PythonOrC/ISEF/Research Paper/research paper.tex

\documentclass[twoside]{article}
\usepackage{biblatex} %Imports biblatex package
\addbibresource{snake.bib}
\usepackage{blindtext} % Package to generate dummy text throughout this template 
\usepackage{amsmath}
\usepackage[sc]{mathpazo} % Use the Palatino font
\usepackage[T1]{fontenc} % Use 8-bit encoding that has 256 glyphs
\linespread{1.05} % Line spacing - Palatino needs more space between lines
\usepackage{microtype} % Slightly tweak font spacing for aesthetics

\usepackage[english]{babel} % Language hyphenation and typographical rules
\usepackage[hmarginratio=1:1,top=32mm,columnsep=20pt]{geometry} % Document margins
\usepackage[hang, small,labelfont=bf,up,textfont=it,up]{caption} % Custom captions under/above floats in tables or figures
\usepackage{booktabs} % Horizontal rules in tables

\usepackage{lettrine} % The lettrine is the first enlarged letter at the beginning of the text
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

\tikzstyle{startstop} = [rectangle, rounded corners, 
minimum width=3cm, 
minimum height=1cm,
text centered, 
draw=black, 
fill=red!30]

\tikzstyle{coord} = [
coordinate, 
node distance=2cm
]

\tikzstyle{io} = [trapezium, 
trapezium stretches=true, % A later addition
trapezium left angle=70, 
trapezium right angle=110, 
minimum width=3cm, 
minimum height=1cm, text centered, 
text width=3cm,
draw=black, fill=blue!30]

\tikzstyle{process} = [rectangle, 
minimum width=3cm, 
minimum height=1cm, 
text centered, 
text width=3cm,
draw=black, 
fill=orange!30]

\tikzstyle{decision} = [diamond, 
minimum width=4cm, 
minimum height=2cm, 
text centered, 
aspect=2,
draw=black, 
text width=3.5cm,
fill=green!30]

\tikzstyle{arrow} = [thick,->,>=stealth]
\usepackage[colorinlistoftodos]{todonotes}
\usepackage{hyperref} % For hyperlinks in the PDF
\graphicspath{{images/}}
\counterwithin{figure}{section}
\renewcommand{\thefigure}{\arabic{section}.\arabic{figure}}
\usepackage{parskip}
\counterwithin{table}{section}
\renewcommand{\thetable}{\arabic{section}.\arabic{table}}
\usepackage{pgfplots}
\pgfplotsset{compat=1.11}
%----------------------------------------------------------------------------------------
%	TITLE SECTION
%----------------------------------------------------------------------------------------

\setlength{\droptitle}{-4\baselineskip} % Move the title up

\pretitle{\begin{center}\Huge\bfseries} % Article title formatting
\posttitle{\end{center}} % Article title closing formatting
\title{Research on a multi-degree-of-freedom modular soft snake robot} % Article title
\author{%
\textsc{Ethan Hu} \\[1ex] % Your name
\normalsize The Overlake School \\ % Your institution
\normalsize \href{mailto:ethanhu8351@gmail.com}{ethanhu8351@gmail.com} % Your email address
%\and % Uncomment if 2 authors are required, duplicate these 4 lines if more
%\textsc{Jane Smith}\thanks{Corresponding author} \\[1ex] % Second author's name
%\normalsize University of Utah \\ % Second author's institution
%\normalsize \href{mailto:jane@smith.com}{jane@smith.com} % Second author's email address
}
\date{\today} % Leave empty to omit a date
\renewcommand{\maketitlehookd}{%
\begin{abstract}
\noindent 
	Soft-body robots have always received less attention compared to other branches of robotics. However, this does not suggest that they are any less capable than traditional robots due to their extreme flexibility. Soft robots commercially can be used in medical situations and with human interaction. This includes deployment into a human's body. However, the use case also extends into disaster relief situations. The flexibility of soft robots gives them an advantage over rigid robots when they are navigating through narrow spaces. Because of this flexibility, designing an optimized and sturdy system is difficult. In this paper, I proposed a new soft-body snake that is more optimized for real-life situations.
	
	The goal of this study is to create a better version of the soft robotic snakes already developed. This can be divided into two parts: software, and hardware. The software part would include software on the robot, and software on controller. The robot will send a video stream from the camera back to the controller, which will be a phone, as it is both lightweight and accessible. The user can also control the robot via the built-in controls through WiFi.
	
	The goal for the hardware part of the robot is to implement a more efficient flexible structure that better utilizes the air pressure and moves more controllably. The structures previous soft robotic snakes utilize is requires high air pressure and the expansion is rather uncontrolled and unideal. The structure is also very complicated and the connection between the flexible and rigid parts is hard to work with, not to mention the difficulties with preventing leakage of air with those structures.
\end{abstract}
}

%----------------------------------------------------------------------------------------

\begin{document}

% Print the title
\maketitle

%----------------------------------------------------------------------------------------
%	ARTICLE CONTENTS
%----------------------------------------------------------------------------------------

\section{Introduction}
\subsection{Background}
\lettrine[nindent=0em,lines=3]{E} very second counts after a disaster yet rescue teams cannot always get to places needing the most help right away due to obstacles and often dangers. This could include collapsed buildings, flooded tunnels, ablaze rooms, etc. To shorten the time between the disaster providing aid, mere human isn't enough. Specialized robots for different deadly environments are needed to support the rescue effort better. 

Collapsed buildings can be seen anywhere after almost all types of disasters — earthquakes, hurricanes, tsunamis, etc. Clearing a path through tons of debris is both time-consuming and laborious. To explore this environment more efficiently and more easily, a much smaller robot, and much more suited for this situation is needed — a soft robotic snake.

Soft robotic snakes are a type of soft robots that can imitate the capabilities of biological snakes, such as flexibility, adaptability, and locomotion \cite{bsf20}\cite{rt15}. Soft robotic snakes have potential applications in inspection, search-and-rescue, disaster response, and medical fields \cite{lwsstcgyo20}\cite{wsqsglfo}. They are naturally perfect for slithering through tight gaps and small tubes that the rescuers would otherwise be unable to cross. This could drastically speed up the exploration of ruined areas and the time takes to get to the ones needing help. Although this cannot fully replace the purpose of human rescuers and the need to clear up the area to people, this can provide some emergent aid while the main rescue force is on its way. 

\begin{figure}
\centering
\begin{subfigure}[b]{0.45\linewidth}
	\centering
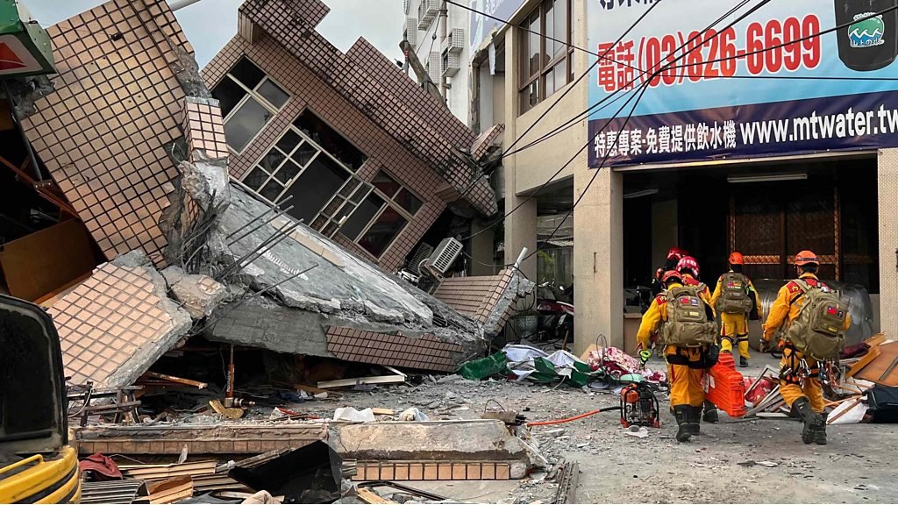
[picture p62: Research Paper/images/ruins.jpg]
	
	\subcaption{Collapsed building after earthquake can be especially dangerous for rescuers}
\end{subfigure}
\begin{subfigure}[b]{0.45\linewidth}
	\centering
	
	\subcaption{Some narrow passages are so small that rescuers cannot fit through}
\end{subfigure}
\caption{Examples of imagined use cases}
\end{figure}

\subsection{Current Studies}
This life-saving robot is of course not a completely new area of study \cite{cycc21}\cite{klt13}\cite{m18}. Many researchers have already attempted to recreate this fascinating animal. However, designing and controlling soft robotic snakes pose significant challenges due to their complex morphology, nonlinear dynamics, and high degrees of freedom \cite{Paap2000ARS}\cite{Matsuno2003ControlOR}\cite{Hirose2004BiologicallyIS}. The design of soft body robotic snakes involves the use of flexible materials, such as silicone, that can bend and twist without damaging the robot \cite{llcl19}. The snakes are controlled using various techniques, including pneumatic, hydraulic, and electrical actuation \cite{llcl19}\cite{lschw21}\cite{Palmre2014NanothornEF}. Unlike pneumatic and hydraulic, which are both powered by fluids, electrical actuation makes use of a flexible, elastic polymer that changes shape when a volage is applied \cite{gbzsp20}\cite{doi:10.2514/6.2001-1492}. Wright and his team developed a simple modular robotic snake design using chained servos \cite{Wright2007DesignOA}. Crespi and his team developed a more complicated robotic snake involving DC motors and detachable wheels to traverse both on the ground and in water \cite{Crespi2006AmphiBotIA}. However, rigid bodies cannot fully mimic the movement of snakes as these robots can only move at the joints. Thus, many turned to softer and more flexible materials to achieve smoother turns\cite{Onal2013AutonomousUS}\cite{Skorina2018ReversePA}. In a report presented at the International Conference of Soft Robotics \cite{qwsslo18}, Qin and his team used silicon tubes to achieve segments with 3 degrees of freedom (DoF). Each tube is responsible for 1 DoF and with three tubes, the soft robotic snake can perform locomotion much closer to that of a real snake than the rigid robotic snake. However, their design is much more complicated than the ones previously mentioned, as flexible material and air pressure are much harder to work with than rigid material and pulse-width modulation (PWM) signals. Apart from the production difficulties this design also lacks a more autonomous control system and a real-time feedback system that is crucial to its real-world applications. 

%------------------------------------------------

\section{Theoretical Design}
\subsection{Design Mentality}
As a soft-body robot, it has both flexible and rigid parts. Therefore, I split the designing task into two parts and approached them independently. I first worked on the flexible structures, which are the moving parts, and then designed the rigid structures holding the flexible structures in place and connecting them together. After finishing the general structure of the robot, I then added the electrical components to it.

\begin{figure}[H]
	
	\centering
	\caption{A complete segment of the snake}
\end{figure}

\subsection{Snake Locomotions}
The locomotion of snake has been categorized into four modes: serpentine (lateral undulation), concertina, sidewinding, and rectilinear. Serpentine locomotion is the mostly commonly seen motion and is usually the movement people associate with snakes. The snake would seem like it is moving is an "S" shape. They move forward by pushing each S-loop against objects on the ground in order to move forward. This is generally the fastest and most efficient mode, but when a snake is in tighter spaces where such movement is not possible, concertina lomotion is a slower alternative method. A snake first anchors its tail and then extends its body forward, and then anchors its head to draw its tail in. The next cycle begin and the snake gradually moves forward. This opening and closing action resembles that of a concertina, hence receiving its name "concertina locomotion". When encountering less friction on the ground or when the ground is hot, sidewinding locomotion is preferred. This is usually observed by snakes living in desert as the sand provides little support and its temperature can be lethal. As the name suggests, the snake moves sideways. Somewhat like lateral undulation, this method also forms loops, but instead of pushing against objects on the ground, the snake pushing against the ground and lifts the loops up and only contacts the ground at a few points at a given moment. The snake then shifts the contact point downwards to the tail while a new loop forms. When the snake is in a extremely narrow terrain where even concertina is not viable, the snake uses rectilinear locomotion. The snake moves in a straight line by alternately lifts its belly and pushing downwards to the back. 

\begin{figure}[H]
\centering

\caption{Visual Representation of the four modes}
\end{figure}

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

\begin{figure}[H] 
	\centering
	
	
	\caption{The shape of the silicon body}
\end{figure}
\begin{figure}[H]
	\centering

	\begin{minipage}[b]{0.3\textwidth}
		\centering
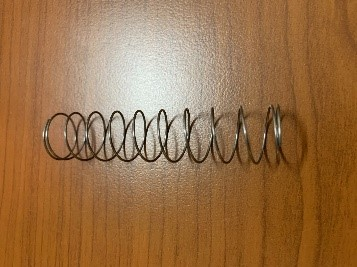
[picture p63: Research Paper/images/spring.jpg]
		
		\caption{spring used in the silicon part}
	\end{minipage}
	\hspace*{2cm}
	\begin{minipage}[b]{0.3\textwidth}
		\centering
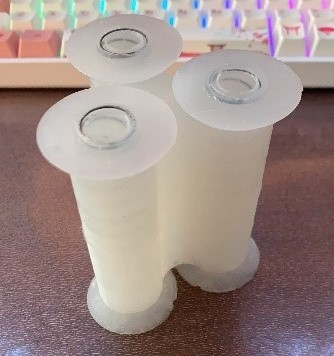
[picture p64: Research Paper/images/silicon_with_spring.jpg]
		
		\caption{the silicon part with embedded spring}
	\end{minipage}

\end{figure}

\subsection{Rigid Structure}
The rigid structures are going to be made of acrylic as it is both a strong material and can be easily processed by my CNC router. There will be two pieces of acrylic on each side of the silicon part to secure it in place, and one end will house the air valve and the electronics. Each silicon part will be independent of the others to ensure modularity.

\begin{figure} [H]
	\centering
	
	\caption{CAD file of the acrylic plates}
\end{figure}

\subsection{Silicon Body Parameters}
Before making any molds and actual parts, I wanted to test different wall thicknesses and inner diameters to find one that is most ideal for my use case. I used Simulia Abaqus to simulate the results to ensure that all variables are controlled, and only the independent variable changes. The First experiment is to determine the best wall thickness. For this, I chose three different thicknesses, 4mm, 5mm, and 6mm with a uniform diameter of 15mm. I predicted that the thinner the wall is, the larger the angle gets, which matched the actual results from the simulation.

\begin{table} [H]
	\centering
	\begin{tabular}{|c|c|c|c|c|}
	\hline
	Wall Thickness (mm) & $T_{1}$ Angle (\degree) & $T_{2}$ Angle (\degree) & $T_{3}$ Angle (\degree) & $T_{4}$ Angle (\degree)\\
	\hline
	4 & 22.5 & 32.07 & 41.36 & 42.7\\
	\hline
	5 & 18.96 & 29.8 & 34.22 & 36.98\\
	\hline
	6 & 4.96& 19.85 & 24.18 & 29.9\\
	\hline
	\end{tabular}
	\caption{The angle of the silicon arts with various wall thicknesses at different times of simulation}
\end{table}

\begin{table} [H]
	\centering
	\begin{tabular}{|c|c|}
	\hline
	Wall Thickness (mm) & largest Angle (\degree)\\\hline
	4 & \\\hline
	5 & \\\hline
	6 & \\\hline
	\end{tabular}
	\caption{The final angle after the silicon is fully inflated}
\end{table}

Then, I tested the effect of inner diameter on the max angle the part can bend. I predicted that the angle is inversely proportional to the diameter as a larger diameter result in a larger surface area, and thus the pressure is more spread out and can deform the silicon less. Turns out the hypothesis was partially correct. While the 14mm starts with smaller angles, it has the largest angle.

\begin{table} [H]
	\centering
	\begin{tabular}{|c|c|c|c|c|}
	\hline
	Chamber Diameter (mm) & $T_{1}$ Angle (\degree) & $T_{2}$ Angle (\degree) & $T_{3}$ Angle (\degree) & $T_{4}$ Angle (\degree)\\
	\hline
	14 & 10.55 & 23.43 & 33.64 & 38.88\\
	\hline
	15 & 	18.96 & 	29.8 & 	34.22	 & 36.98\\
	\hline
	16	 & 21.42	 & 29.31	 & 34.24	 & 34.93\\
	\hline
	\end{tabular}
	\caption{The angle of the silicon parts with various inner diameters at different times of simulation}
\end{table}

\begin{table} [H]
	\centering
	\begin{tabular}{|c|c|}
	\hline
	Wall Thickness (mm) & largest Angle (\degree)\\
	\hline
	4 & \\
	\hline
	5 & \\
	\hline
	6 & \\
	\hline
	\end{tabular}
	\caption{- The maximum angle the silicon parts can reach. 14mm version has the largest angle}
\end{table}

%------------------------------------------------
\section{Construction}

\subsection{Overall Structure}
As mentioned, the structure is designed intentionally to be modular, meaning that the length of the robot can be adjusted depending on the need. This also helps with maintenance as parts can be easily replaced. At the end, the final implemented design is as follows. The front has an OpenMV module attached and then each segment follows is identical. Tubing for air runs along the snake and whether the chamber inflates or not is controlled by air valves placed at the entrance of the chamber. The silicon body is connected using acrylic sheets pushed together. The chambers are placed in a triangular pattern with a hold in the middle for wires and tubing. This shape provides stability and functionality. The top has one chamber to push down the robot for better friction and contact while two chambers on the bottom control turning. The robot is propped on fixed rubber wheels to add friction and reduce wear on the acrylic and silicon parts. 

\begin{figure} [H]
	\centering
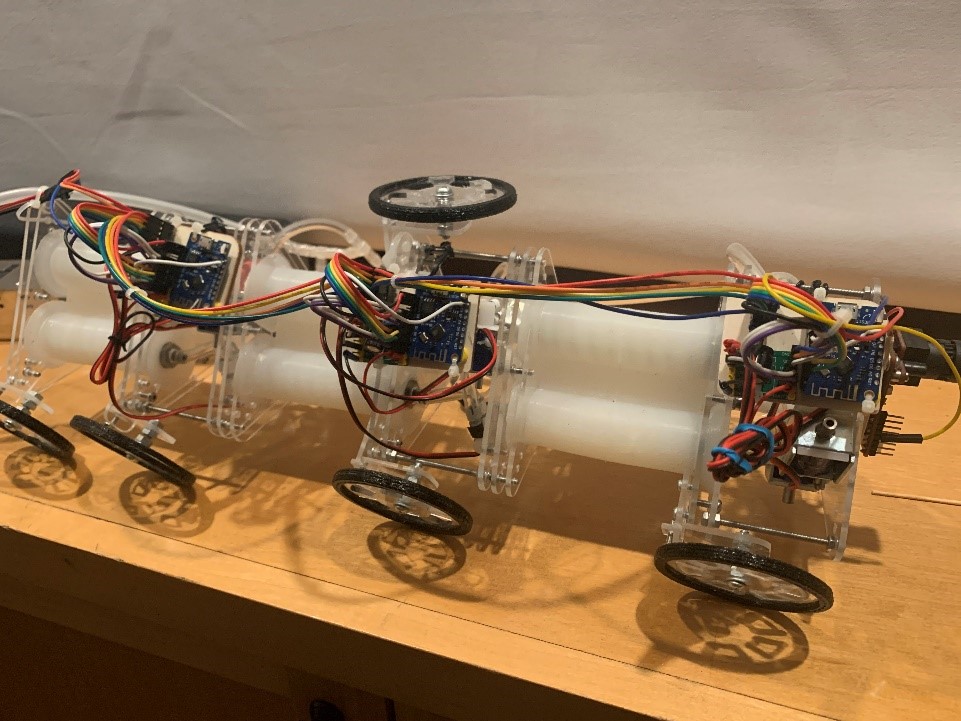
[picture p65: Research Paper/images/completed_snake.jpg]
	
	\caption{Three segments of the robot wired together}
\end{figure}

\subsection{Robotic Snake Locomotion}
For this robotic snake, two locomotion are chosen out of the four, which are serpentine and rectilinear locomotion. Serpentine is chosen because it is ideal in more spacious areas and can be mimicked by the robot. Rectilinear is chosen because it is ideal to be used in more narrow areas with little room to bent. Sidewinding are not implemented because of the difficulty of lifting parts of the robot due to the weight. Concertina is not implemented because the current pneumatic configuration cannot allow a chamber to hold positive pressure without allowing air to escape or enter as the solenoid valve is either connected to the outside or to the air pump which represents deflation and inflation respectively. 

To replicate the serpentine locomotion, each segment of the snake will inflate in the opposite direction of the previous segment. For example, if the first segment has the top and right segment inflated, then the second segment will have the top and the left segment  inflated. This curves the snake into an S-shape just like a real snake. However, instead of pushing against an object on the ground, the snake pushes down on the ground with rubber wheels to add friction and thus pushing the robot forward. 

To replicate the rectilinear locomotion, each segment will inflate all three chambers and then deflate at the same time in order move forward without turning.

\subsection{Tools}
Throughout the design of the structures, I relied heavily on a few tools. First is the designing tools. For CAD, I used a combination of Fusion 360, AutoCAD, and SolidWorks. Fusion 360 is used the most for general designs as its interface is simple and modern. I used AutoCAD to design two-dimensional sketches which are then sent to the CNC router. I used SolidWorks for assembling the different components of the snake together to check for interference and oversights in the designs. 

These designs are then brought to reality with one of the two manufacturing processes. The first being FDM (Fused Deposition Modeling) 3D printing. Most of the 3D printed parts are with the 1.75mm PLA filaments as it is 100\% biodegradable and bio-sourced. It is also easy to print with and nontoxic like ABS, another popular choice of material. The other method is with a CNC router. All acrylic sheets are processed with a single flute flat end mill.

I also used both Fritzing and Altium Designer for presentation of circuit diagrams and SMCDraw for the pneumatic circuit diagram.

\begin{figure}[H]
	\centering
	
	\begin{minipage}[b]{0.4\linewidth}
		\centering
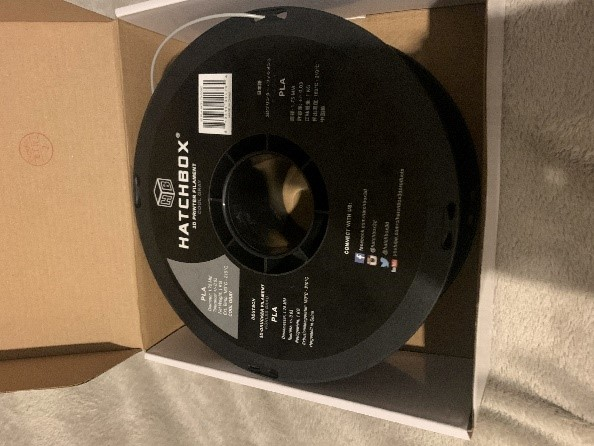
[picture p66: Research Paper/images/pla.jpg]
		
		\caption{HatchBox Gray 1.5mm PLA Filament I used}
	\end{minipage}
	\hfill	
	\begin{minipage}[b]{0.4\linewidth}
		\centering
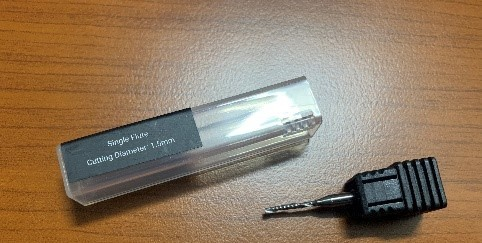
[picture p67: Research Paper/images/mill_bit.jpg]
		
		\caption{Single Flute Flat End Mill with a cutting diameter of 1.5mm}
	\end{minipage}
\end{figure}

\subsection{Silicon Casting}
Below is the procedure of how I cast the silicon parts. Before starting, I first measured the mass of the total silicon I needed, which is about 130g. Since this specific 10A silicon rubber has two parts: A and B with a ratio of 1:1, I prepared 65g of each. 
\begin{figure} [H]
	\setlength\itemsep{-8pt}
	Procedure:
	\begin{enumerate}
 		\item Assembled the mold
 		\item pour 65g of part A into a cup
 		\item add 65g of part B
 		\item stir the mixture clockwise for 3 minutes
 		\item pour the mixture into the mold
 		\item vacuum for 3 minutes to degas the silicon
 		\item break the vacuum and wait for 24 hours to cure
 		\item remove the mold
	\end{enumerate}
\end{figure}
\begin{figure}[H]
	\centering
	\begin{subfigure}[b]{0.33\linewidth}
		\centering
		
		\subcaption{Assemble the mold}
	\end{subfigure}%
	\begin{subfigure}[b]{0.33\linewidth}
		\centering		
		
		\subcaption{weigh part a}
	\end{subfigure}%
	\begin{subfigure}[b]{0.33\linewidth}
		\centering
		
		\subcaption{add part b}
	\end{subfigure}
	
	\begin{subfigure}[b]{0.33\linewidth}
		\centering
		
		\subcaption{pour mixture into mold}
	\end{subfigure}%
	\begin{subfigure}[b]{0.33\linewidth}
		\centering		
		
		\subcaption{vacuum to degas}
	\end{subfigure}%
	\begin{subfigure}[b]{0.33\linewidth}
		\centering
		
		\subcaption{extract the finished silicon part}
	\end{subfigure}%
	\caption{Steps of making silcon parts}
\end{figure}
\subsection{Silicon Mold Revisions}
Each part of the robot has gone through multiple iterations. Especially the components related to the silicon body. 

The first version used wooden sticks which have a diameter of 12mm and springs with a diameter of 14mm. The smaller circle at the bottom is used to secure the wooden stick while the outer ring is used to hold the spring. The cutouts are used to hold the M3 hex nut. There are a total of three cutouts located near the top of the bottom part. Respectively, there are three through holes on each part that matches up. They are the holes for the M3 screws. Screws are used in this mold to apply pressure to the seam to minimize the silicon from leaking. However, this proved to be unnecessary as the fit can be tight enough to contain the silicon when the right amount of tolerance is applied. There is a ring of silicon both on the bottom and the top of the mold. This is to make sure that the acrylic plates can secure the silicon in place without it detaching.

\begin{figure}[H]
	\centering
	\begin{subfigure}[b]{0.33\linewidth}
		\centering
		
		\subcaption{Top CAD with Cross Section}
	\end{subfigure}%
	\begin{subfigure}[b]{0.33\linewidth}
		\centering		
		
		\subcaption{Bottom CAD with Cross Section}
	\end{subfigure}%
	\begin{subfigure}[b]{0.33\linewidth}
		\centering
		
		\subcaption{Plate CAD route}
	\end{subfigure}
	
	\begin{subfigure}[b]{0.33\linewidth}
		\centering
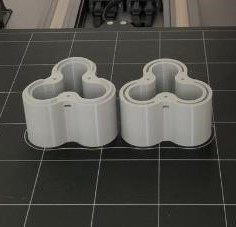
[picture p68: Research Paper/images/top_bottom_printed.jpg]
		
		\subcaption{Top and Bottom Printed}
	\end{subfigure}%
	\begin{subfigure}[b]{0.33\linewidth}
		\centering		
		
		\subcaption{Cover Plate cut with CNC}
	\end{subfigure}%
	\begin{subfigure}[b]{0.33\linewidth}
		\centering
		
		\subcaption{the mold assembled}
	\end{subfigure}%
	\caption{Version 1 of the Mold}
\end{figure}

There are a few issues with this version. First, the use of the wooden stick meant that the size of the inner hole was unchangeable. This is especially problematic for experimenting with different wall thicknesses. Another issue was the sealed top plate. This meant the bubbles from the silicon cannot escape and would be trapped at the top making the surface uneven. The ring of silicon also was proven too small to keep the part in place. Applying a small amount of force will separate the plates and the silicon part. Due to the density of the stick, the inner surfaces of the silicon part were also not aligned properly. 

To test a variety of wall thicknesses, a new bottom with fixed pillars that is 14mm in diameter is designed. The ring was also enlarged to make ensure the part is secured. Since the stick no longer needs to be held in place by the plate and the bottom, The top was also removed to make sure no bubbles are formed. This new version had larger pillars but since it was fixed onto the mold, they had to be destroyed to extract the silicon body. 

\begin{figure} [H]
\centering

\caption{Version 2 of the mold. The stick is attached to the base, which made the removal of the mold from the silicon impossible}
\end{figure}

The third version redesigned the bottom so that the walls and the base detach. This means that the pillars and the base can be pulled out before removing the silicon body. Although the base was still difficult to remove, it can now be used multiple times. During the tests, it was also proven that the seal between the acrylic plates securing the silicon part and the silicon was too weak to withstand high pressures. Therefore, another silicon mold was added to create a thin layer of silicon that will be glued to the end to ensure an air-tight seal. 

\begin{figure} [H]
\centering
\begin{subfigure}[b]{0.5\linewidth}
		\centering
		
		\subcaption{Version 3 of the mold with a new detachable base}
	\end{subfigure}%
	\begin{subfigure}[b]{0.5\linewidth}
		\centering		
		
		\subcaption{Newly added mold for sealing}
	\end{subfigure}
\caption{Version 3 of the mold}
\end{figure}

However, gluing two silicon parts together soon proved weak. It cannot contain the amount of pressure needed to move the snake. Therefore, a new mold is designed. This one allowed the silicon to be molded all at once and it only had one opening which is for the valve and the input for air. It flipped the orientation of the silicon part in the mold upside-down as now the only opening is now facing down. The pillars are now independent from the base and is secured by the hole in the bottom plate. The silicon part will be first removed from the mold with the pillars and then the pillars will be pulled out.

\begin{figure} [H]
\centering
\begin{subfigure}[b]{0.5\linewidth}
		\centering
		
		\subcaption{Version 4 of the mold with detachable pillars}
	\end{subfigure}%
	\begin{subfigure}[b]{0.5\linewidth}
		\centering		
		
		\subcaption{Assembled Mold}
	\end{subfigure}
\caption{Version 4 and the final version of the mold}
\end{figure}

\subsection{Communication Protocol}
Although it was established that the segments are going to be designed with the idea of modularity, the actual approach changed. The first iteration was using ESP8266 as a microcontroller for each segment, and there will be one for each segment. They will be connected using I2C and instructions are going to be sent from the OpenMV module at the front. However, after some research and experiment, it was concluded that although labeled with such a feature, ESP8266 doesn't support receiving I2C. Thus, the protocol was switched to Serial, which provides similar functionality but requires me to program my own communication protocols while I2C has this functionality packaged already.

\subsection{Airway}
There is one overall air pump that sends air through the clear PVC tubing, and this pump is capable of exerting 12kPa. The air from the pump is them separated into tubing for each segment and then each solenoid valve. The valve tubing is then connected to a custom-printed valve core that ensures an air-tight seal between the tubing and the silicon chamber. There are two states of the solenoid valve and when it is powered, the air flows into the silicon chamber, and when the valve is not powered, the air flows out from the chamber. When the top and the left solenoid valve is powered, the air flows into those two chambers and bents this segment towards the right and when the top and the right solenoid valve are powered, the segment bends left. 

\begin{figure}[H]
	\centering
	\begin{subfigure}[b]{0.33\linewidth}
		\centering
		
		\subcaption{Solenoid valve connected to the valve and silicon chamber}
	\end{subfigure}%
	\begin{subfigure}[b]{0.33\linewidth}
		\centering		
		
		\subcaption{Air pump used}
	\end{subfigure}%
	\begin{subfigure}[b]{0.33\linewidth}
		\centering
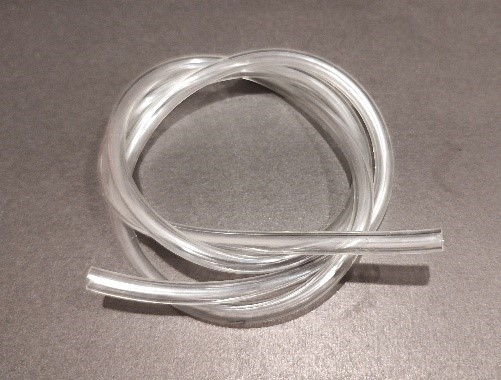
[picture p69: Research Paper/images/pvc_tubing.jpg]
		
		\subcaption{PVC tubing used}
	\end{subfigure}
	
	\begin{subfigure}[b]{0.33\linewidth}
		\centering
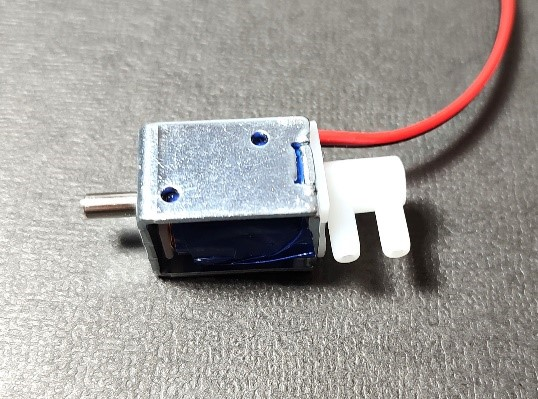
[picture p70: Research Paper/images/solenoid valve.jpg]
		
		\subcaption{solenoid valve used}
	\end{subfigure}%
	\begin{subfigure}[b]{0.33\linewidth}
		\centering		
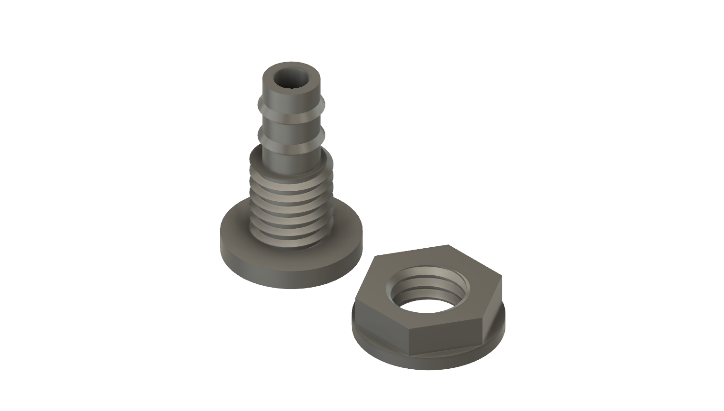
[picture p71: Research Paper/images/valve.png]
		
		\subcaption{CAD of the valve}
	\end{subfigure}%
	\begin{subfigure}[b]{0.33\linewidth}
		\centering
		
		\subcaption{CAD of the valve with cross section}
	\end{subfigure}%
	\caption{Components of the pneumatic system}
\end{figure}

\begin{figure} [H]
	\centering
	
	\caption{Pneumatic Circuit design of four segments of the snake}
\end{figure}

\subsection{Change to Standoffs}
The actual structure differed from the design in the connecting pieces. The original designed used brass standoffs of various lengths while the actual structure made use of long bolts. This is because the longs screw allows for finer adjustments that the brass standoffs cannot provide, and this is especially important during prototyping phase as changes are made frequently. 

\subsection{Wheels}
At firs the wheel is just the acrylic cutout, but the acrylic wheel provided poor friction and was not enough to push the robot forward. Thus, I 3D printed some grooved wheels with a TPU filament. TPU is a soft and flexible material which the most ideal material to be used to 3D print a wheel as it is easier to print compared to other flexible materials while still offer a good coefficient of friction. 

\begin{figure}[H]
	\centering
	\begin{subfigure}[b]{0.5\linewidth}
		\centering
		
		\subcaption{CAD of half of the tire}
	\end{subfigure}%
	\begin{subfigure}[b]{0.5\linewidth}
		\centering		
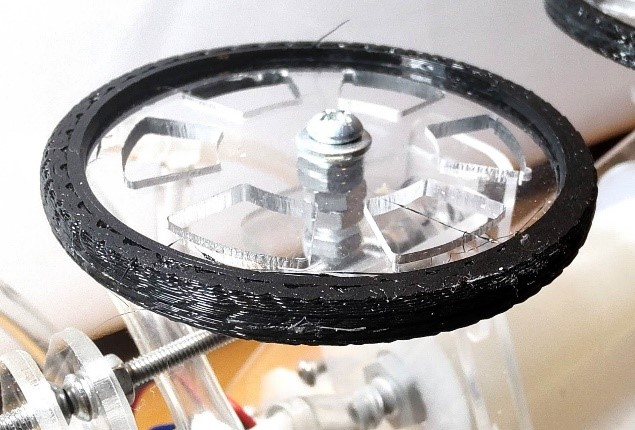
[picture p72: Research Paper/images/full_tire.jpg]
		
		\subcaption{Two halves of the tire glued together to the acrylic rim}
	\end{subfigure}
	\caption{Tires used in the robot}
\end{figure}

%------------------------------------------------

\section{Electrical Design}

Two different boards are used, the ESP32CAM module and the ESP32 module without the camera. The ESP32CAM at the front of the robot is used for sending video stream back to the phone, receiving the controls, as well as for sending signals to each segment and controlling the movement of the robot. It is programmed in arduino. Each subsequent ESP32 is a receiver for the commands and a controller of the three solenoid valves on a segment, which controls whether then controls the flow of the air. ESP32 can be coded in Arduino and is feature packed. Although right now each segment is connected through I2C, the on-board Wi-Fi module allows the possibility to communicate via Wi-Fi with the other modules in the future. The ESP32 is connected to an small relay which is then connected to the solenoid valves. 

\begin{figure}[H]
	\centering
	\begin{subfigure}[b]{0.33\linewidth}
		\centering
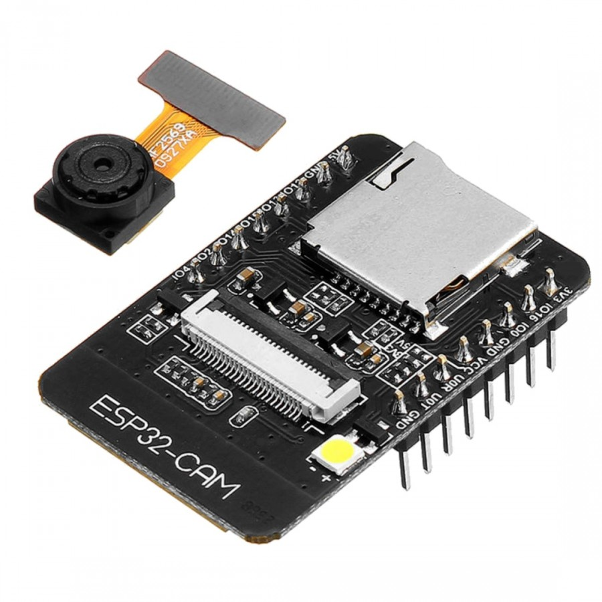
[picture p73: Research Paper/images/esp32cam.jpg]
		
		\subcaption{ESP32CAM Module}
	\end{subfigure}%
	\begin{subfigure}[b]{0.33\linewidth}
		\centering		
		
		\subcaption{ESP32 Module}
	\end{subfigure}%
	\begin{subfigure}[b]{0.33\linewidth}
		\centering
		
		\subcaption{Relay}
	\end{subfigure}
	\caption{Components of the electric system}
\end{figure}

\begin{figure} [H]
	\centering
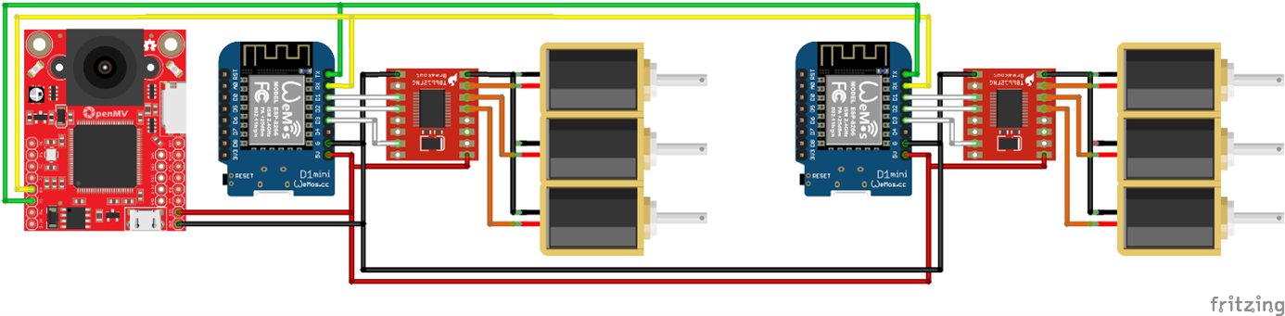
[picture p74: Research Paper/images/wiring_diagram.png]
	
	\caption{Wiring Diagram of the first segment and the second segment}
\end{figure}

\begin{figure} [H]
\centering
	
	\caption{Schematic of the snake segment}
\end{figure}

\subsection{Driver}

Originally, I used the motor driver A4950, chosen for its small size. However, during testing, I found that I cannot power both left and right at the same time. Upon further examination, I narrowed the issue to the driver. Researching the driver revealed that for each set of pins (Ain1, Ain2, Aout1, and Aout2 is a set and Bin1, Bin2, Bout1, and Bout2 is another set), only one pair of input/output can be set to high at any given instance. For example, when Ain1 is set to high, Ain2 cannot be set to high, or else the logic of the circuit breaks and neither would be powered. This is because there is only one driver circuit for each set.

Based on this I came up with a few solutions. One way is to rewire it so that left and right solenoid valves are wired to the same set with the top wired to the other set. Because left and right won't be powered at the same time, the issue of sharing a circuit does not affect the performance. This does come at the cost of not being able to power all of them at the same time, which would be necessary for the rectilinear locomotion to work, which requires the inflation of all three chambers at the same time.

Or, I can just use two drivers for each segment so that each solenoid valve has its own driver circuit. Although this does add extra weight and size, it allows each solenoid valve to be controlled independently, which is necessary in the design. 

However, if I want the snake to work with any side up, none of the previous two solutions would work. Therefore, I decided to replace the drivers entirely and instead chose three small relays to drive the solenoids.

\section{Software Design}
%There are two movement types that the robot can perform depending on the environment and they all drew inspiration from the movements of a real snake. 
The serpentine locomotion is best for general purposes when there is a lot of open space. It is the S-shape movement people normally associate with snakes. 
%The other type is concertina locomotion. This is best suited for tighter spaces where the snake cannot perform serpentine locomotion. It curls its tail while keeping the front stationery, and then keeps its tail stationary and extends its front. This repetition of curling and extending allows the snake to travel at narrow pathways. Each of these is achieved by predefined controls in the front OpenMV. 
This motion is controlled by the front ESP32CAM module, which recieves signal from the phone via Wi-Fi and a MQTT server and HTTP protocol. The front main module separates the expected wave function into a series of movements and sends it to the specified receiving modules. Each module has a dedicated id that is unique to the segment so the main module can control the segments individually. 

The snake follows the graph of a \(y=\sin(x)\) function.
\begin{figure} [H]
	\centering
	\begin{tikzpicture}
		\begin{axis}
		\addplot[color=red]{sin(deg(x))};
		\end{axis}
	\end{tikzpicture}
	\caption{A Standard \(y=\sin(x)\) graph.}
\end{figure}

The main module determines which direction to curve each segment (or leave in neutral state) with the function \(y=A\sin(B\times x - C) + D\). \(A\) is the amplitude of the function, in this case, it is proportional to how wave the snake curves. \(B\) is the frequency of the function, that is, how horizontally compressed the function is, a larger \(B\) value means more curves in the same length of the robot. \(D\) is neglected in this function because it does affect the direction of travel. \(C\) is the horizontal shift of the function. In the case of the robot, this value is unique to each segment in order for the snake to move like a sine function. Each segment is slight offset to the right of the previous segment, which means that the segment will follow the motion of the previous. Thus, when all segments are combined, the snake forms a moving sine function. Because \(y=\sin(x)\) is a periodic function with a period of 2\(\pi\)/\(Speed\), the value of \(rads\) cycles through 0\degree to 360\degree . In the context of this code, the sine function is as follows. 

\centerline{\(k = \sin(Speed \times rads + id \times shift)\)}

%There are two controls currently. The first is manual, where the user can directly control the movement of the snake. The second is automatic, where the snake will use its front-facing camera to follow a certain object. Regardless of which method, the OpenMV module converts the desired locomotion into a series of movements each segment performs and is distributed to each ESP8266. Since they relate to the same Serial port, a package header with an address that is unique to each segment is attached to the beginning of the command to assign this instruction to a specific segment. Although the size of the package could be further decreased by using a nibble to represent each component (15 different addresses can be represented by a nibble not counting 0000, and technically only 2 bits are needed to represent the command), resulting in a much smaller package, it is hardly necessary because the speed to UART3 is fast enough and the number of packages are few enough that a 2-byte-sized package will not hinder the performance. 
%The OpenMV first initializes the UART and the state of each segment to 0, which represents a neutral, straight segment, except for the first segment, which is set to -1, which represents a segment curved to the right. Similarly, the number 1 represents a segment curved to the right. Then, the program checks for the locomotion. If the mode is serpentine, the the program updates the state of each segment to that of the segment in front of. After updating all segments including the first segment which is updated separately as there is no segments in front, the new state is then converted into a char that represents the command after which will result in the desired state. The OpenMV first sends the address of the segment that should receive this instruction and then follows it by the actual instruction. It does so for every segment, and then waits for the predefined amount of time, which is how long it takes to fully inflate the silicon chambers. After inflation, the state of the segment is updated again.
\begin{figure} [H]
	\centering
	\hspace*{3cm}%
	\begin{tikzpicture}[node distance=2cm, auto]
		\node (start) [startstop] {Start};
		\node (pro1) [process, below of=start] {Initialize state of each segment};
		\node (dec1) [decision, below of=pro1, yshift=-0.5cm] {Locomotion};
		\node (dec2b) [decision, below of=dec1, yshift=-1cm] {Direction};
		\node (dec2bb) [process, right of=dec2b, node distance=4cm, yshift=-1cm]{Reverse\\ segment\_addr list};
		\node (pro2ba) [io, below of=dec2b, yshift = -0.5cm]{send new angle value to segments};
		\node (pro3ba) [process, below of=pro2ba]{change inflation state of own segment};
		\node (pro4ba) [process, below of=pro3ba]{wait for chambers to inflate};
	
		\draw [arrow] (start) -- (pro1);
		\draw [arrow] (pro1) -- (dec1);
		\draw [arrow] (dec1) -- node[anchor=west] {Serpentine} (dec2b);
		\draw [arrow] (dec2b) -- node[anchor=west] {Forward} (pro2ba);
		\draw [arrow] (dec2b) -| node[anchor=south, xshift=-1cm] {Backward} (dec2bb);
		\draw [arrow] (dec2bb) |- (pro2ba);
		\draw [arrow] (pro2ba) -- (pro3ba);
		\draw [arrow] (pro3ba) -- (pro4ba);
	
		\node (c1) [coord, on grid, left of=pro4ba, node distance=1.5cm, xshift=-1cm] {};
		\draw [arrow] (pro4ba) -- (c1) |- (pro2ba);
	\end{tikzpicture}
	\caption{Flow chart how the front ESP32CAM commands each segment}
\end{figure}

Upon receiving a new \(rads\) value from the main module, each segment will calculate its own \(k\) value and perform the corresponding action depending on the value. I evenly divided the function into three parts; if \(k\) is within 1/6 and 1/2, the segment turns left; if it is within -1/6 and -1/2, the segment turns right; otherwise it stays neutral. When staying neutral, the segment will unpower all solenoid valves to release all chambers and have the silicon part return to neutral position. If the segment is turing left, the top and right solenoid valve will close and those two chambers will inflate, making the segment curve to the left. Similarly, if the segment is turning right, the top and left solenoid valve will close so the segment curves to the right. 

\begin{figure}[H]
	\centering
	\hspace*{-1cm}%
	\begin{tikzpicture} [node distance=2cm, auto]
		\node (start) [startstop, xshift=8cm] {Start};
		\node (dec1) [process, below of=start] {wait for packages};
		\node (dec2) [io, below of=dec1] {read new \(rads\) value};
		\node (dec3) [decision, below of=dec2, yshift=-0.5cm] {calculate \(k\) value};
		\node (pro4a) [process, below of=dec3, node distance=2.25cm] {stop powering all solenoids};
		\node (pro4b) [process, left of=pro4a, node distance=4cm] {power top + right solenoid};
		\node (pro4c) [process, right of=pro4a, node distance=4cm] {power top + left solenoid};
		\draw [arrow] (start) -- (dec1);
		\draw [arrow] (dec1) -- node {new pacakge} (dec2);
		\draw [arrow] (dec2) -- node {for this segment} (dec3);
		\draw [arrow] (dec3) -- node {\(-0.16 \le k \le -0.16\)} (pro4a);
		\draw [arrow] (dec3) -| node[anchor=south, xshift=1cm] {\(0.16 \le k\)} (pro4b);
		\draw [arrow] (dec3) -| node[anchor=south, xshift=-1cm] {\(k \le -0.16\)} (pro4c);
		\node (c1) [coord, on grid, right of=dec1, xshift=1cm] {};
		\node (c2) [coord, on grid, below of=pro4b, xshift=-2.5cm, yshift=1cm] {};
		\node (c3) [coord, on grid, above of=dec1, yshift=-1cm] {};
		\draw (pro4b) |- (c2) |- (c3);
		\draw (pro4a) |- (c2) |- (c3);
		\draw (pro4c) |- (c2) |- (c3);
	\end{tikzpicture}
	\caption{Flow chart of how each segment functions}
\end{figure}

\section{Tests}
Although simulations are a good way to observe the ideal behavior, it cannot replace the actual experiments. There are overall two types of tests I performed. The first is single segment tests where I took one segment out of the snake and took measurements of the performance indicated by the time to inflate, max angle, etc. Then, I tested the performance of the entire snake including travel speed and the control alogrithm.

\subsection{Single Segment Test}
I first tested the performance of a single segment in real life. The first test was unsuccessful as even the solenoid valves didn't open when powered. Normally, the solenoid valve would have a "click" sound when it is powered and unpowered. I also checked the power source, which outputs 12V and I've stepped it down to little more than 6V.

After check the voltage at different points, I concluded that when the current passed through the A4950 driver, a 5V current is outputted rather than the 6V input. It seems like the voltage would drop significantly after passing through A4950 until the input is around 8V, which is when the voltage drop stops and outputs the same voltage as input. After dialing the power input to 8V, the solenoid valves now work.

\begin{figure} [H]
\centering

\caption{Output with ~8V connected to an oscilloscope. Each grid is 1V.}
\end{figure} 

I filmed an top-down video of the first segment of the snake inflating and then imported into the software called Tracker from physlets.org to collect the data from the video. I first imported the video into the software. Then, I added a coordinate axis and aligned the y-axis along the snake. Measuring that the distance between the wheels of different segments to be 0.116 meters, I added a calibration stick to set the reference. Then I added a point mass tracking point and ran the autotracker. 

\begin{table} [H]
	\centering
	\begin{tabular}{|c|c|c|c|}
	\hline
	Time (s) & 1 & 2 & 3\\
	\hline
	$\Delta$x (cm) & 1.57 & 2.67 & 3.52\\
	\hline
	Image &  &  & \\
	\hline
	\end{tabular}
	\caption{- Screenshots of the segment inflating}
\end{table}

After testing, I plotted the x position relative to the time and the trend seems to be logarithmic. The maximum distance is 3.62cm at t=3.44s.
\begin{figure} [H]
\centering

\caption{x position of the point relative to time}
\end{figure}

\subsection{Two Segment Test}
Similar to the single segment test, I filmed an top-down video of the first segment of the snake inflating and then followed the same steps as I've previously done.

\begin{table} [H]
	\centering
	\begin{tabular}{|c|c|c|c|}
	\hline
	Time (s) & 1 & 2 & 3\\
	\hline
	$\Delta$x (cm) & 3.66 & 8.39 & 10.33\\
	\hline
	Image &  &  & \\
	\hline
	\end{tabular}
	\caption{- Screenshots of the segment inflating}
\end{table}

After testing, I plotted the x position relative to the time and the trend seems to be logarithmic. The maximum distance is 11.25cm at t=3.60s.
\begin{figure} [H]
\centering

\caption{x position of the point relative to time}
\end{figure}

\subsection{Entire Snake Test}
For this test, I followed similar procedures as the previous tests. The snake traveled 10.05cm in 14.74s with a speed of 0.68cm/s. The most likely cause of the decrease in rate after t=20s is due to the distortion of the video as it is now filming the snake at an angle. 

\begin{table} [H]
	\centering
	\begin{tabular}{|c|c|c|c|c|}
	\hline
	Time (s) & 5 & 10 & 15 & 20\\
	\hline
	$\Delta$x (cm) & 4.39 & 7.51 & 10.57 & 13.43\\
	\hline
	Image &  &  &  & \\
	\hline
	\end{tabular}
	\caption{- Screenshots of the segment in motion}
\end{table}

\begin{figure} [H]
\centering

\caption{Distance traveled by the snake over time}
\end{figure}

\section{Conclusion}
This project did not achieve everything planned at the beginning. It only achieved the basic function of the robot, yet it is lacking a lot of software to support it. The implementation of an AI image recognition system is crucial as well as a purely image-based mapping system is also yet to be done. A coordinate system is also necessary to know the actual location of the snake. Without these, the robot cannot achieve its full potential as a life-saving device. Apart from the software, the silicon body design will also need to be improved as the current design does not make use of the pull potential of the air pressure. The movement algorithm can also be improved as right now the robot moves rather slowly. 

%----------------------------------------------------------------------------------------
%	REFERENCE LIST
%----------------------------------------------------------------------------------------

\printbibliography

%----------------------------------------------------------------------------------------

\end{document}
