PythonOrC/ISEF/GO Paper/images/A4950.jpeg

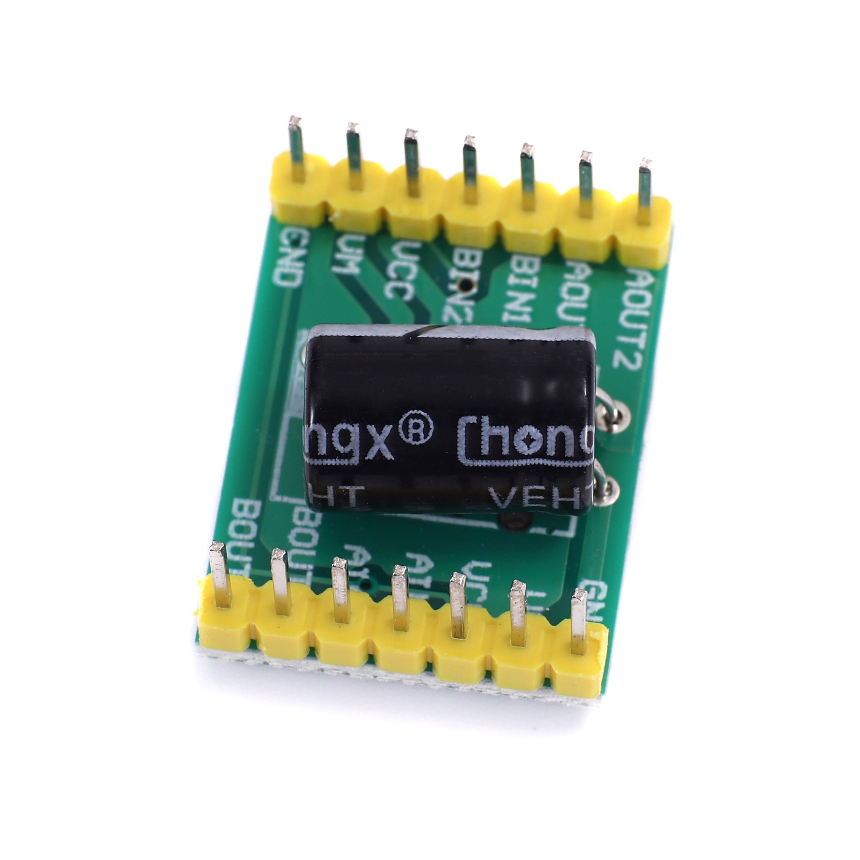
GO Paper/images/A4950.jpeg
