PythonOrC/ISEF/GO Paper/images/air pump.jpeg

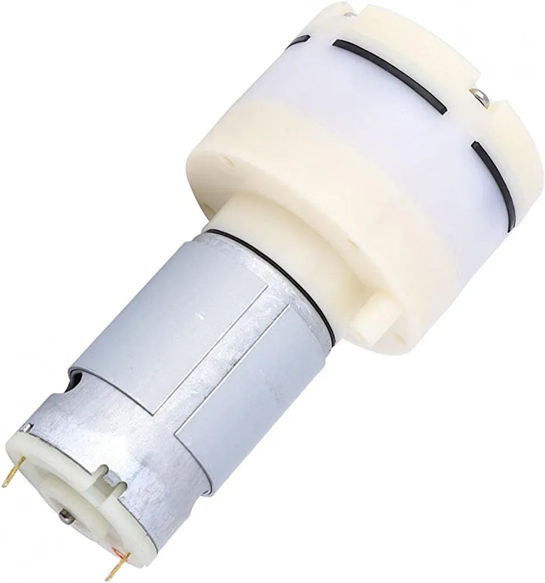
GO Paper/images/air pump.jpeg
