PythonOrC/ISEF/GO Paper/images/Drawing1.jpg

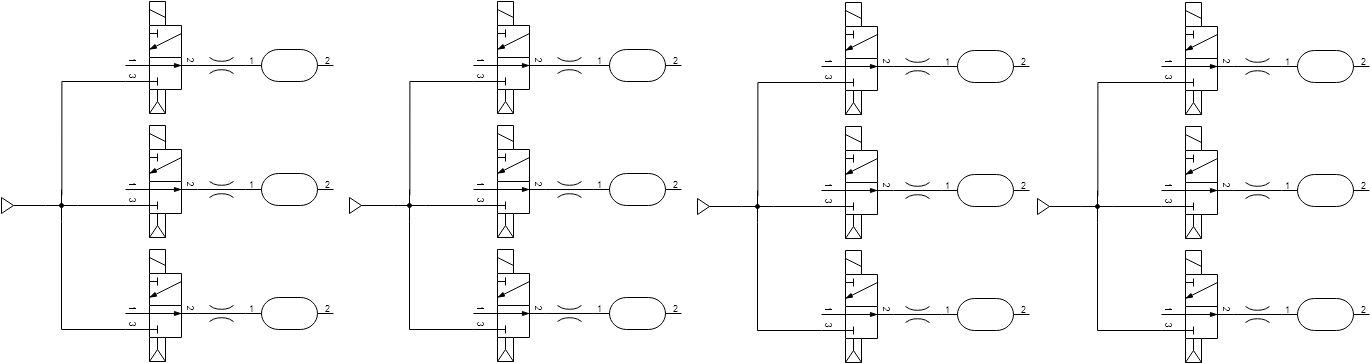
GO Paper/images/Drawing1.jpg
