PythonOrC/ISEF/GO Paper/images/esp32.jpeg

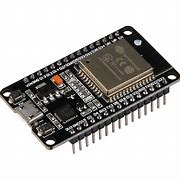
GO Paper/images/esp32.jpeg
