PythonOrC/ISEF/GO Paper/images/ESP8266.jpeg

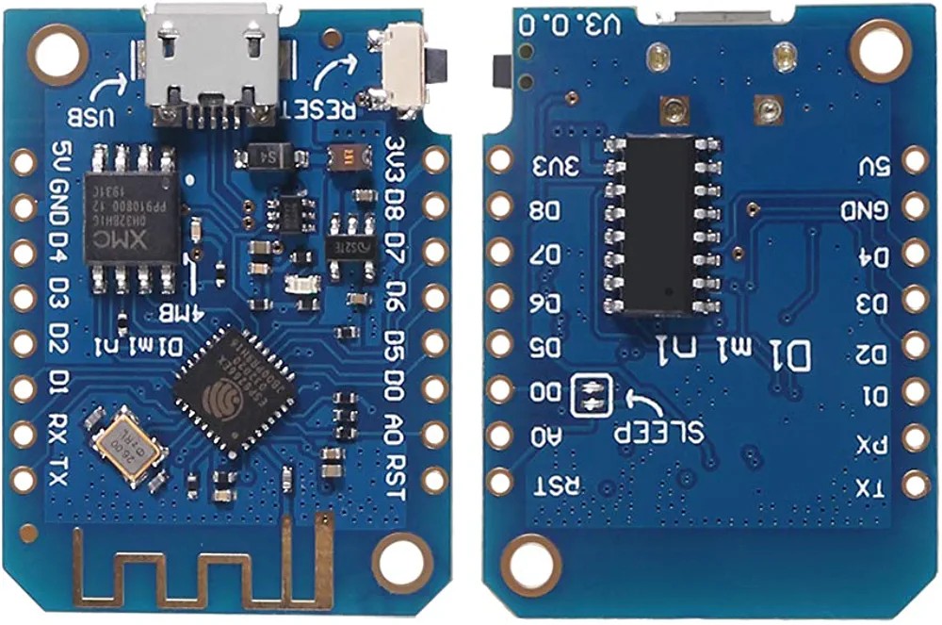
GO Paper/images/ESP8266.jpeg
