PythonOrC/ISEF/GO Paper/images/extract.jpeg

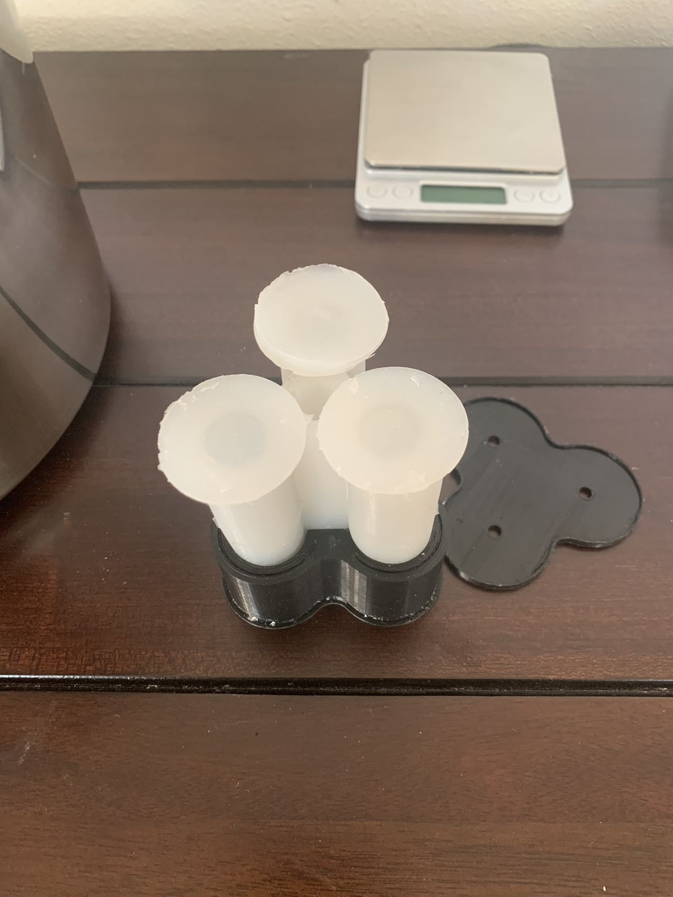
GO Paper/images/extract.jpeg
