PythonOrC/ISEF/GO Paper/images/mill_bit.jpeg

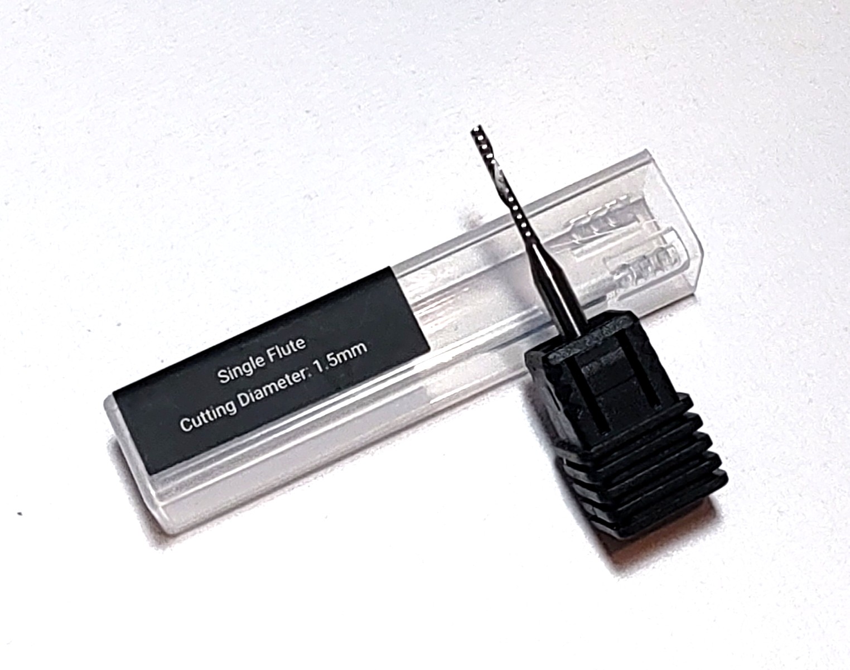
GO Paper/images/mill_bit.jpeg
