PythonOrC/ISEF/GO Paper/images/OpenMV.jpeg

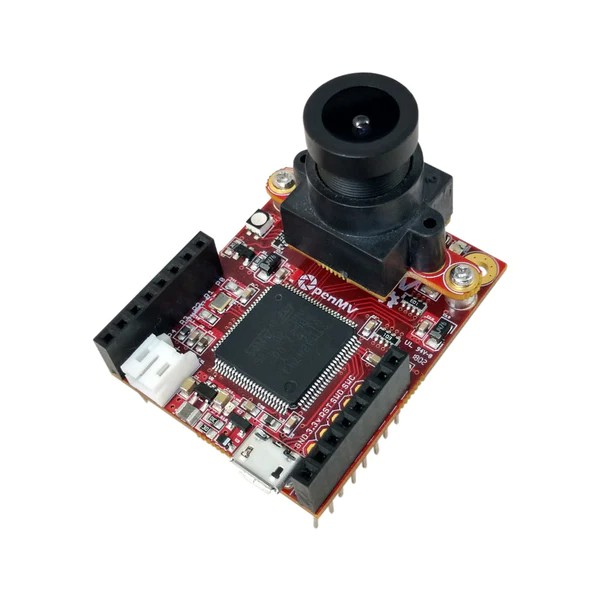
GO Paper/images/OpenMV.jpeg
