PythonOrC/ISEF/GO Paper/images/Oscilloscope.jpeg

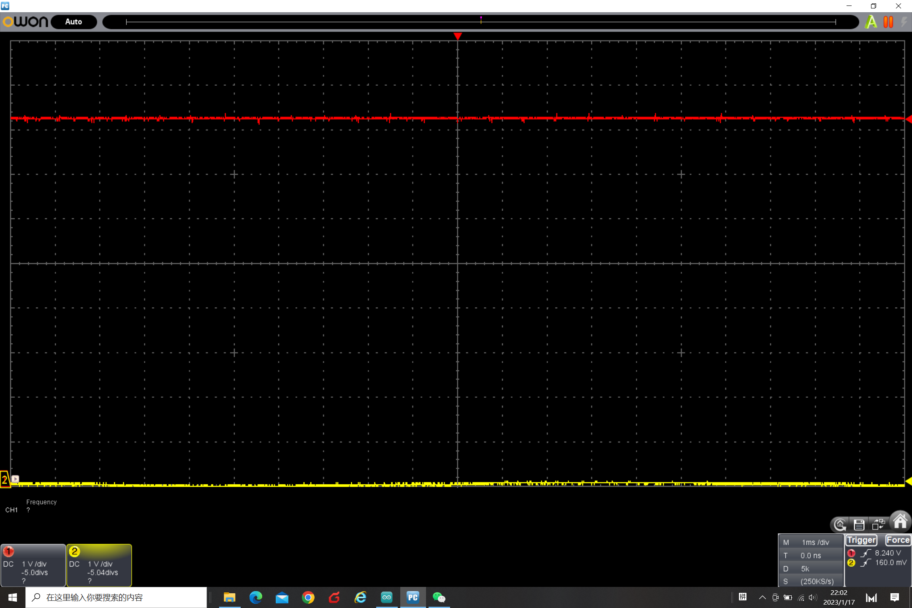
GO Paper/images/Oscilloscope.jpeg
