PythonOrC/ISEF/GO Paper/images/part a.jpeg

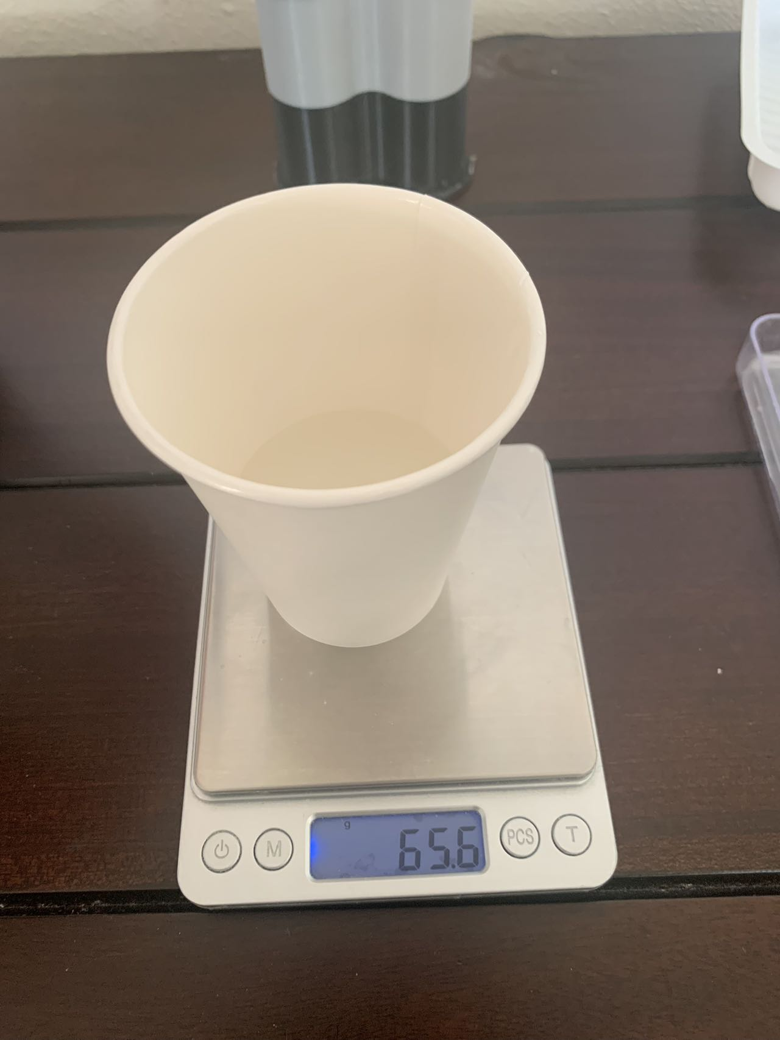
GO Paper/images/part a.jpeg
