PythonOrC/ISEF/GO Paper/images/part b.jpeg

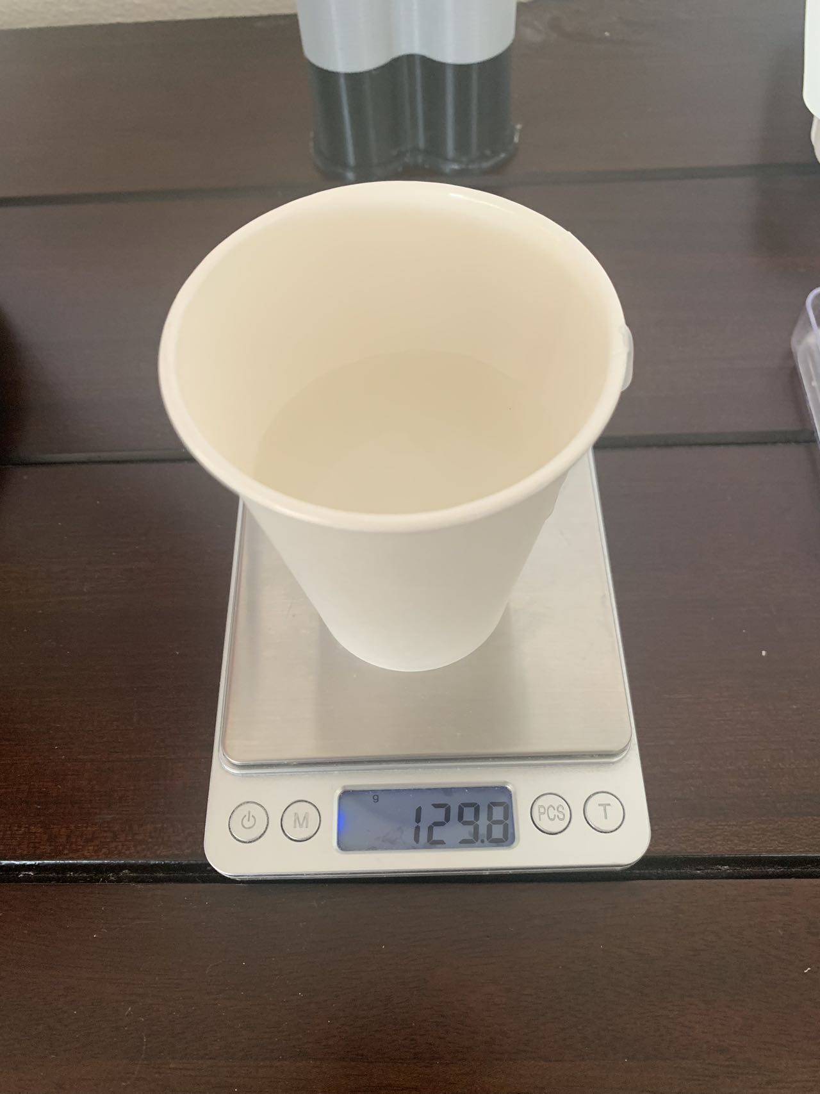
GO Paper/images/part b.jpeg
