PythonOrC/ISEF/GO Paper/images/pla.jpeg

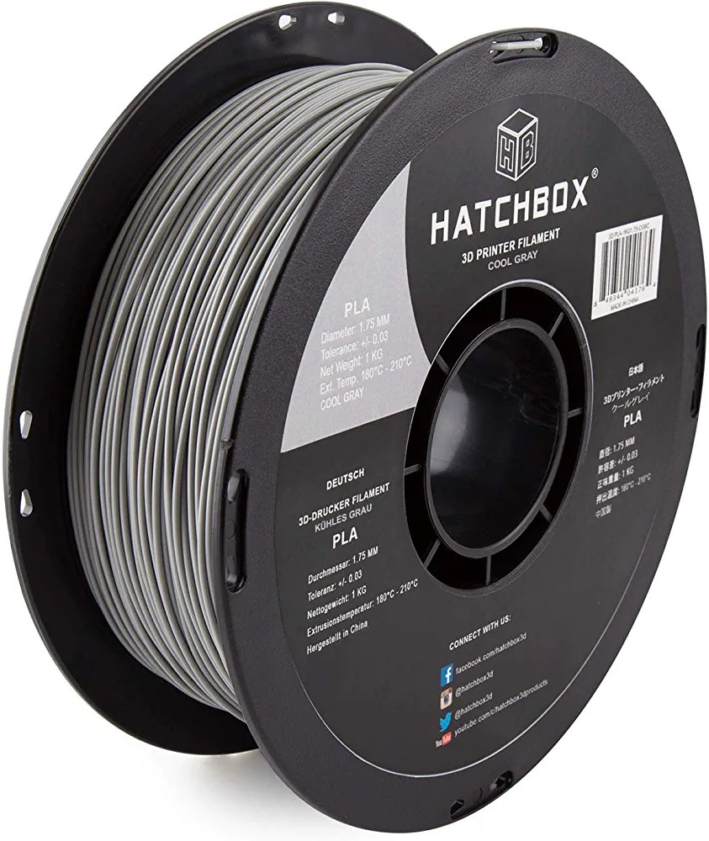
GO Paper/images/pla.jpeg
