PythonOrC/ISEF/GO Paper/images/pour.jpeg

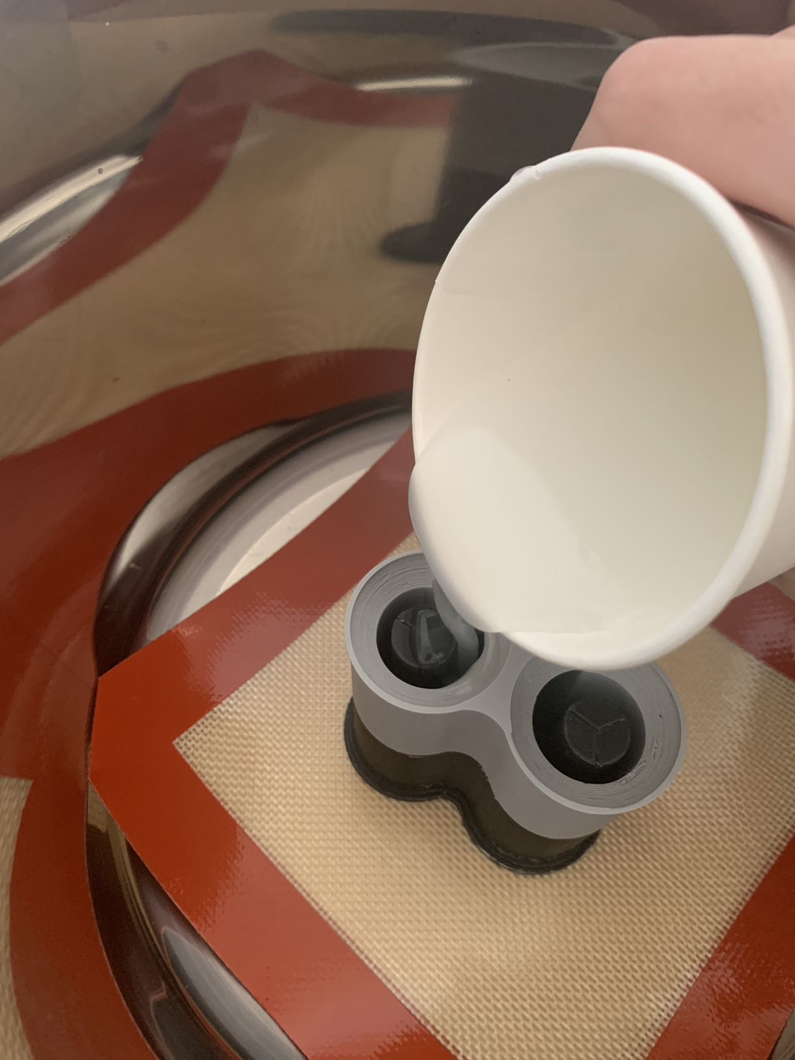
GO Paper/images/pour.jpeg
