PythonOrC/ISEF/GO Paper/images/prep mold.jpeg

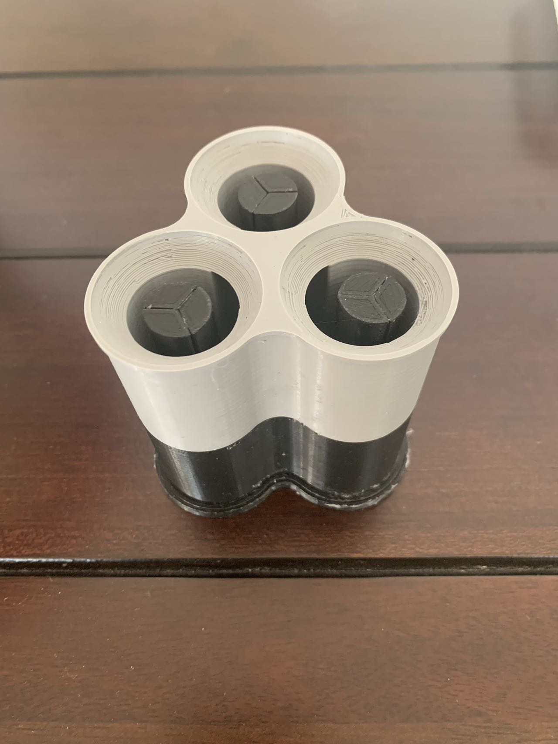
GO Paper/images/prep mold.jpeg
