PythonOrC/ISEF/GO Paper/images/pvc_tubing.jpeg

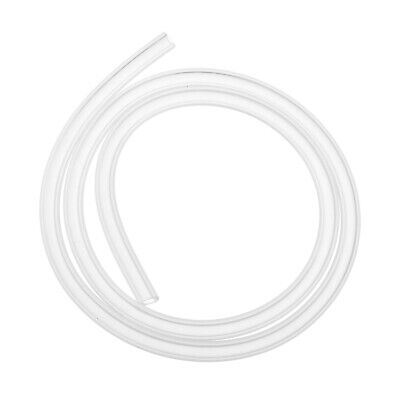
GO Paper/images/pvc_tubing.jpeg
