PythonOrC/ISEF/GO Paper/images/relay.jpeg

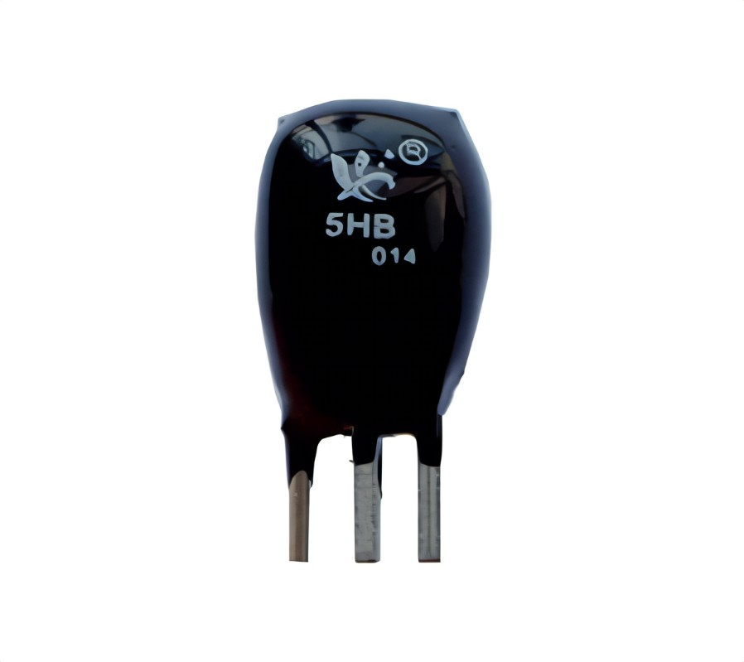
GO Paper/images/relay.jpeg
