PythonOrC/ISEF/GO Paper/images/solenoid valve.jpeg

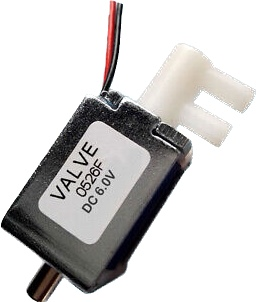
GO Paper/images/solenoid valve.jpeg
