PythonOrC/ISEF/GO Paper/images/spring.jpeg

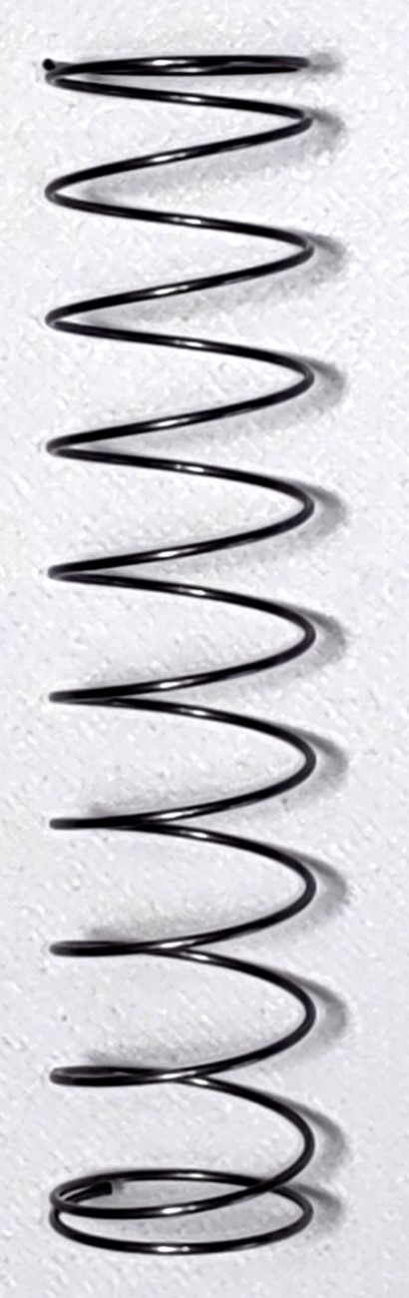
GO Paper/images/spring.jpeg
