PythonOrC/ISEF/GO Paper/images/vacume.jpeg

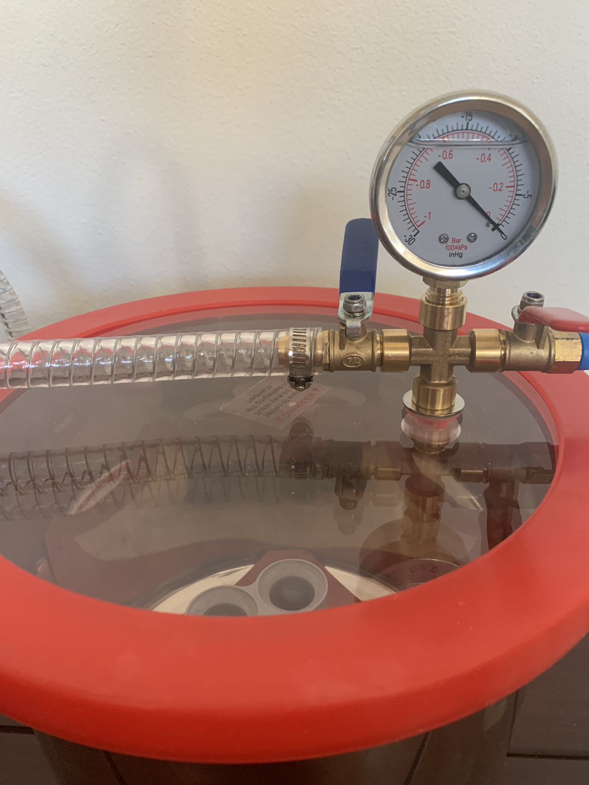
GO Paper/images/vacume.jpeg
