PythonOrC/ISEF/Mechanical/footage/PTZ.jpg

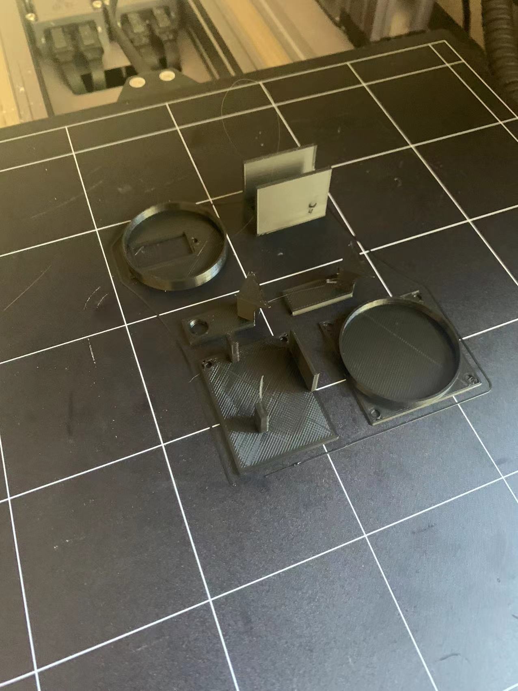
Mechanical/footage/PTZ.jpg
