PythonOrC/ISEF/Mechanical/footage/改良模具v1.jpg

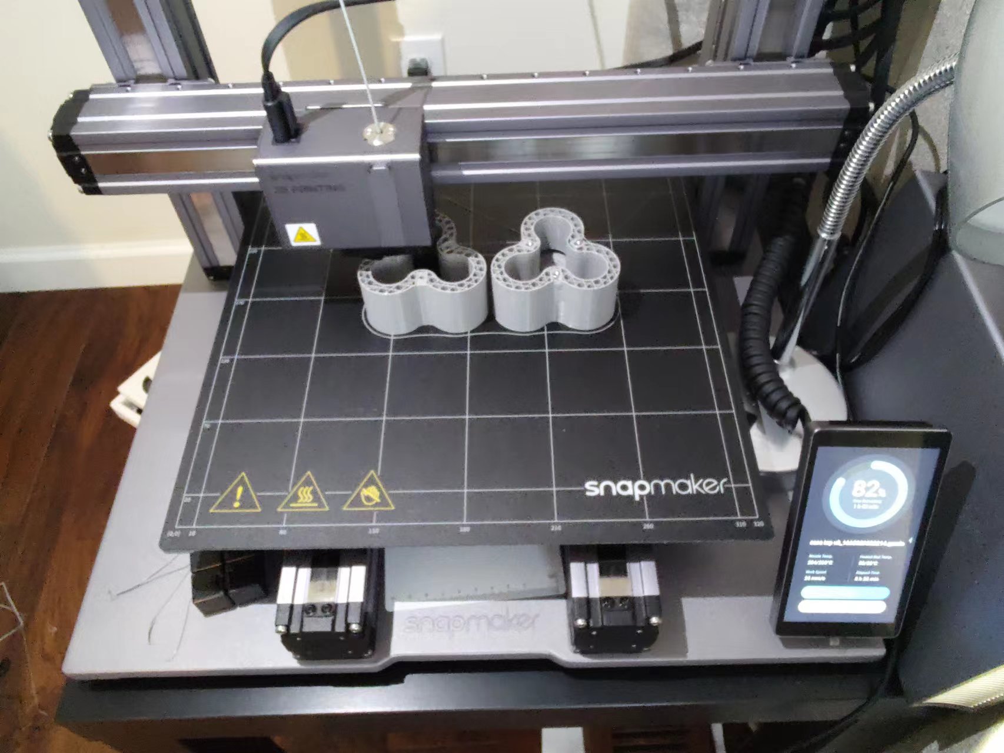
Mechanical/footage/改良模具v1.jpg
