PythonOrC/ISEF/Mechanical/footage/改良模具v2.jpg

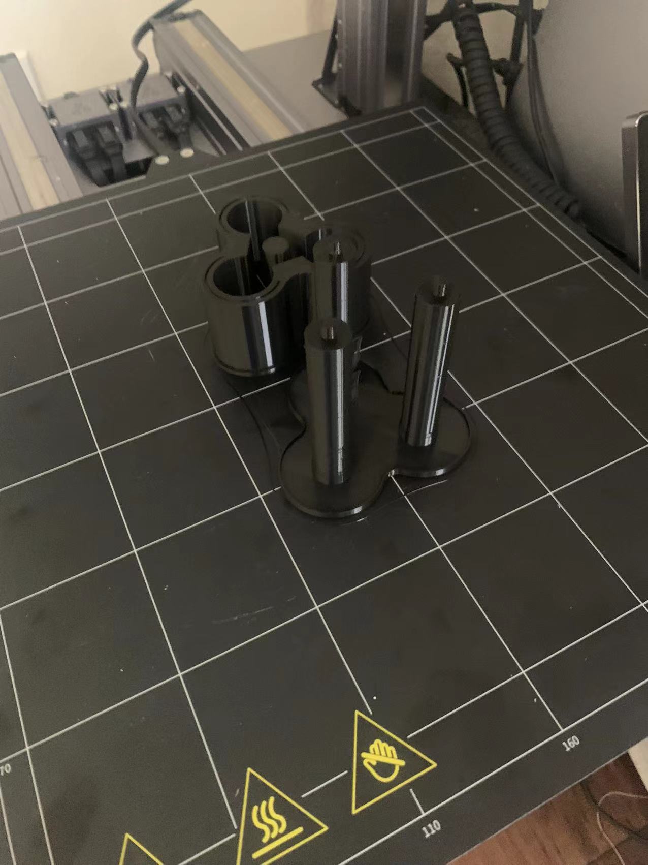
Mechanical/footage/改良模具v2.jpg
