PythonOrC/ISEF/Mechanical/micro-servo-9g-drawing-dimensions.png

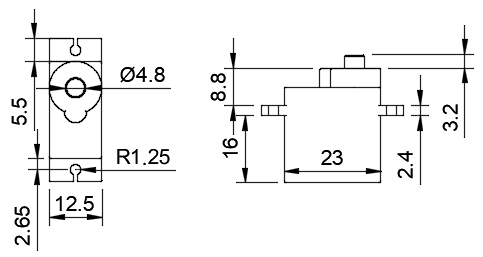
Mechanical/micro-servo-9g-drawing-dimensions.png
