PythonOrC/ISEF/Mechanical/openmv dimension.png

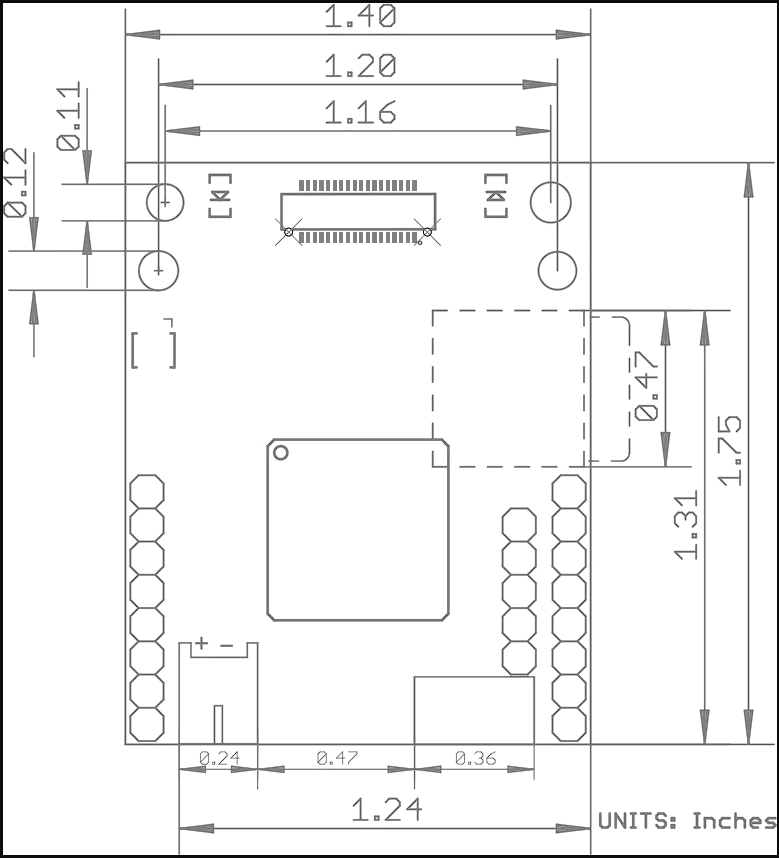
Mechanical/openmv dimension.png
