PythonOrC/ISEF/Mechanical/ruthenium-PhotoEnhancerAI.png

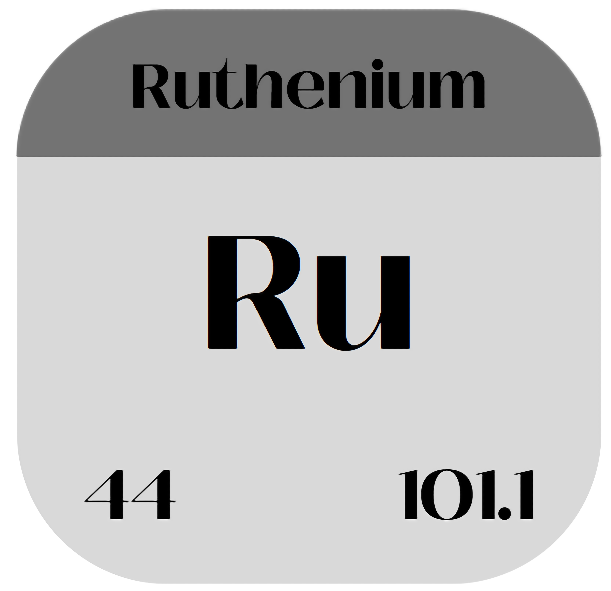
Mechanical/ruthenium-PhotoEnhancerAI.png
