PythonOrC/ISEF/Mechanical/servo 9g.jpg

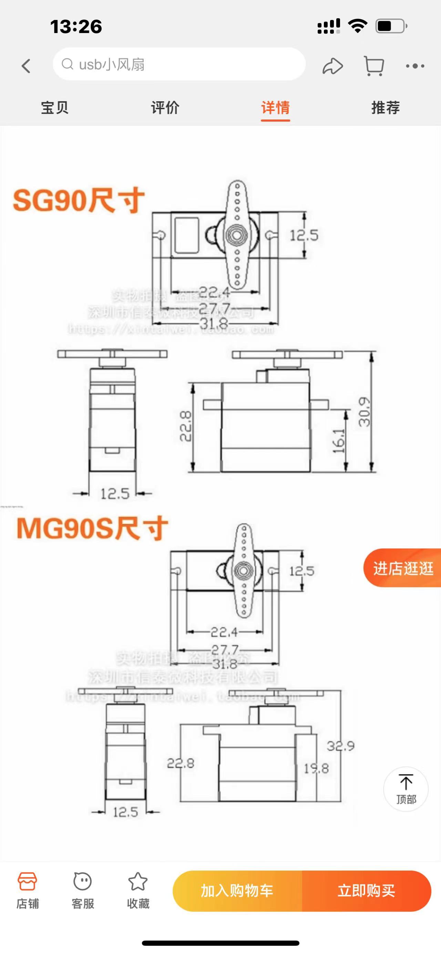
Mechanical/servo 9g.jpg
