PythonOrC/ISEF/Mechanical/simulation/d14w5/images/d14w5 t3.png

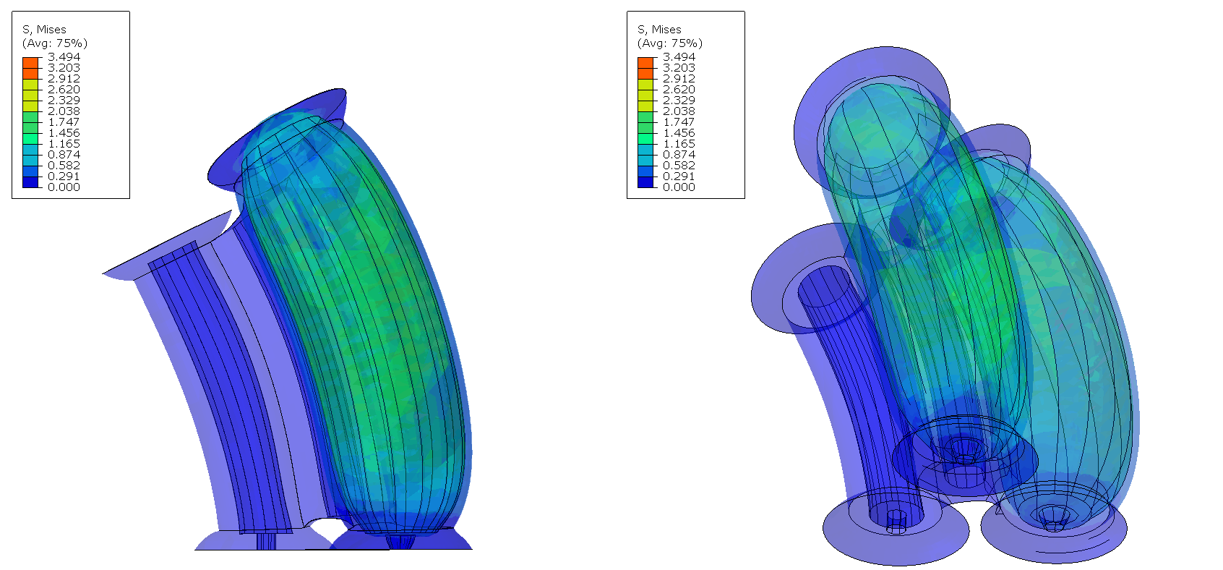
Mechanical/simulation/d14w5/images/d14w5 t3.png
