PythonOrC/ISEF/Mechanical/simulation/d15w4/images/d15w4 t1.png

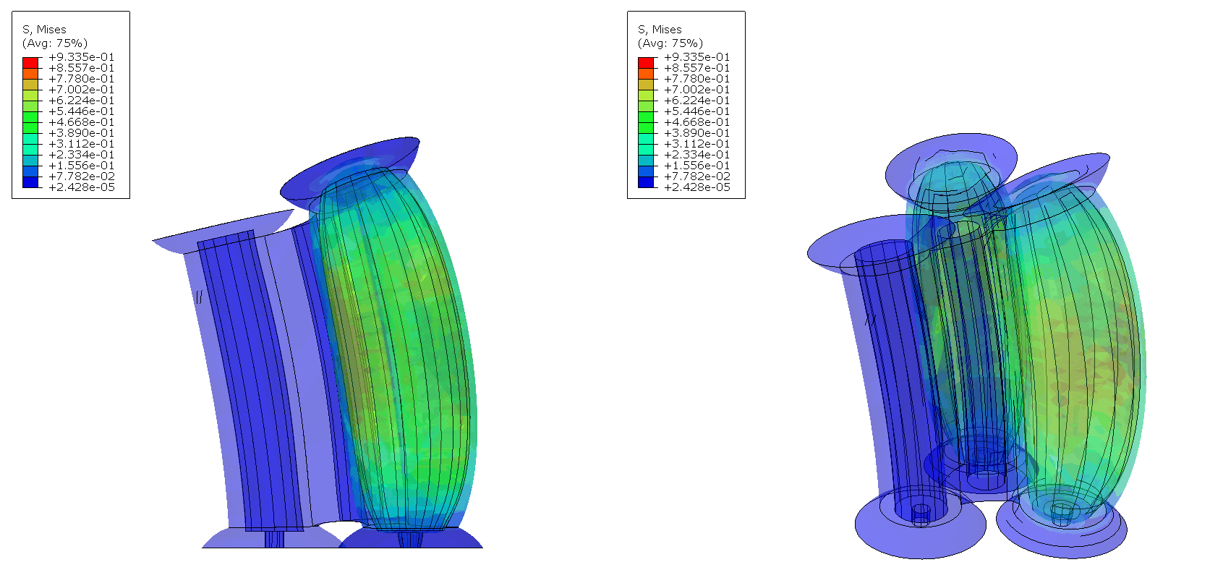
Mechanical/simulation/d15w4/images/d15w4 t1.png
