PythonOrC/ISEF/Mechanical/simulation/d15w5/images/two chamber t2.png

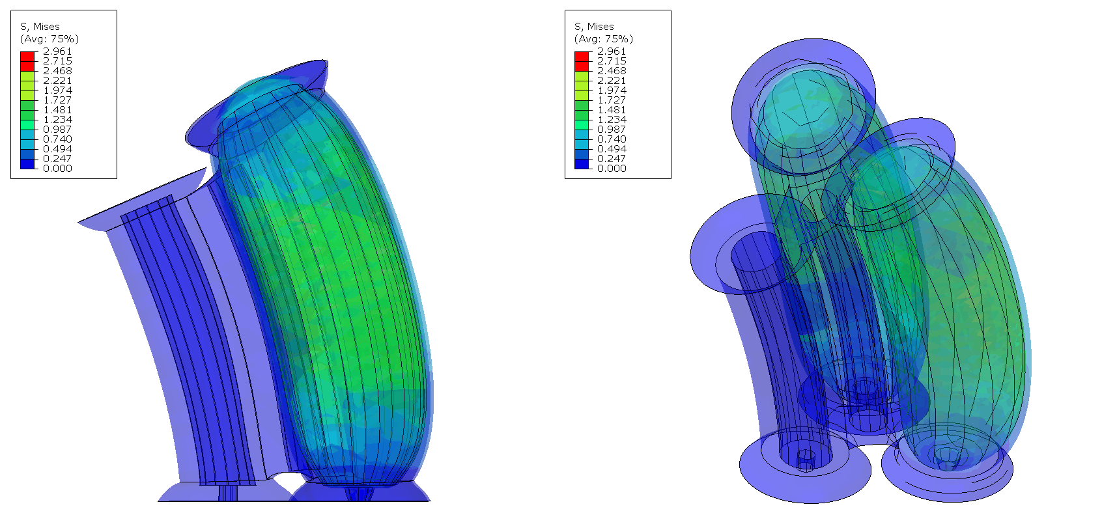
Mechanical/simulation/d15w5/images/two chamber t2.png
