PythonOrC/ISEF/Mechanical/simulation/d15w5/one chamber t1.png

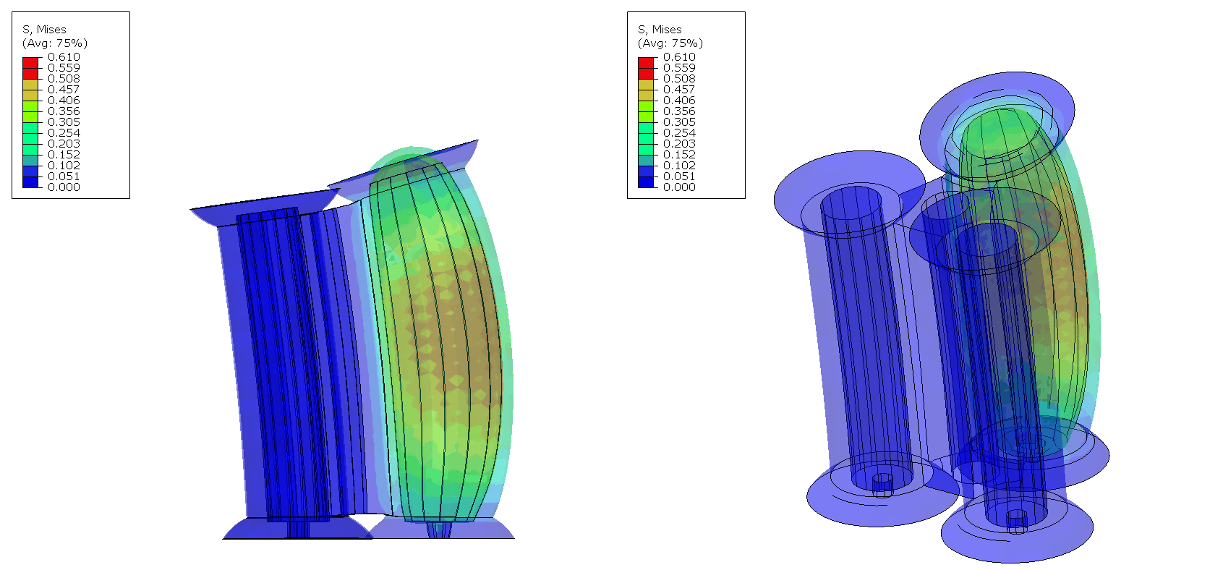
Mechanical/simulation/d15w5/one chamber t1.png
