PythonOrC/ISEF/Mechanical/simulation/d15w5/one chamber t3.png

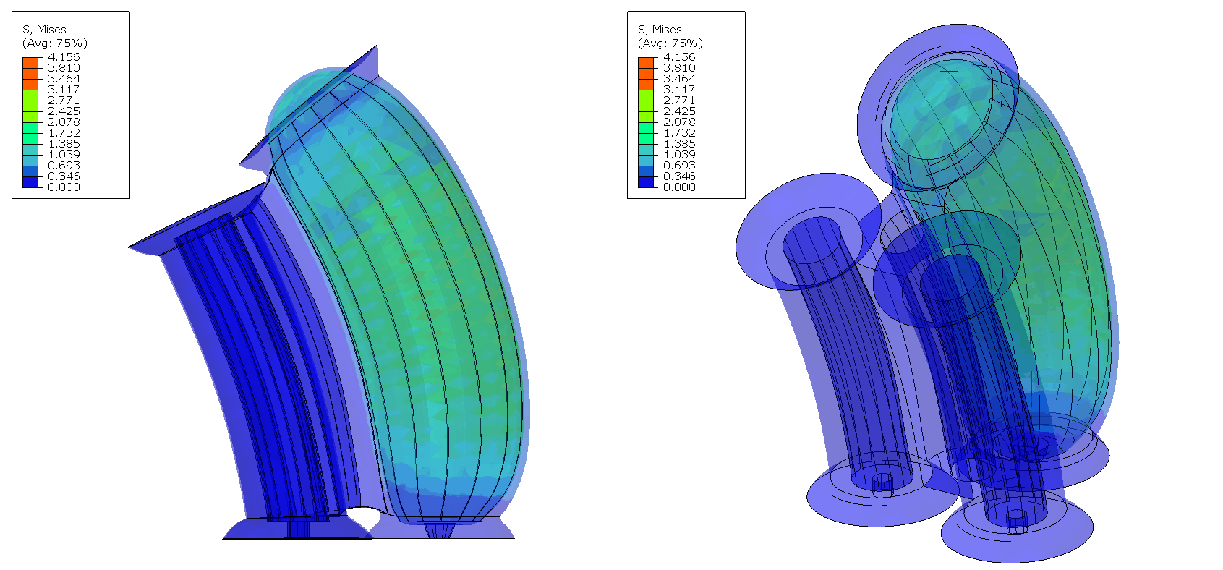
Mechanical/simulation/d15w5/one chamber t3.png
