PythonOrC/ISEF/Mechanical/simulation/d15w5/one chamber t4.png

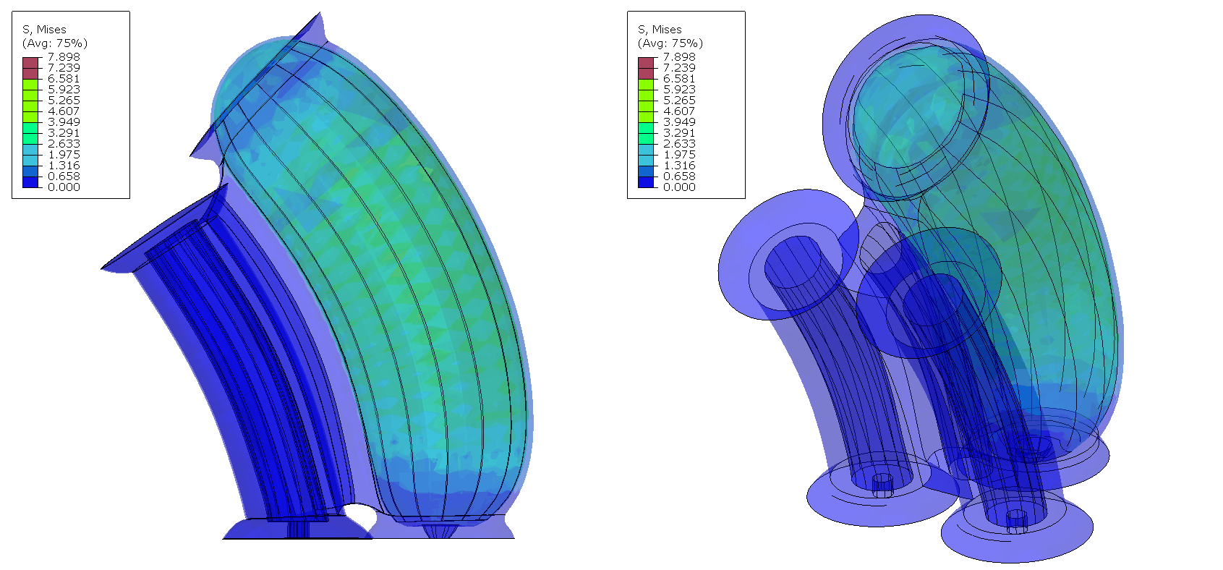
Mechanical/simulation/d15w5/one chamber t4.png
