PythonOrC/ISEF/Mechanical/simulation/d15w6/images/d15w6 t2.png

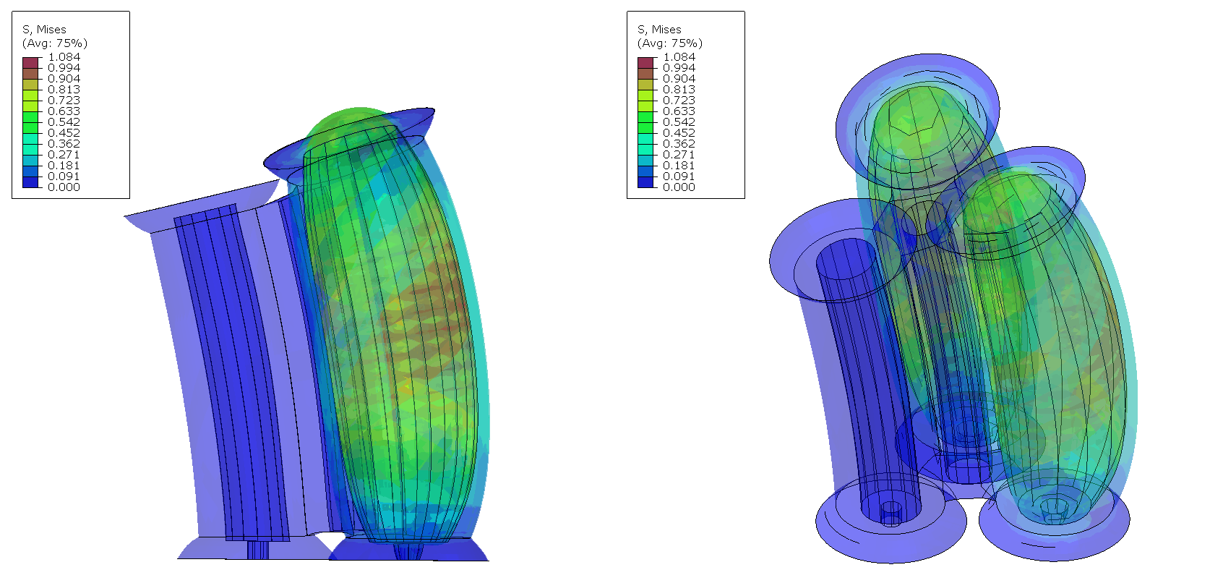
Mechanical/simulation/d15w6/images/d15w6 t2.png
