PythonOrC/ISEF/Mechanical/simulation/d16w5/images/d16w5 t1.png

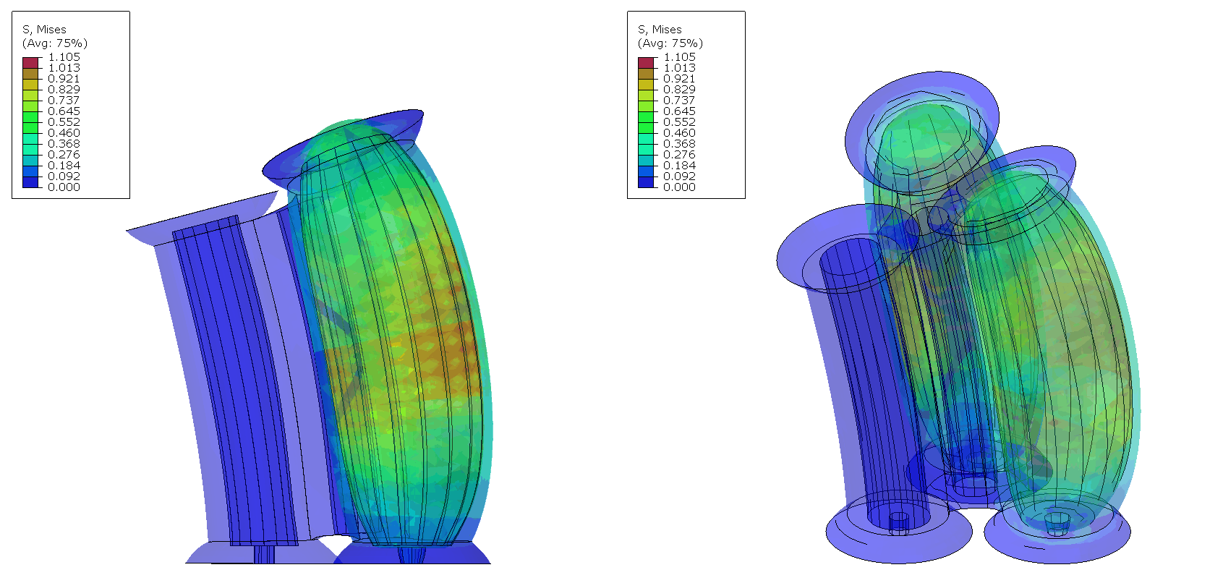
Mechanical/simulation/d16w5/images/d16w5 t1.png
