PythonOrC/ISEF/Mechanical/tube bent desmos.png

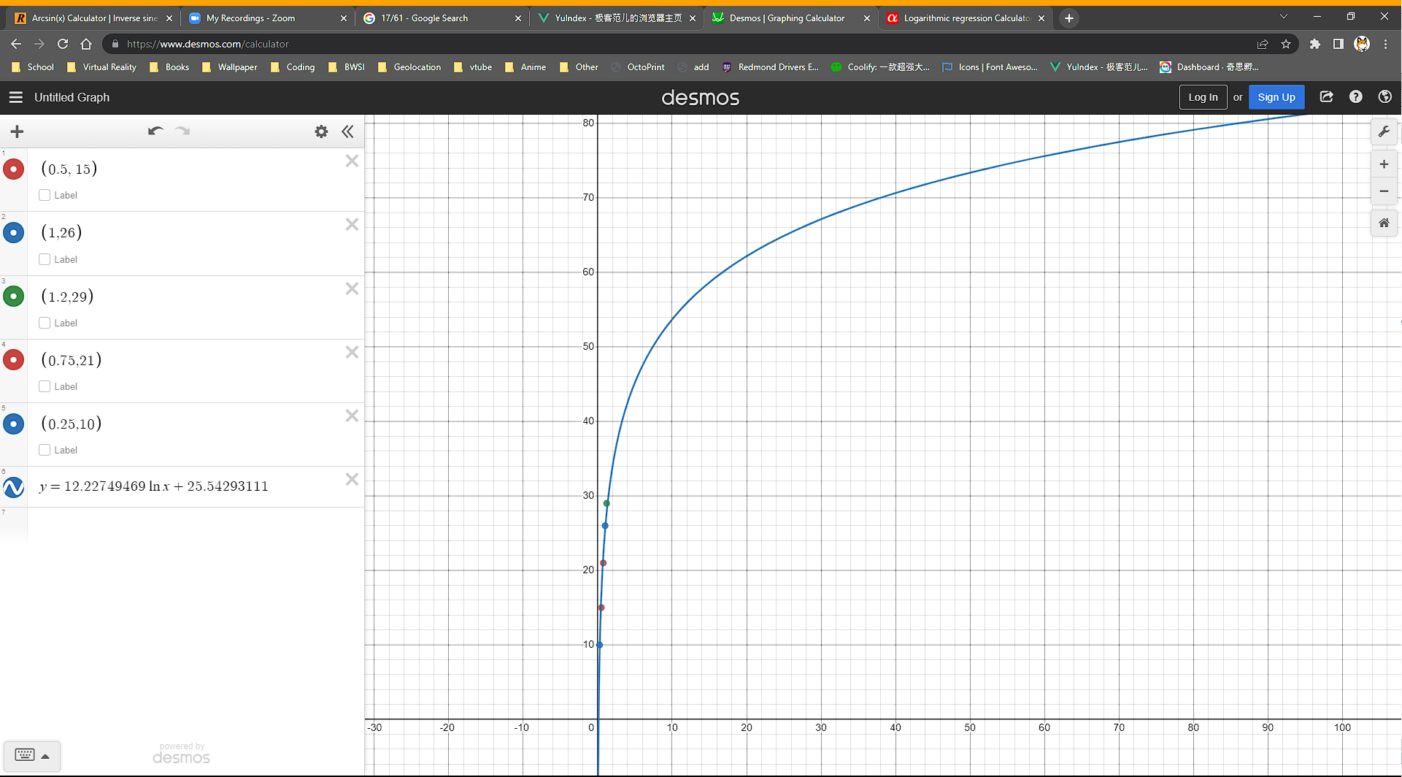
Mechanical/tube bent desmos.png
