PythonOrC/ISEF/Research Paper/images/air_pump.jpg

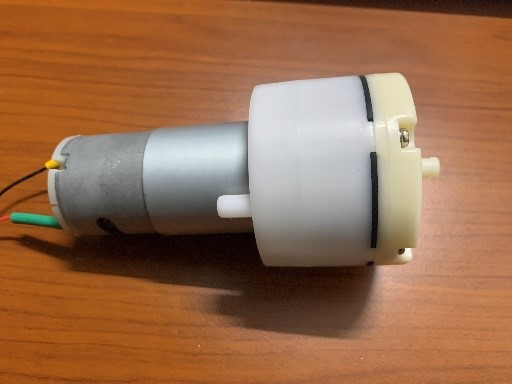
Research Paper/images/air_pump.jpg
