PythonOrC/ISEF/Research Paper/images/mill_bit_closed.jpg

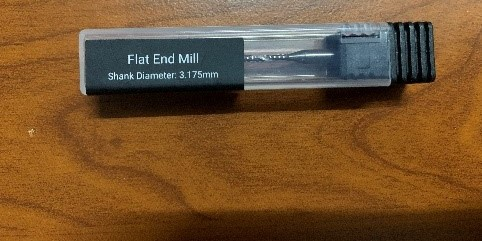
Research Paper/images/mill_bit_closed.jpg
