PythonOrC/ISEF/snake analysis.png

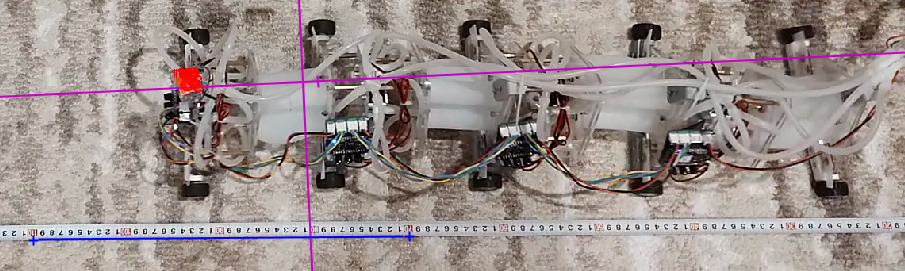
snake analysis.png
