PythonOrC/ISEF/Mechanical/snake parts/inner d15 v18 cut.png

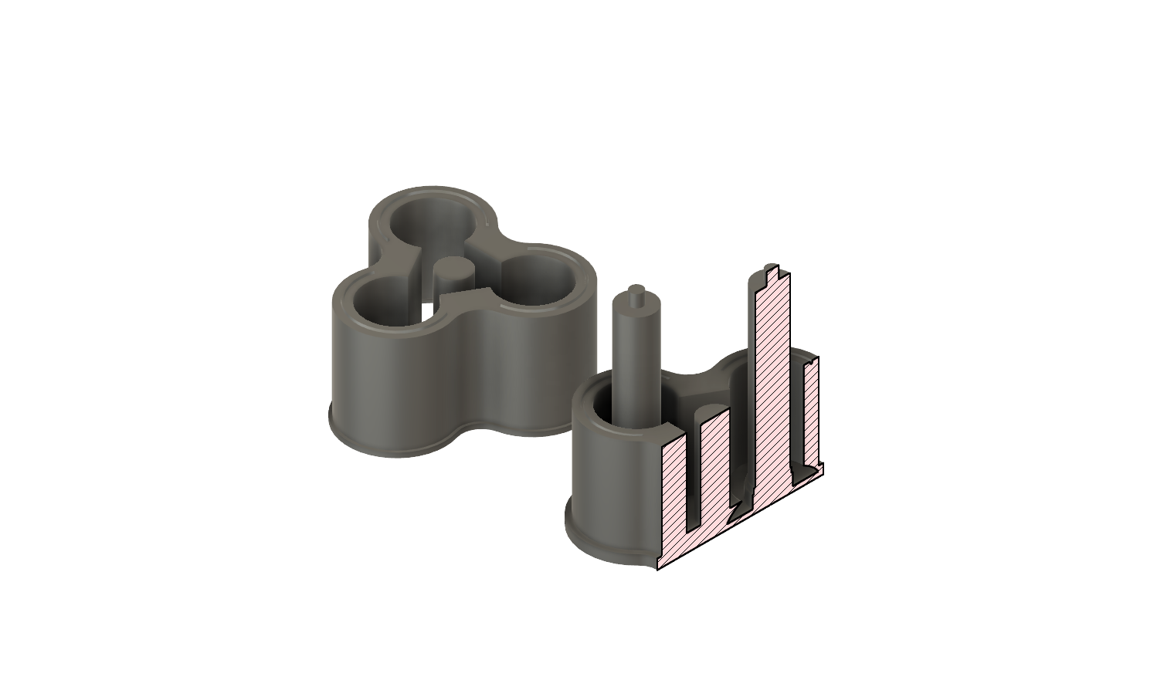
Mechanical/snake parts/inner d15 v18 cut.png
