PythonOrC/ISEF/Mechanical/snake parts/inner d15 v18.png

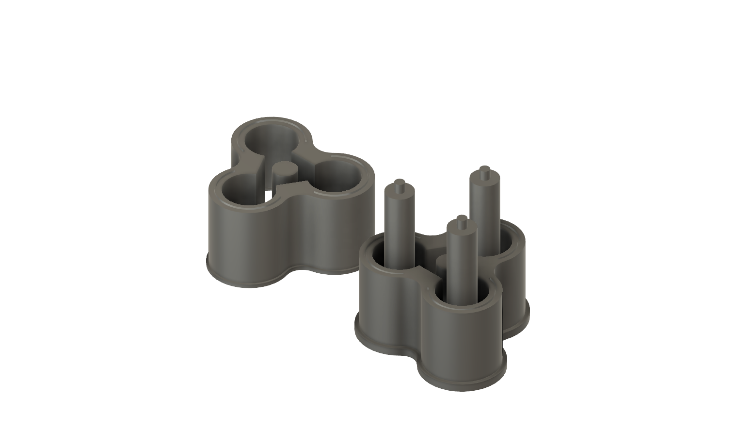
Mechanical/snake parts/inner d15 v18.png
