PythonOrC/ISEF/Mechanical/snake parts/二代气囊/Picture1.jpg

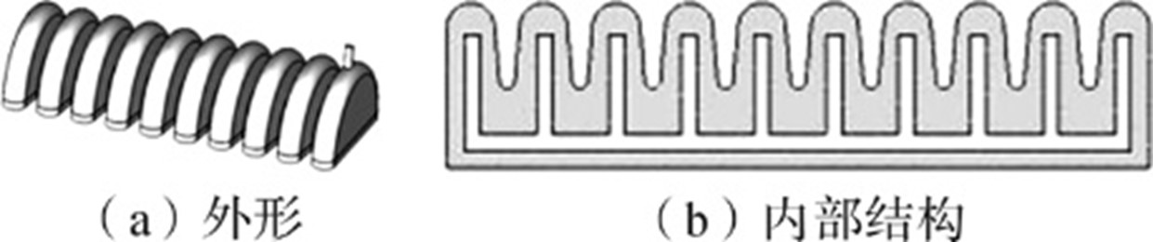
Mechanical/snake parts/二代气囊/Picture1.jpg
