PythonOrC/ISEF/Mechanical/snake parts/二代气囊/Picture2.jpg

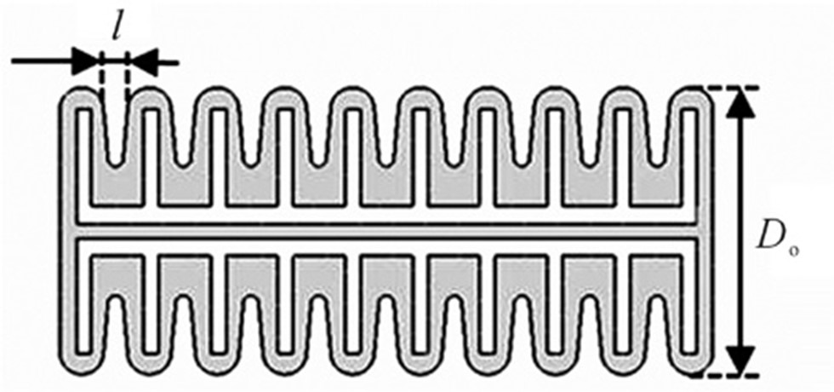
Mechanical/snake parts/二代气囊/Picture2.jpg
