PythonOrC/ISEF/Mechanical/snake parts/二代气囊/Picture3.jpg

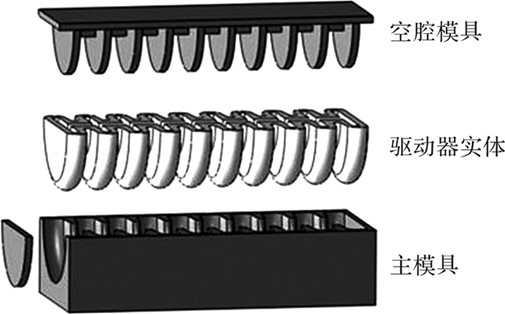
Mechanical/snake parts/二代气囊/Picture3.jpg
