PythonOrC/ISEF/Mechanical/snake parts/二代气囊/Picture4.jpg

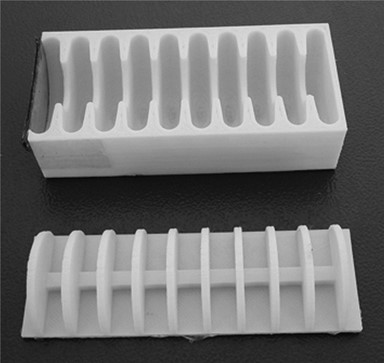
Mechanical/snake parts/二代气囊/Picture4.jpg
