PythonOrC/ISEF/Mechanical/snake parts/二代气囊/Picture5.jpg

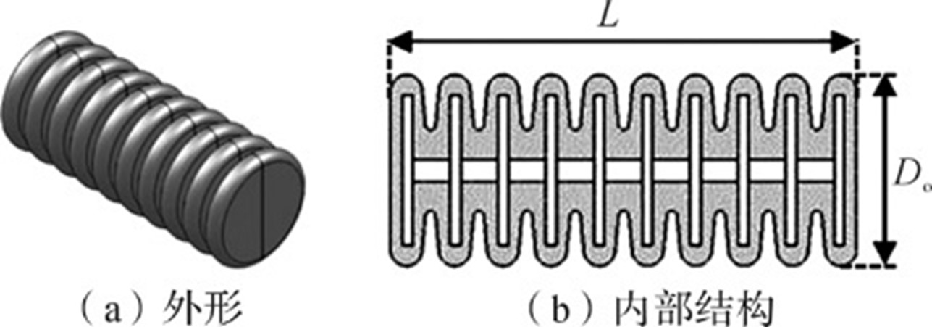
Mechanical/snake parts/二代气囊/Picture5.jpg
