PythonOrC/ISEF/Mechanical/snake parts/entire snake.SLDASM

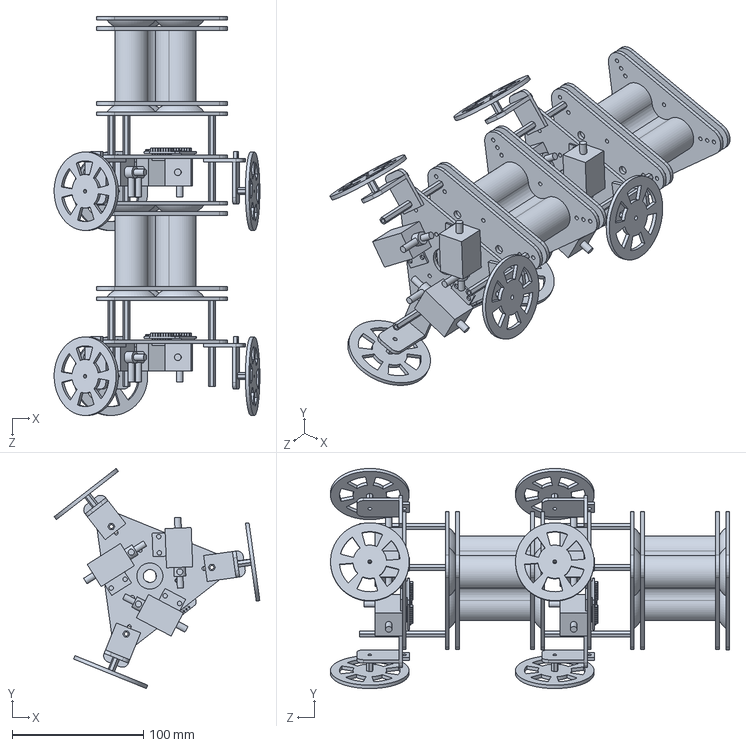
[picture p168: CAD file, 2022-12-01]
Mechanical/snake parts/entire snake.SLDASM
157.0 x 168.0 x 304.6 mm
snake segment x 2
