PythonOrC/ISEF/Mechanical/snake parts/Assem.SLDASM

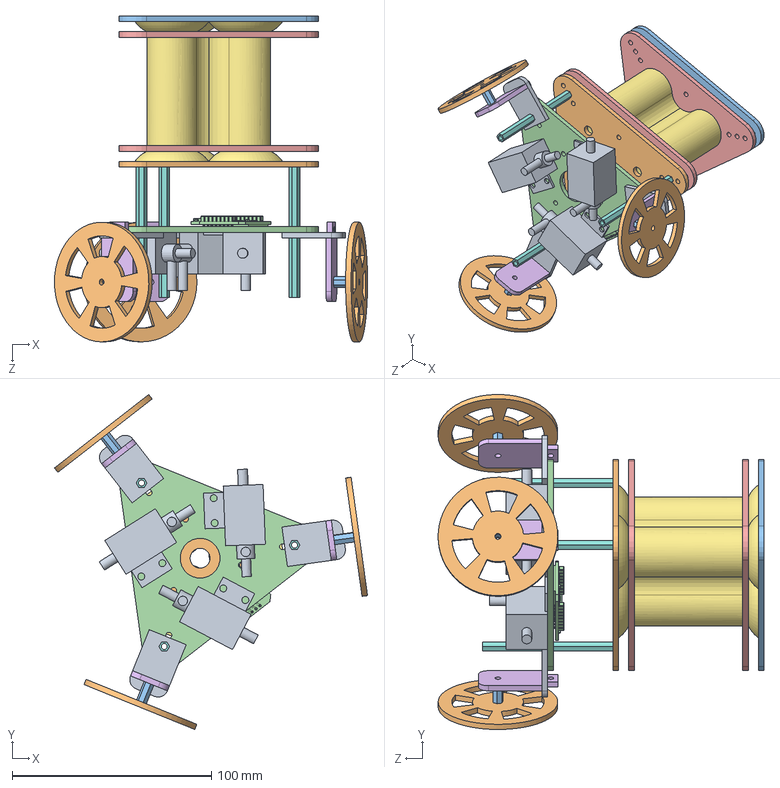
[picture p169: CAD file, 2022-12-01]
Mechanical/snake parts/Assem.SLDASM
157.0 x 168.0 x 163.4 mm
air x 3
plate 1
plate 2
plate 3
plate 4 x 2
wheel part 1 x 3
Part1 v1.step
standoff x 6
wheel part v2 x 3
wheel_v2 x 3
1cm standoff x 3
d1mini_edited
