PythonOrC/ISEF/Mechanical/snake parts/Assem1.SLDASM

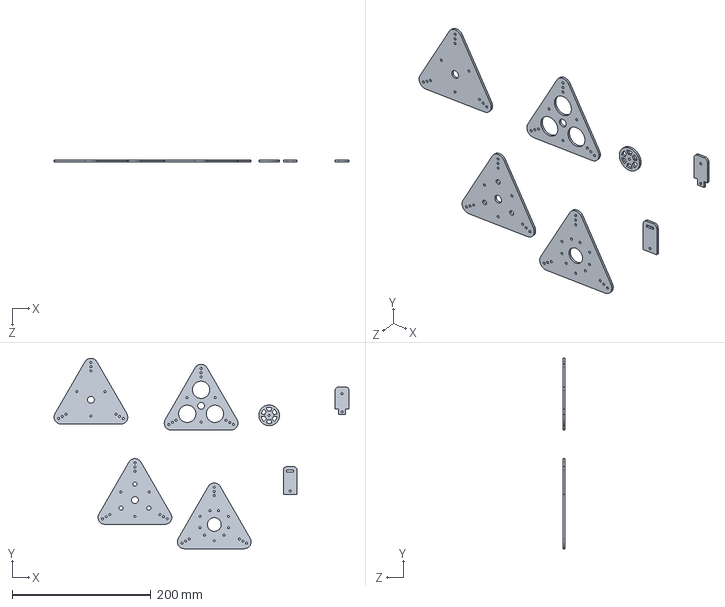
[picture p170: CAD file, 2022-12-01]
Mechanical/snake parts/Assem1.SLDASM
425.9 x 275.0 x 2.80 mm
