PythonOrC/ISEF/Mechanical/inner d17 v9.stl

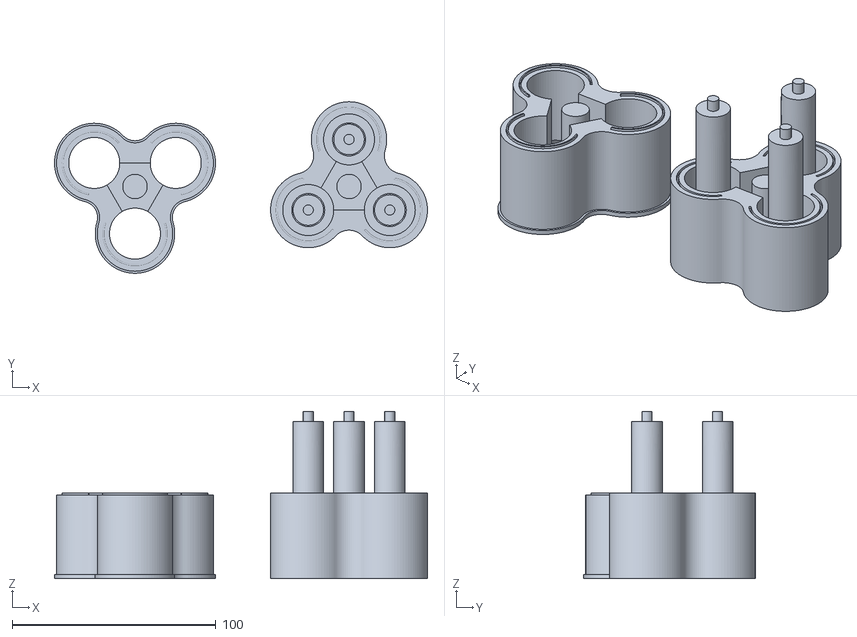
[picture p171: CAD file, 2022-12-01]
Mechanical/inner d17 v9.stl
183.0 x 84.2 x 82.0
