PythonOrC/ISEF/Mechanical/snake parts/inner d15 v28.stl

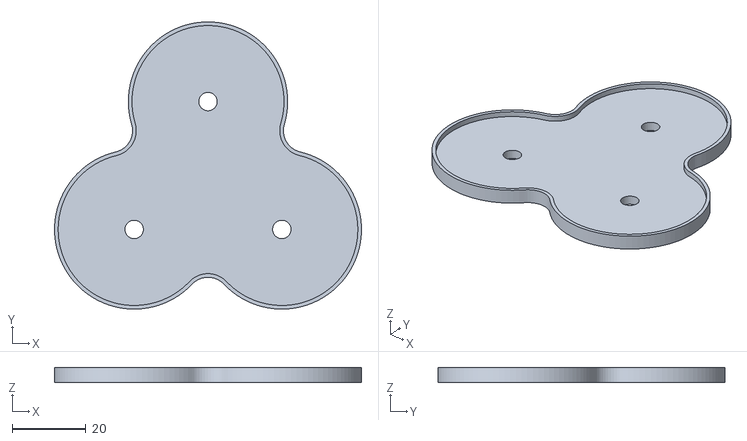
[picture p172: CAD file, 2023-06-27]
Mechanical/snake parts/inner d15 v28.stl
83.1 x 77.8 x 4.00
