PythonOrC/ISEF/Mechanical/snake parts/wemos-d1-mini-with-pin-header-1.snapshot.1/d1mini_edited.SLDPRT

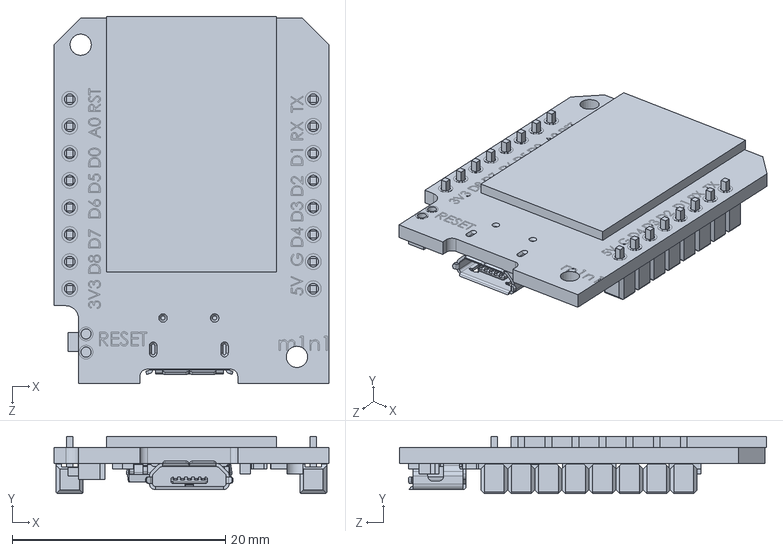
[picture p173: CAD file, 2022-12-01]
Mechanical/snake parts/wemos-d1-mini-with-pin-header-1.snapshot.1/d1mini_edited.SLDPRT
25.8 x 5.37 x 34.4 mm
