PythonOrC/ISEF/Mechanical/snake parts/二代气囊/二代模具 v2.step

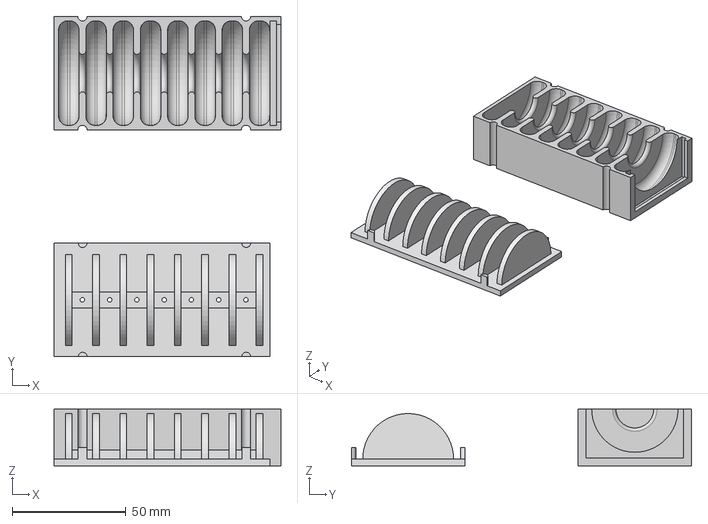
[picture p174: CAD file, 2022-12-01]
Mechanical/snake parts/二代气囊/二代模具 v2.step
99.9 x 149.8 x 25.0 mm
mold box
lid
