PythonOrC/ISEF/Mechanical/d14 bottom.stl

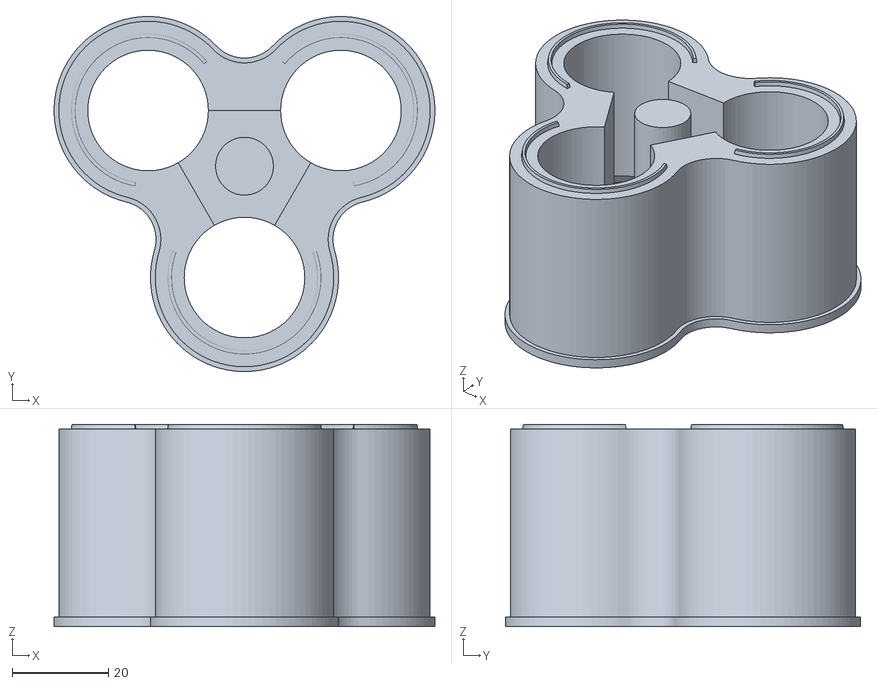
[picture p175: CAD file, 2022-12-01]
Mechanical/d14 bottom.stl
79.0 x 73.6 x 41.9
