PythonOrC/ISEF/Mechanical/snake parts/二代气囊/二代模具 v4.stl

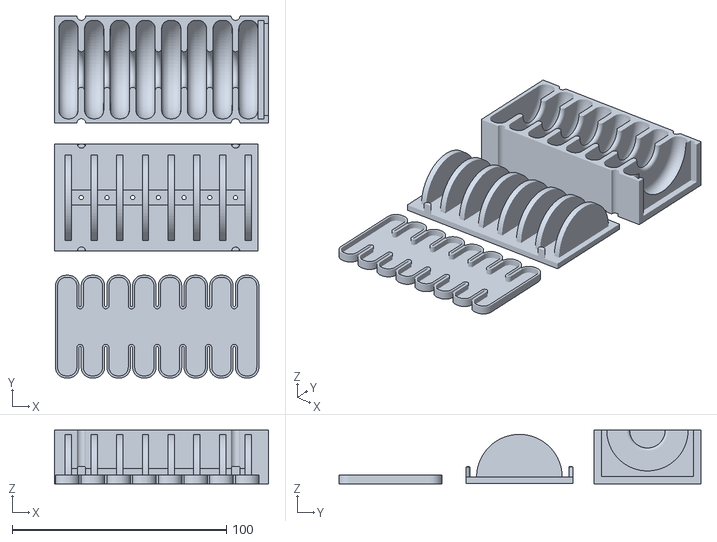
[picture p176: CAD file, 2022-12-01]
Mechanical/snake parts/二代气囊/二代模具 v4.stl
99.9 x 169.0 x 25.0
