PythonOrC/ISEF/Mechanical/pan servo v5.stl

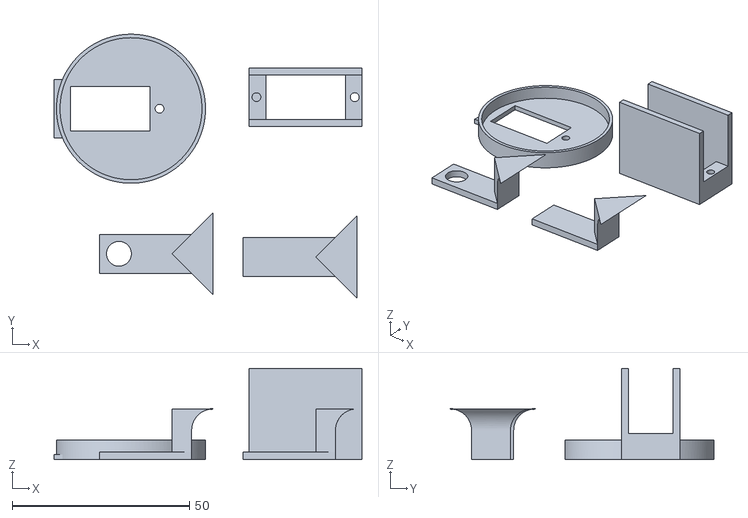
[picture p177: CAD file, 2022-12-01]
Mechanical/pan servo v5.stl
86.8 x 74.3 x 25.7
