PythonOrC/ISEF/Mechanical/改进蛇骨第二层4.0(1).SLDPRT

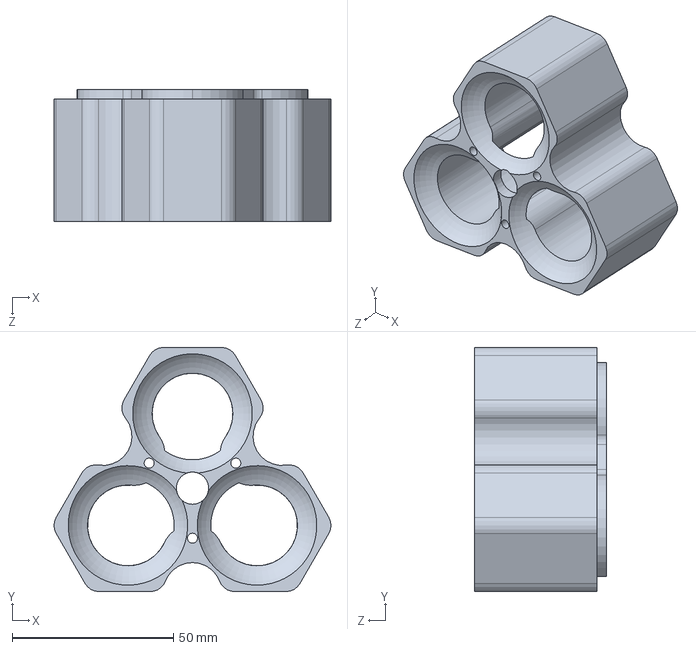
[picture p178: CAD file, 2022-12-01]
Mechanical/改进蛇骨第二层4.0(1).SLDPRT
85.8 x 75.6 x 41.0 mm
