PythonOrC/ISEF/Mechanical/snake parts/d1mini.SLDPRT

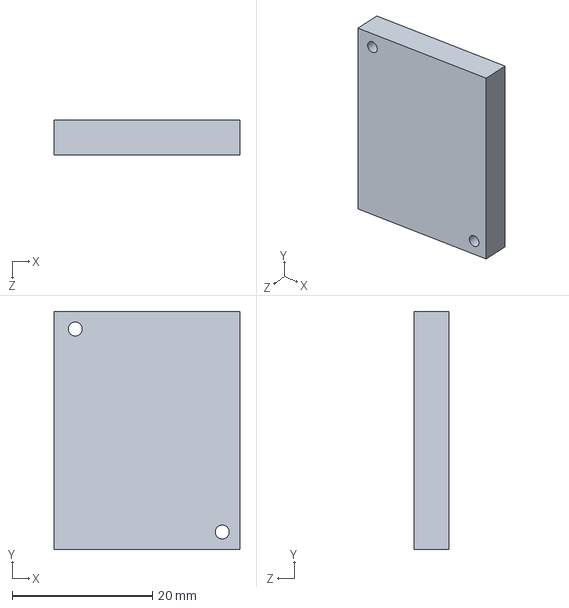
[picture p179: CAD file, 2022-12-01]
Mechanical/snake parts/d1mini.SLDPRT
26.5 x 34.0 x 5.00 mm
