PythonOrC/ISEF/Mechanical/tilt v3.stl

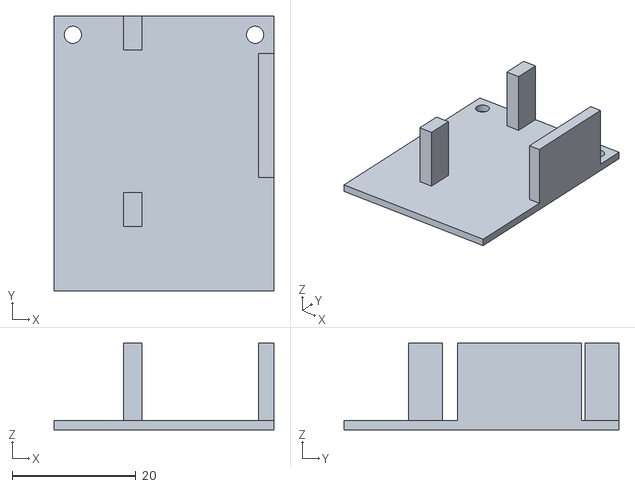
[picture p180: CAD file, 2022-12-01]
Mechanical/tilt v3.stl
35.6 x 44.5 x 14.0
