PythonOrC/ISEF/Mechanical/snake parts/stick v2.stl

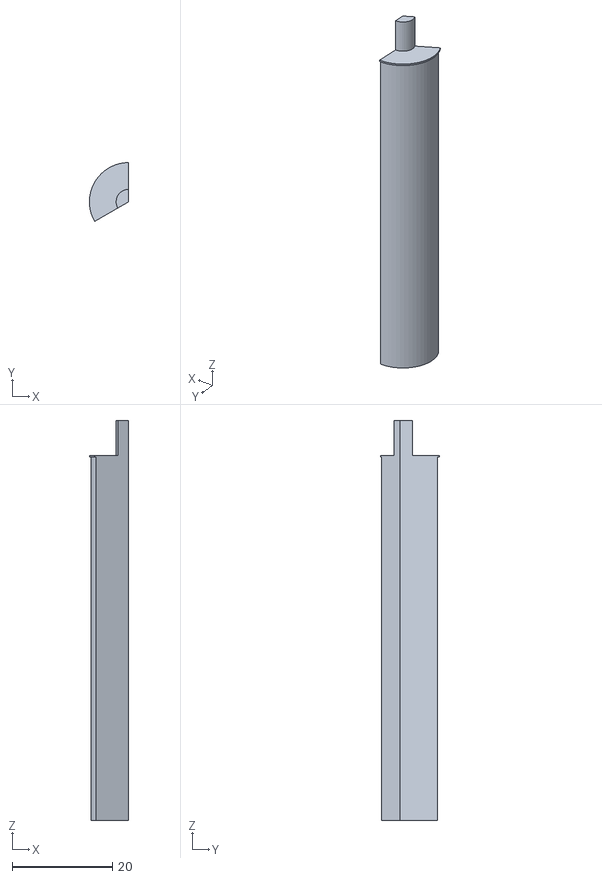
[picture p181: CAD file, 2022-12-01]
Mechanical/snake parts/stick v2.stl
7.85 x 11.8 x 80.0
