PythonOrC/ISEF/Mechanical/snake parts/wheel part 2.SLDPRT

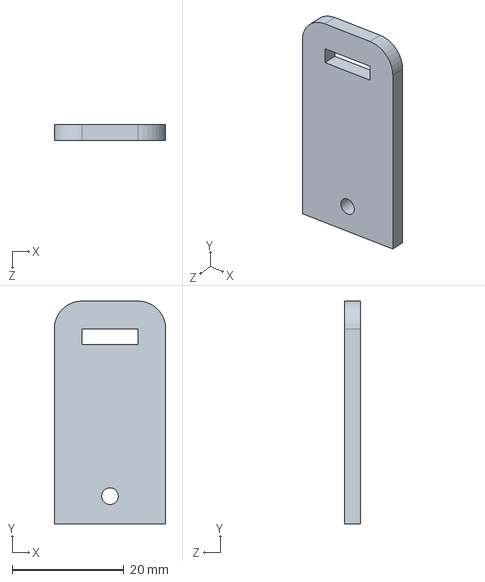
[picture p182: CAD file, 2022-12-01]
Mechanical/snake parts/wheel part 2.SLDPRT
20.0 x 40.0 x 2.80 mm
