PythonOrC/ISEF/Mechanical/case bottom v7.stl

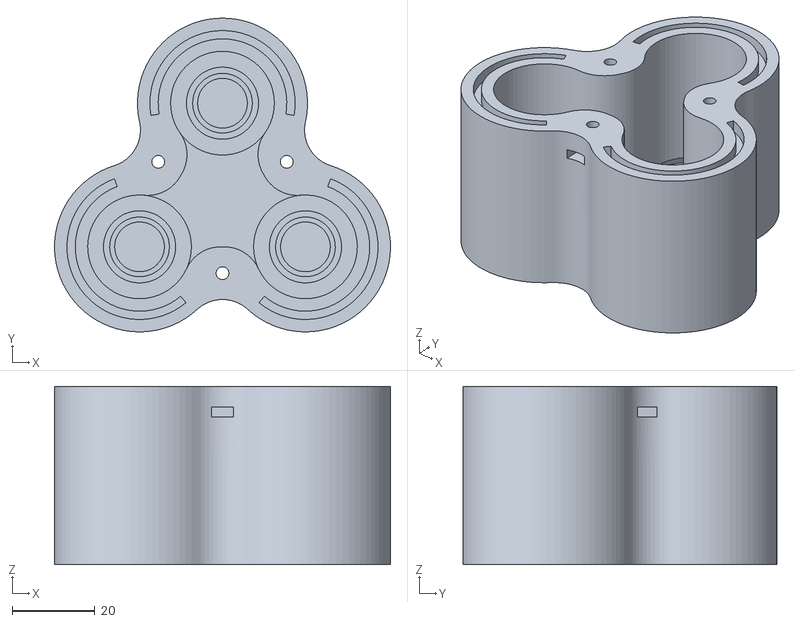
[picture p183: CAD file, 2022-12-01]
Mechanical/case bottom v7.stl
81.0 x 75.6 x 43.0
