PythonOrC/ISEF/Mechanical/snake parts/tire half v3.stl

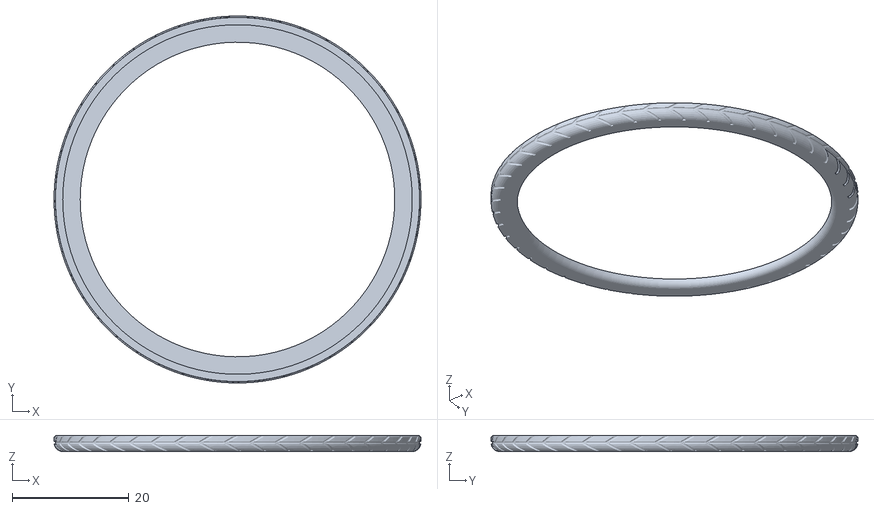
[picture p184: CAD file, 2022-12-01]
Mechanical/snake parts/tire half v3.stl
63.0 x 63.0 x 2.75
