PythonOrC/ISEF/Mechanical/bottom slice v2.stl

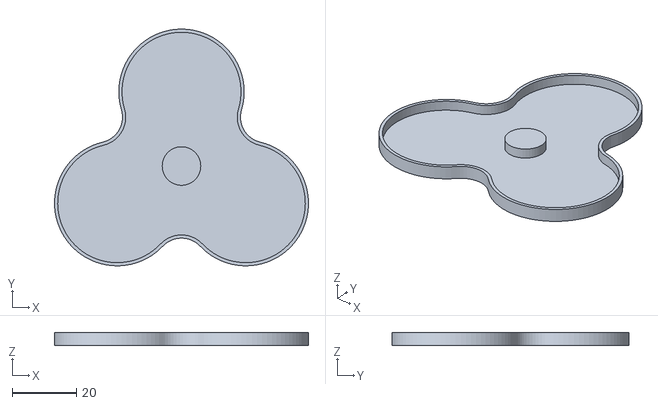
[picture p185: CAD file, 2022-12-01]
Mechanical/bottom slice v2.stl
79.0 x 73.6 x 4.00
