PythonOrC/ISEF/Mechanical/snake parts/wheel_v2.SLDPRT

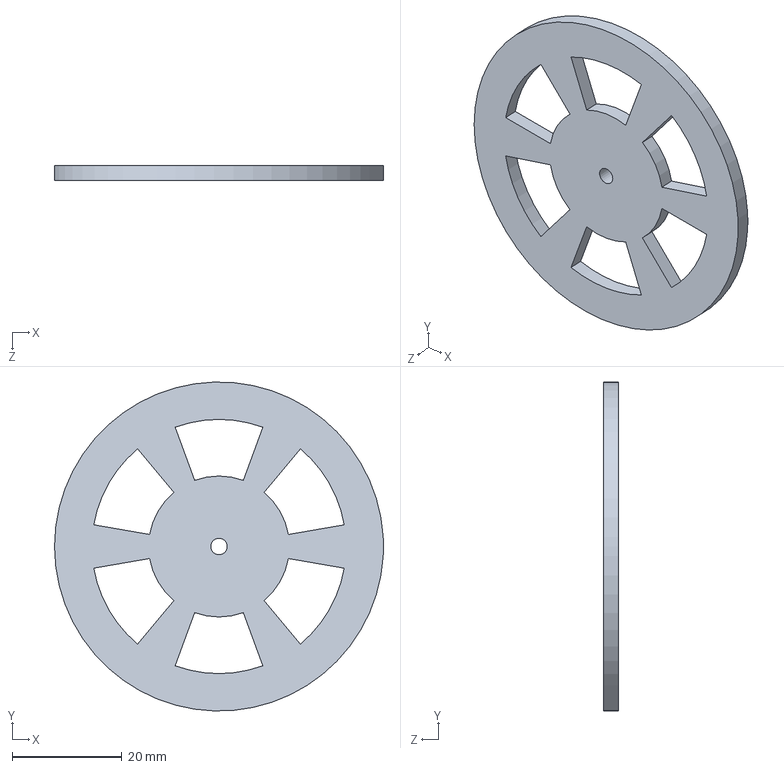
[picture p186: CAD file, 2022-12-01]
Mechanical/snake parts/wheel_v2.SLDPRT
60.0 x 60.0 x 2.80 mm
