PythonOrC/ISEF/Mechanical/snake parts/1cm standoff.SLDPRT

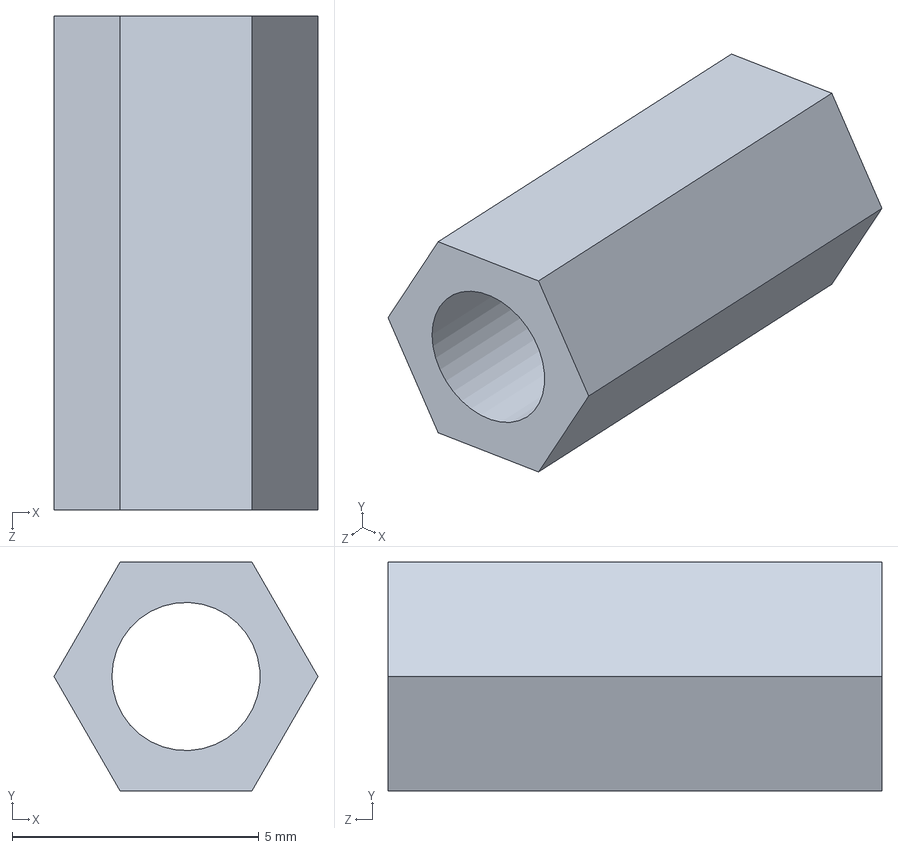
[picture p187: CAD file, 2022-12-01]
Mechanical/snake parts/1cm standoff.SLDPRT
5.35 x 4.63 x 10.0 mm
