PythonOrC/ISEF/Mechanical/case top v3.stl

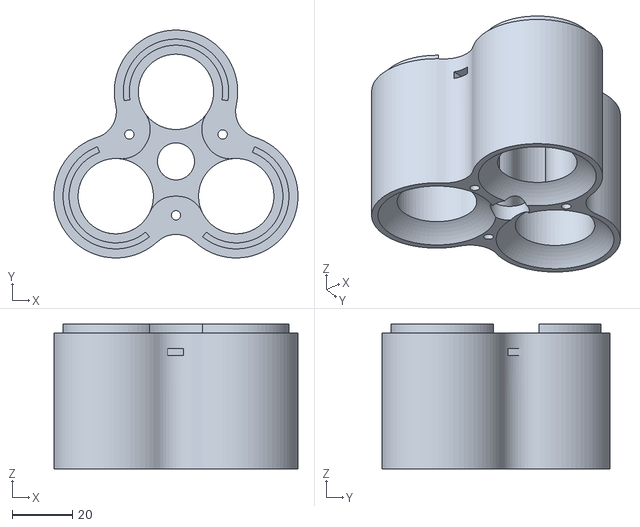
[picture p188: CAD file, 2022-12-01]
Mechanical/case top v3.stl
81.0 x 75.6 x 48.0
