PythonOrC/ISEF/Mechanical/base v2.stl

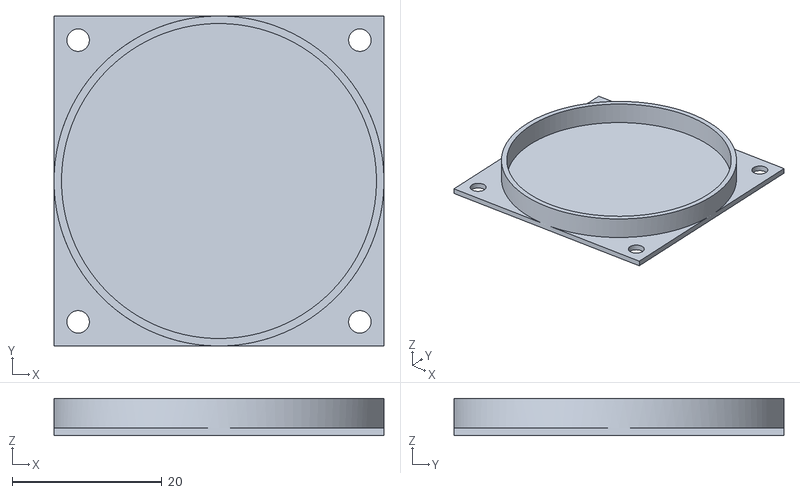
[picture p190: CAD file, 2022-12-01]
Mechanical/base v2.stl
44.0 x 44.0 x 5.00
