PythonOrC/ISEF/Mechanical/snake parts/standoff v2.stl

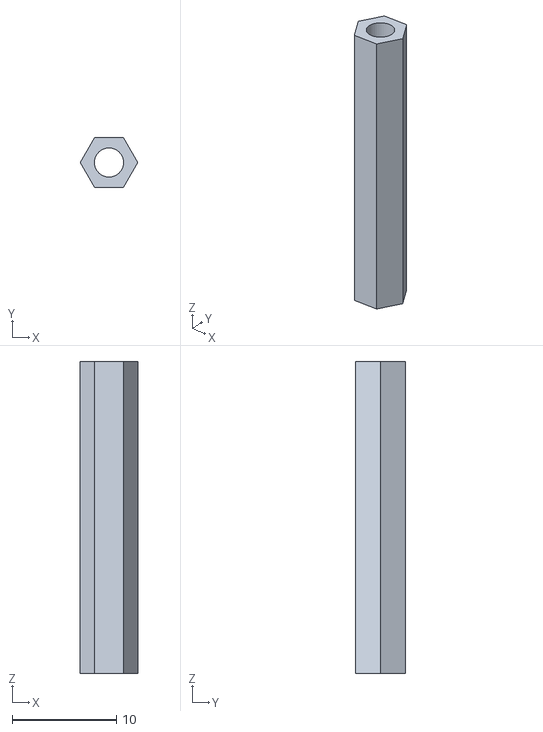
[picture p191: CAD file, 2022-12-01]
Mechanical/snake parts/standoff v2.stl
5.54 x 4.80 x 30.0
