PythonOrC/ISEF/Mechanical/snake parts/Part1.SLDPRT

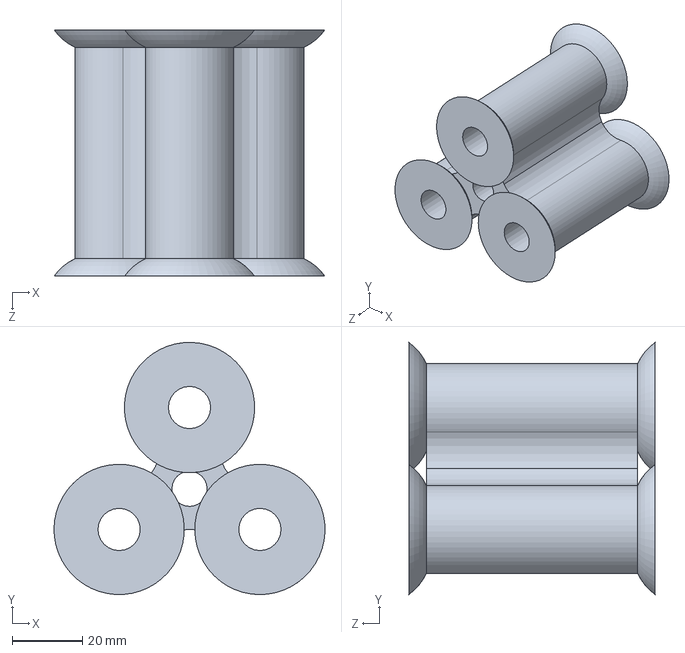
[picture p192: CAD file, 2022-12-01]
Mechanical/snake parts/Part1.SLDPRT
77.0 x 71.6 x 70.0 mm
