PythonOrC/ISEF/Mechanical/snake parts/plates_hole.dxf

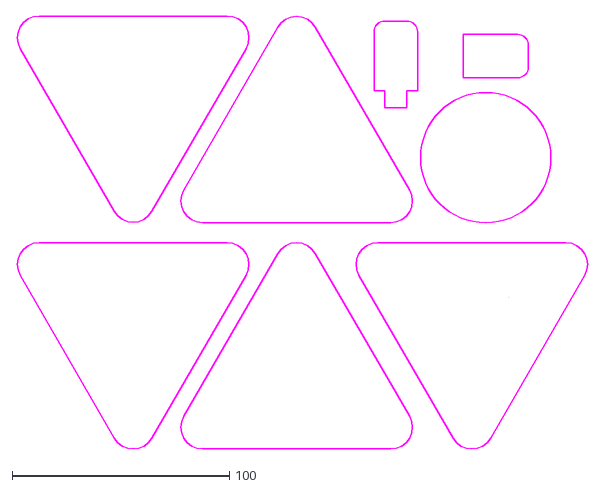
[picture p194: CAD file, 2022-12-01]
Mechanical/snake parts/plates_hole.dxf
263.4 x 199.4
