PythonOrC/ISEF/Mechanical/pan servo circle partv6.stl

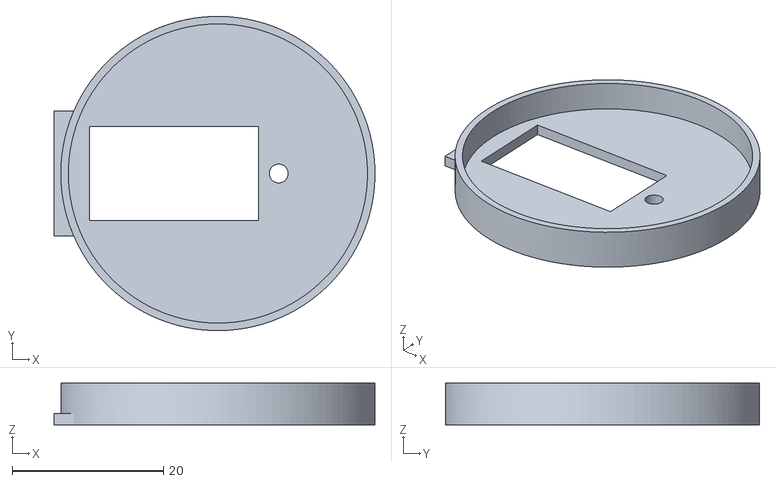
[picture p195: CAD file, 2022-12-01]
Mechanical/pan servo circle partv6.stl
42.5 x 41.6 x 5.50
