PythonOrC/ISEF/Mechanical/inner d14 v12.stl

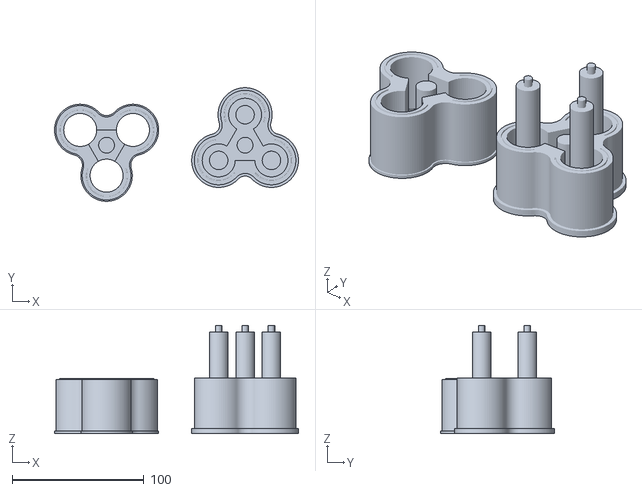
[picture p196: CAD file, 2022-12-01]
Mechanical/inner d14 v12.stl
185.0 x 86.2 x 82.0
