PythonOrC/ISEF/Mechanical/snake parts/air.SLDPRT

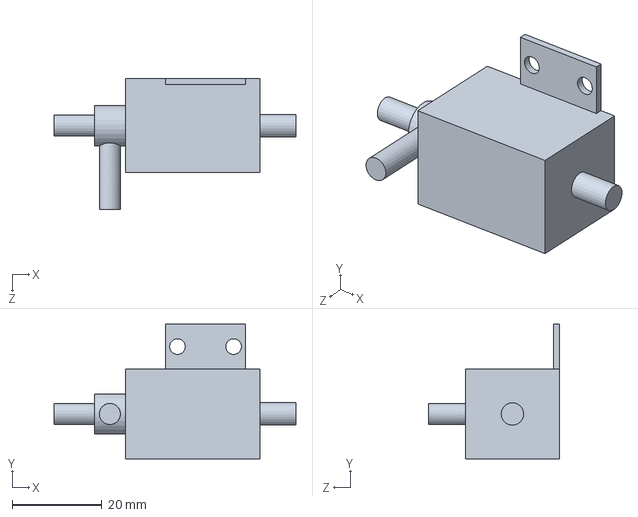
[picture p197: CAD file, 2022-12-01]
Mechanical/snake parts/air.SLDPRT
53.9 x 30.0 x 29.2 mm
