PythonOrC/ISEF/Mechanical/snake parts/wheel part v2.SLDPRT

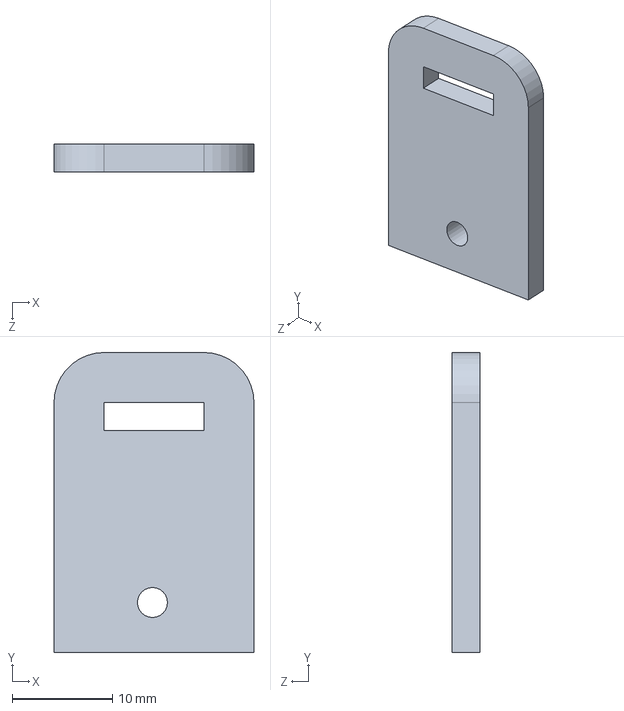
[picture p198: CAD file, 2022-12-01]
Mechanical/snake parts/wheel part v2.SLDPRT
20.0 x 30.0 x 2.80 mm
