PythonOrC/ISEF/Mechanical/snake parts/d1miniv3.SLDPRT

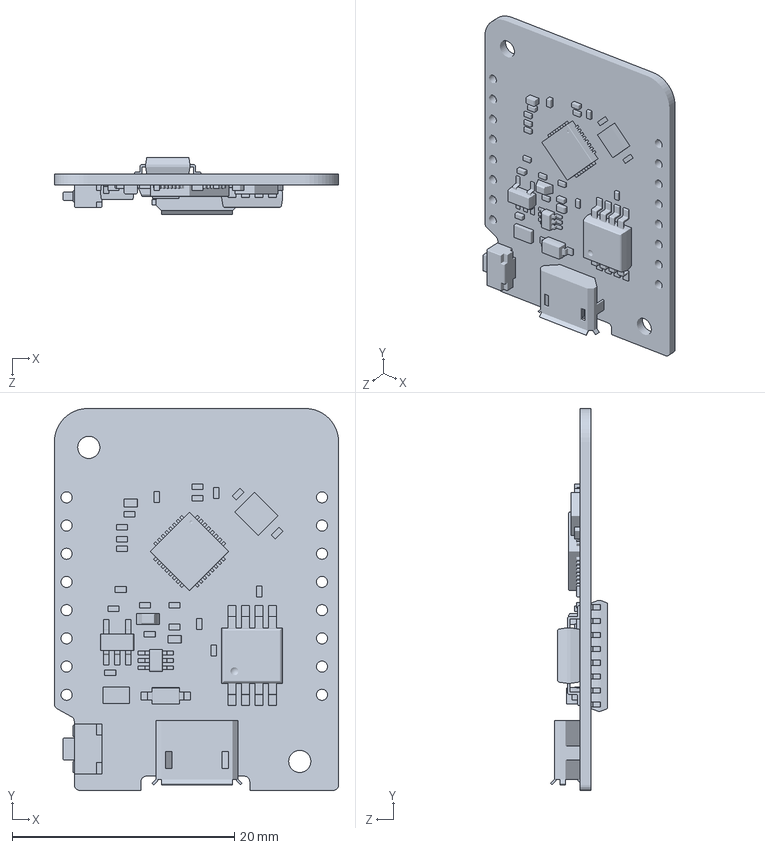
[picture p199: CAD file, 2022-12-01]
Mechanical/snake parts/d1miniv3.SLDPRT
25.6 x 34.4 x 5.15 mm
