PythonOrC/ISEF/Mechanical/snake parts/二代模具 v7.stl

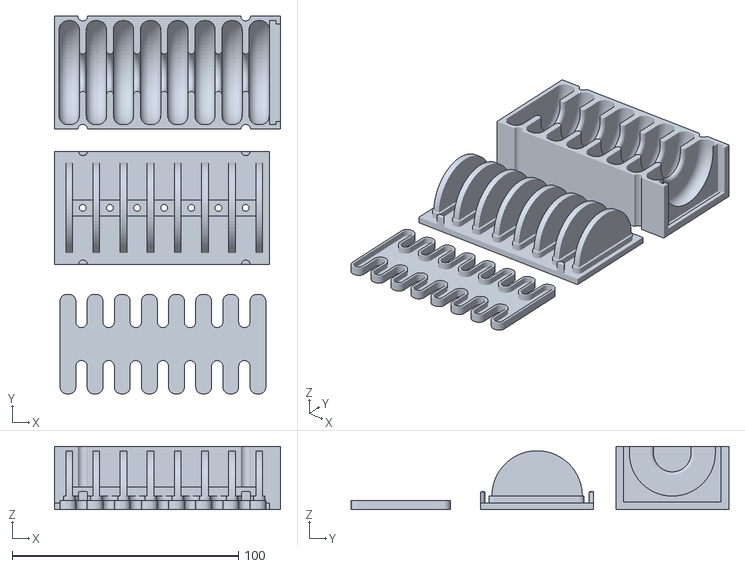
[picture p200: CAD file, 2022-12-01]
Mechanical/snake parts/二代模具 v7.stl
99.9 x 167.0 x 28.0
