PythonOrC/ISEF/Mechanical/snake parts/standoff.SLDPRT

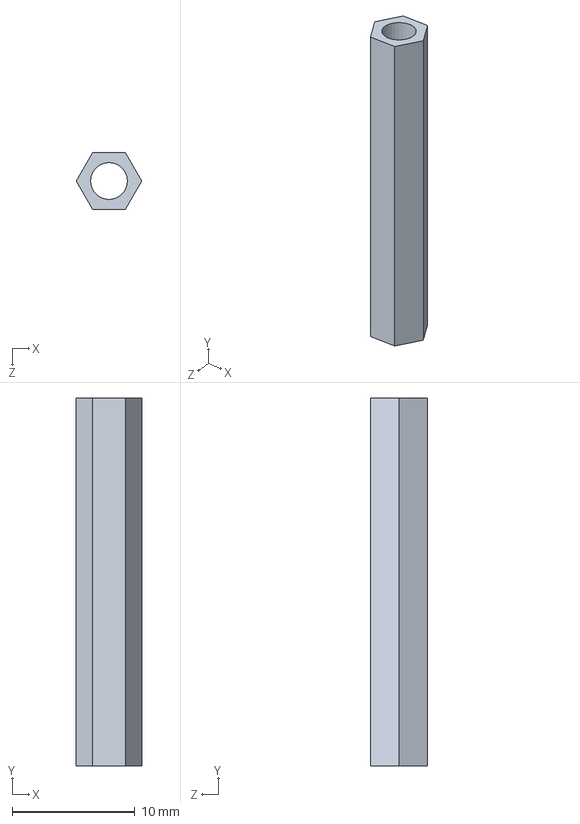
[picture p201: CAD file, 2022-12-01]
Mechanical/snake parts/standoff.SLDPRT
5.35 x 30.0 x 4.63 mm
