PythonOrC/ISEF/Mechanical/snake parts/plates_contour.dxf

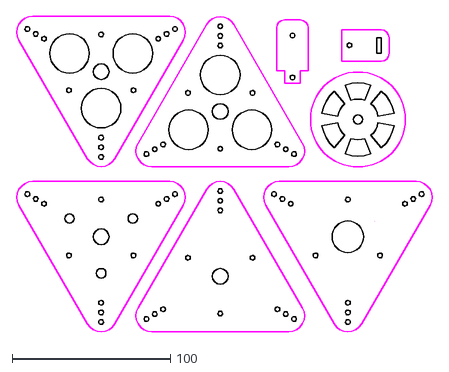
[picture p202: CAD file, 2022-12-01]
Mechanical/snake parts/plates_contour.dxf
263.4 x 199.4
