PythonOrC/ISEF/Mechanical/snake parts/wheel.SLDPRT

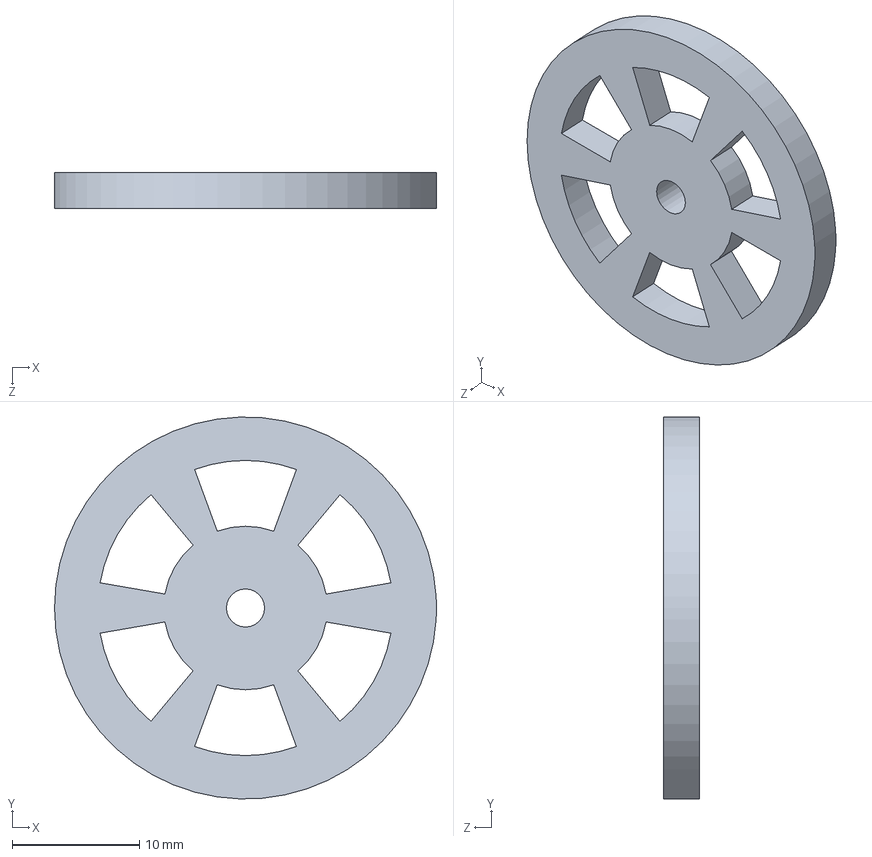
[picture p203: CAD file, 2022-12-01]
Mechanical/snake parts/wheel.SLDPRT
30.0 x 30.0 x 2.80 mm
