PythonOrC/ISEF/Mechanical/snake parts/valve v6.step

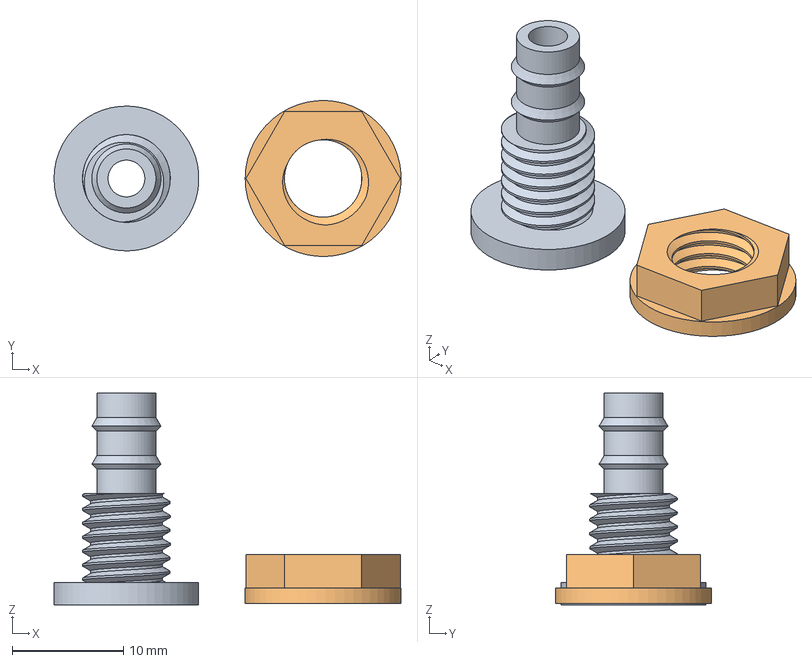
[picture p204: CAD file, 2022-12-01]
Mechanical/snake parts/valve v6.step
31.1 x 14.0 x 19.0 mm
