PythonOrC/ISEF/Mechanical/snake parts/snake segment.SLDPRT

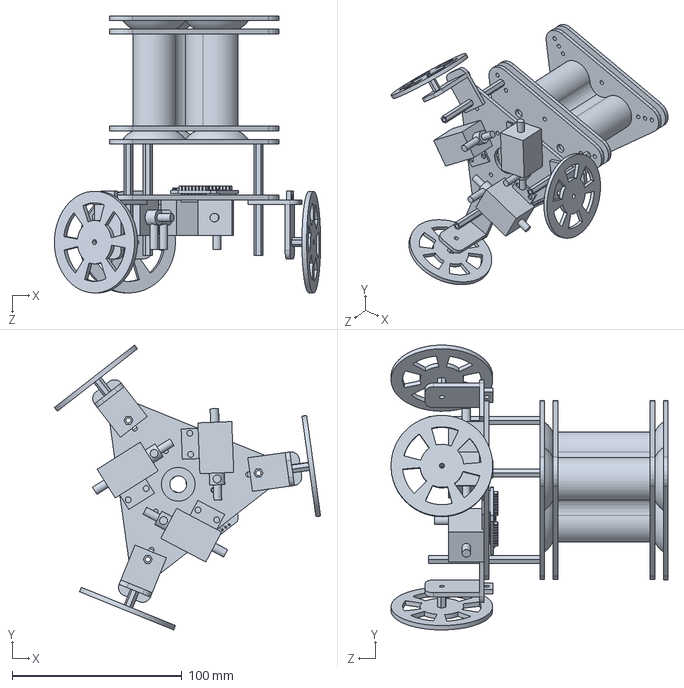
[picture p205: CAD file, 2022-12-01]
Mechanical/snake parts/snake segment.SLDPRT
157.0 x 168.0 x 163.4 mm
