PythonOrC/ISEF/Mechanical/snake parts/plate 4.SLDPRT

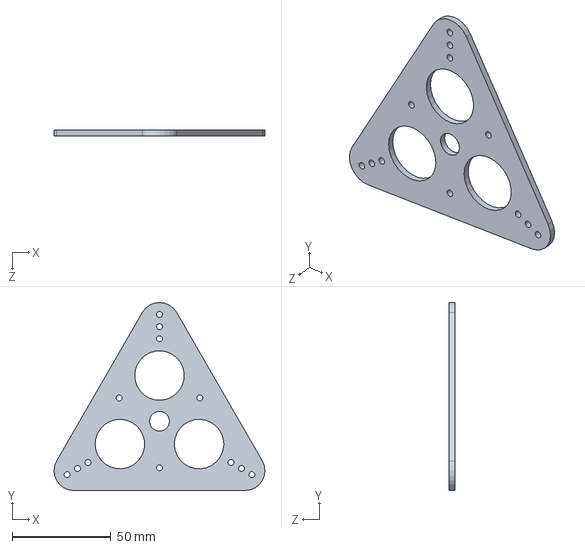
[picture p207: CAD file, 2022-12-01]
Mechanical/snake parts/plate 4.SLDPRT
106.6 x 95.0 x 2.80 mm
