PythonOrC/ISEF/(list of files, cad)

Other CAD files:
Electronic/ESP8266_EV.dwg
Mechanical/snake parts/wheel hold 1.SLDPRT
Mechanical/phone stand.dwg
Mechanical/snake parts/Part13.SLDPRT
Mechanical/plate outer.dwg
Mechanical/cover.dxf
Mechanical/Part1 v1.step
Mechanical/snake parts/plates.SLDPRT
Mechanical/snake parts/circular stopper.dxf
Mechanical/snake parts/plate 2.SLDPRT
Mechanical/snake parts/wheels.dxf
Mechanical/snake parts/plate.dwg
Mechanical/snake parts/wheelsv2.dxf
Mechanical/snake parts/plate 3.SLDPRT
Mechanical/Part1 v1.stl
Mechanical/cover.dwg
Mechanical/inner d14v11.f3d
Mechanical/inner d17 v5.stl
Mechanical/simulation/d14w5/d14.prt
Mechanical/simulation/d14w5/d14w5.x_t
Mechanical/simulation/d15w4/d15w4.x_t
Mechanical/simulation/d15w5/Job-1.prt
Mechanical/simulation/d15w5/one-chamber.prt
Mechanical/simulation/d15w5/two-chamber.prt
Mechanical/simulation/d15w6/Job-1.prt
Mechanical/simulation/d15w6/d15w6.x_t
Mechanical/simulation/d16w5/Job-1.prt
Mechanical/simulation/d16w5/d16w5.x_t
Mechanical/snake parts/Assem.SLDPRT
Mechanical/snake parts/air.DWG
Mechanical/snake parts/air.SLDDRW
Mechanical/snake parts/circular stopper.dwg
Mechanical/snake parts/d1miniv3.stl
Mechanical/snake parts/inner d15 v18.stl
Mechanical/snake parts/inner d15 v23.stl
Mechanical/snake parts/plates.dwg
Mechanical/snake parts/plates.dxf
Mechanical/snake parts/silicon final v1.x_t
Mechanical/snake parts/valve v3.stl
Mechanical/snake parts/valve v4.stl
Mechanical/snake parts/valve v6.stl
Mechanical/snake parts/wheelsv2.dwg
Mechanical/snake parts/二代模具 v5.stl
Mechanical/snake parts/二代模具 v8.f3d
Mechanical/snake parts/二代气囊/二代模具 v3.stl
inner d15 v28.f3z
stick v4.f3d
