PythonOrC/ISEF/Mechanical/footage/改良模具组装.jpg

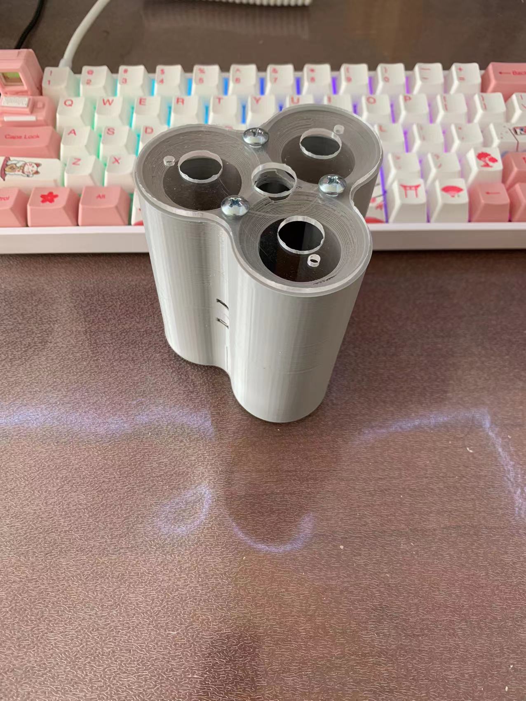
Mechanical/footage/改良模具组装.jpg
