PythonOrC/ISEF/Simulation Result/diameter/d15w5 t1-a.png

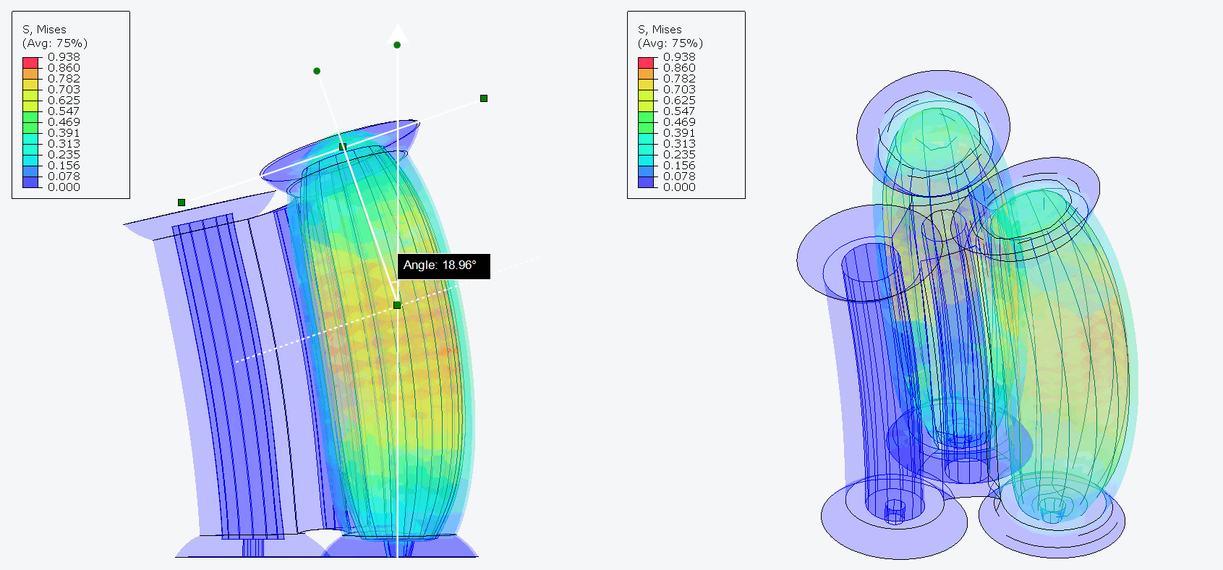
Simulation Result/diameter/d15w5 t1-a.png
