PythonOrC/ISEF/Simulation Result/wall/d15w4 t2-a.png

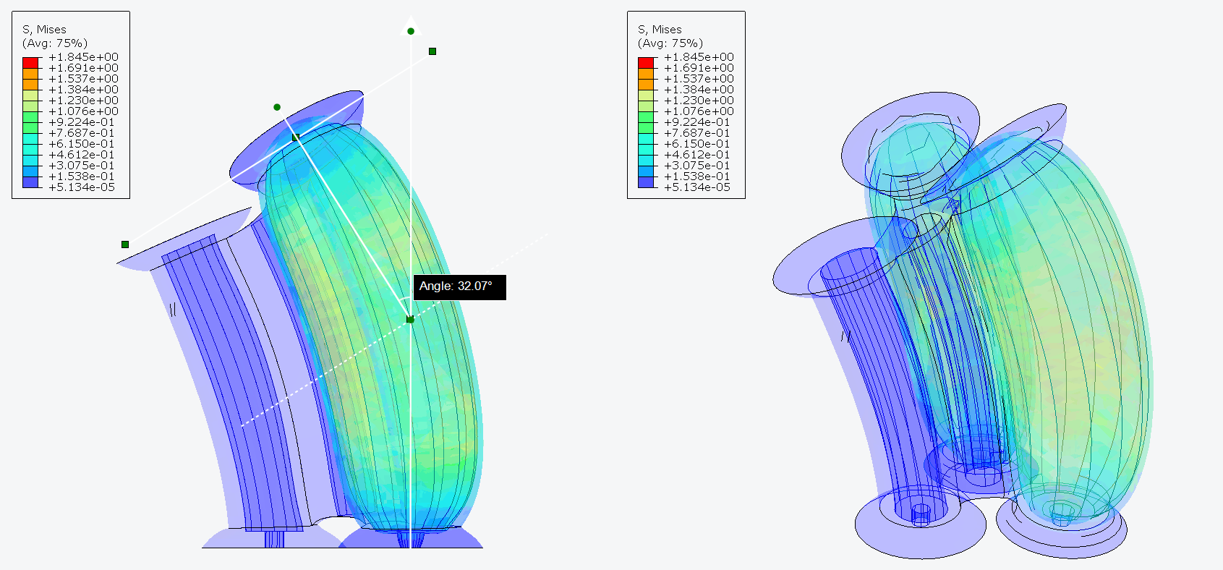
Simulation Result/wall/d15w4 t2-a.png
