PythonOrC/ISEF/Simulation Result/wall/d15w4 t4-a.png

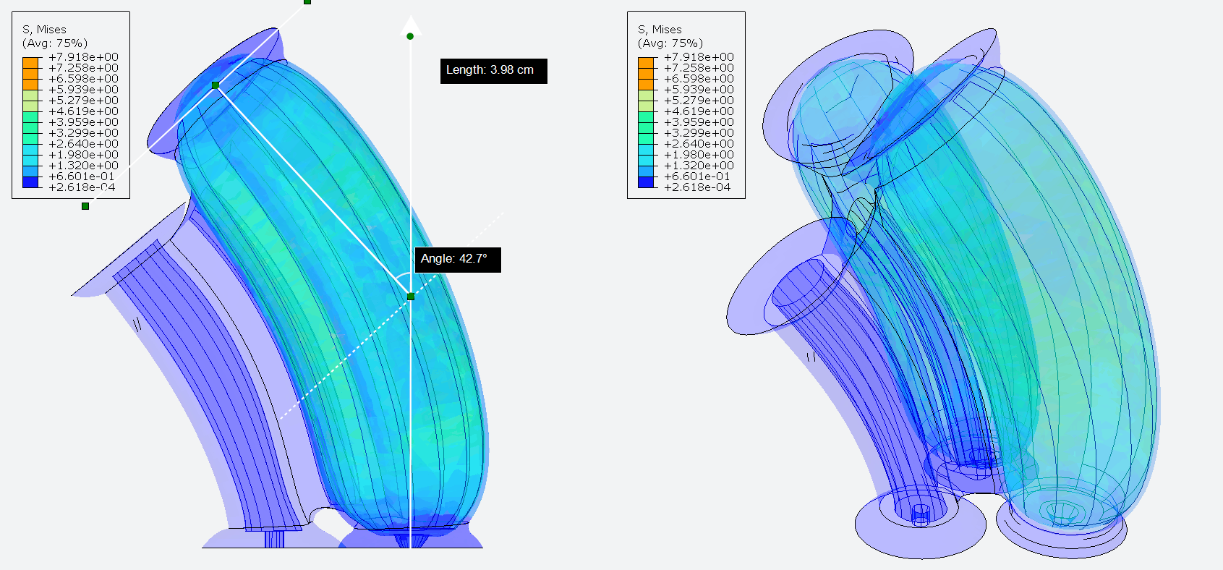
Simulation Result/wall/d15w4 t4-a.png
