PythonOrC/ISEF/Electronic/ESP8266_EV.pdf

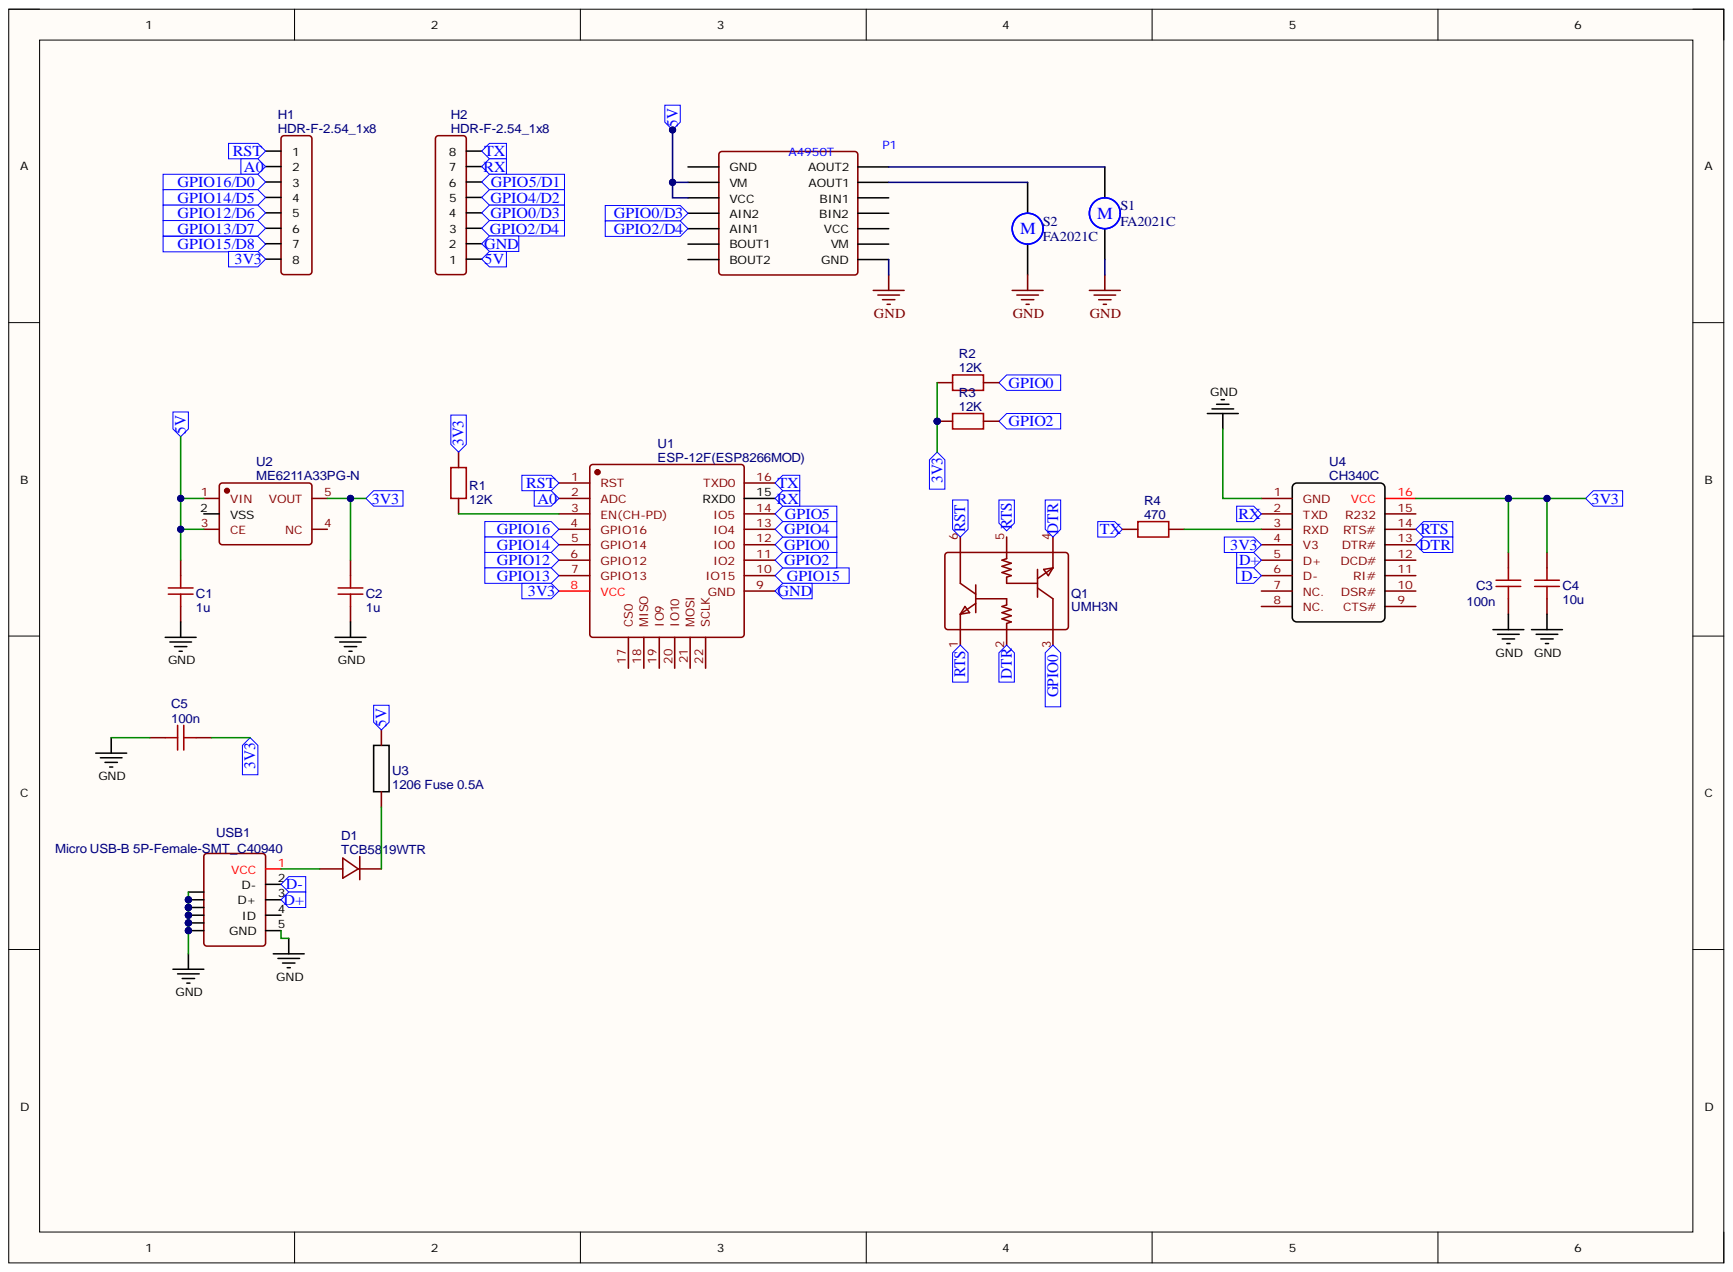
[picture p212: page 1]
