PythonOrC/ISEF/Electronic/ESP8266_EV_NPN.pdf

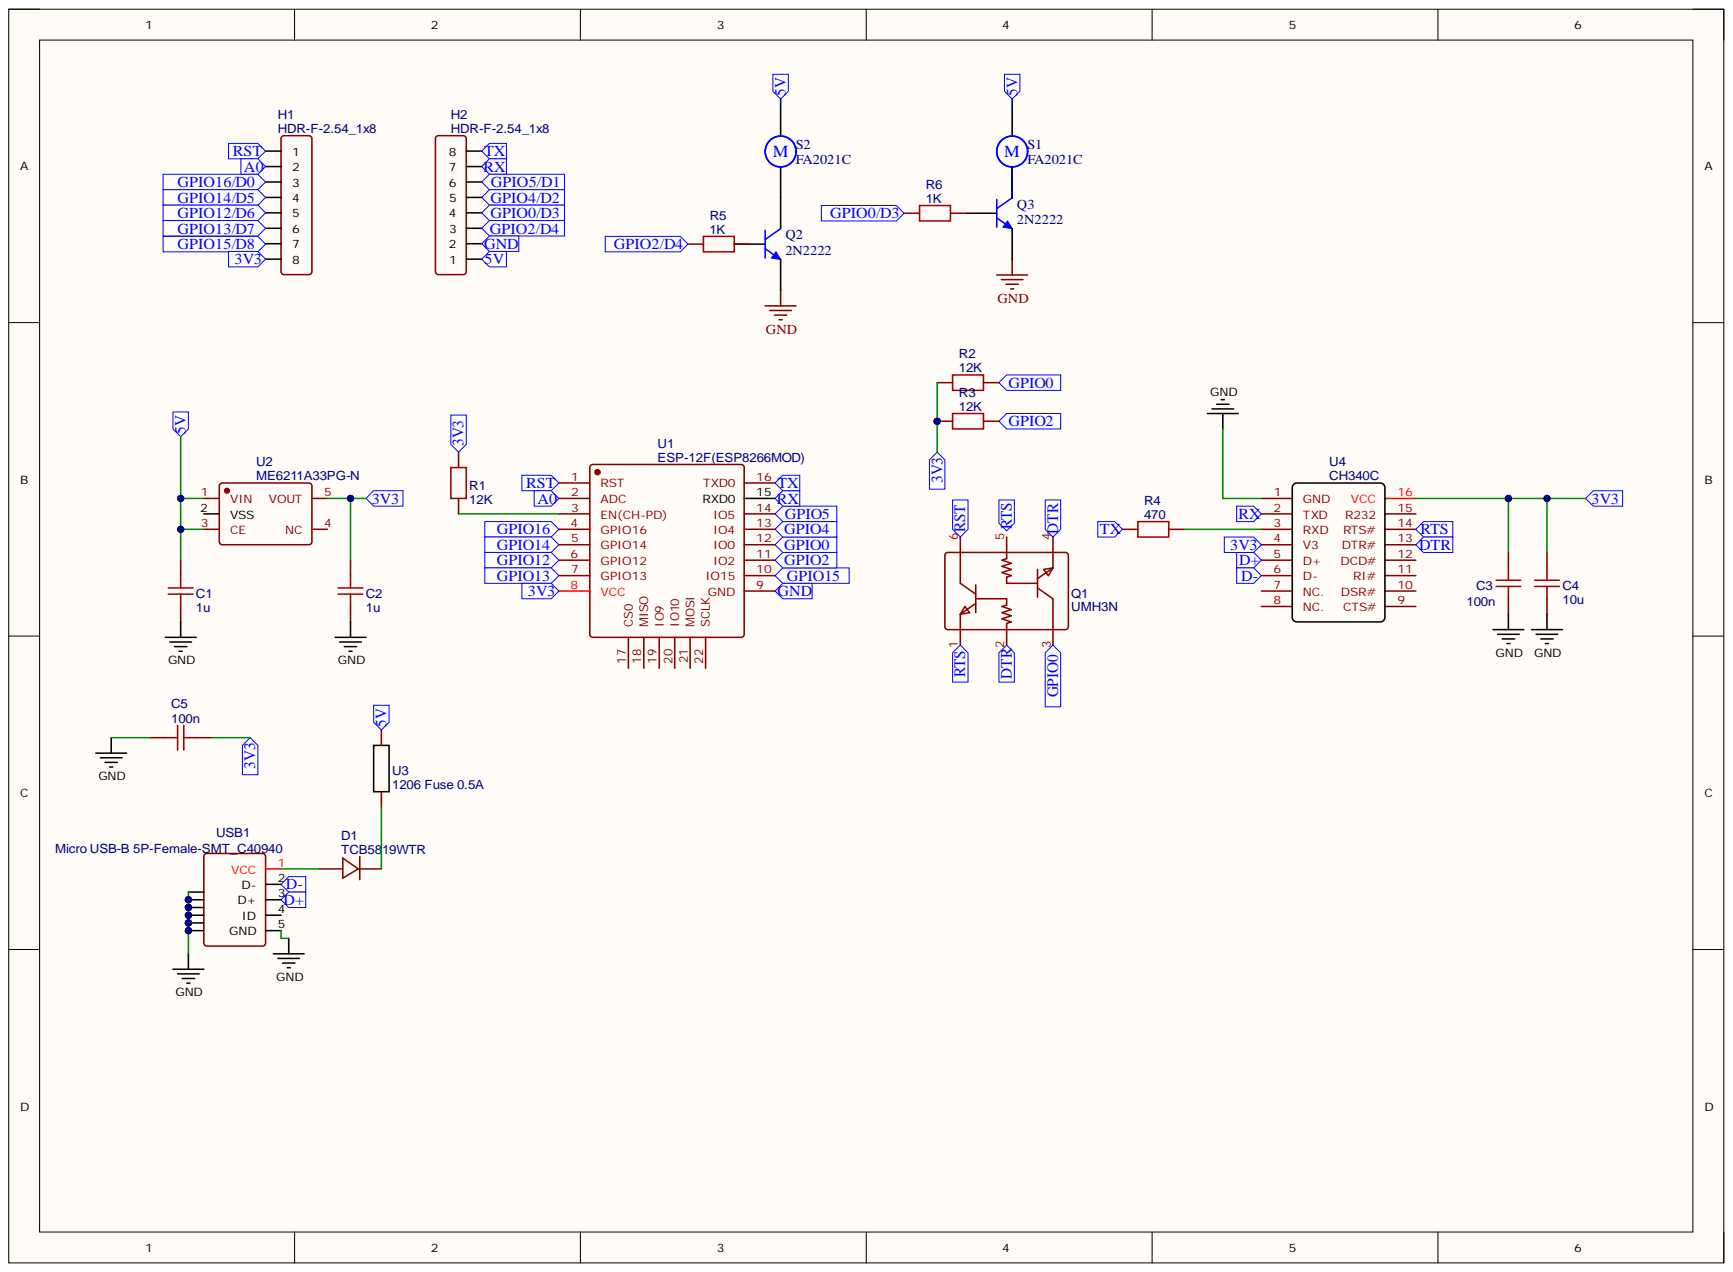
[picture p213: page 1]
