PythonOrC/ISEF/GO Paper/images/pneumatic circuit design.pdf

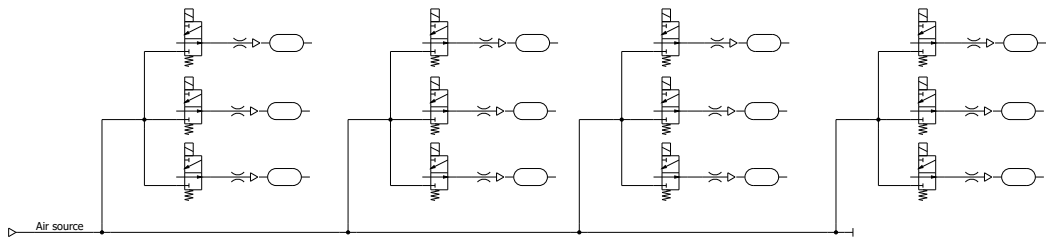
[picture p214: page 1]
Air source
