PythonOrC/ISEF/GO Paper/images/snake segment board circuit diagram.pdf

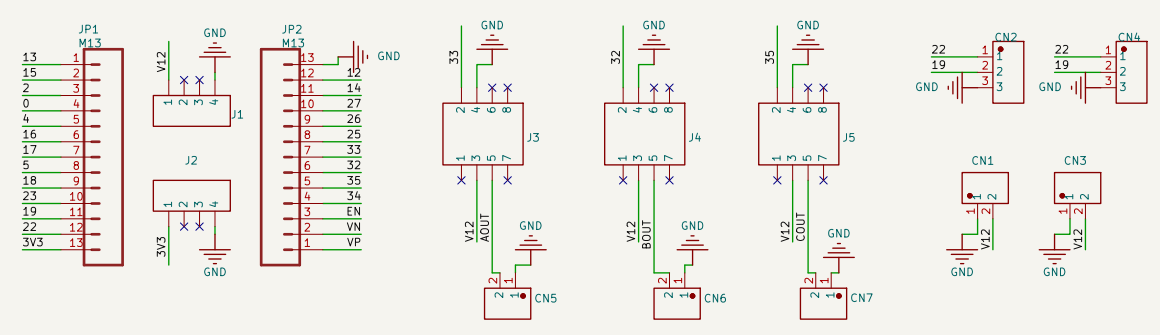
[picture p215: page 1]
