PythonOrC/ISEF/Research Paper/images/snake segment board circuit diagram.pdf

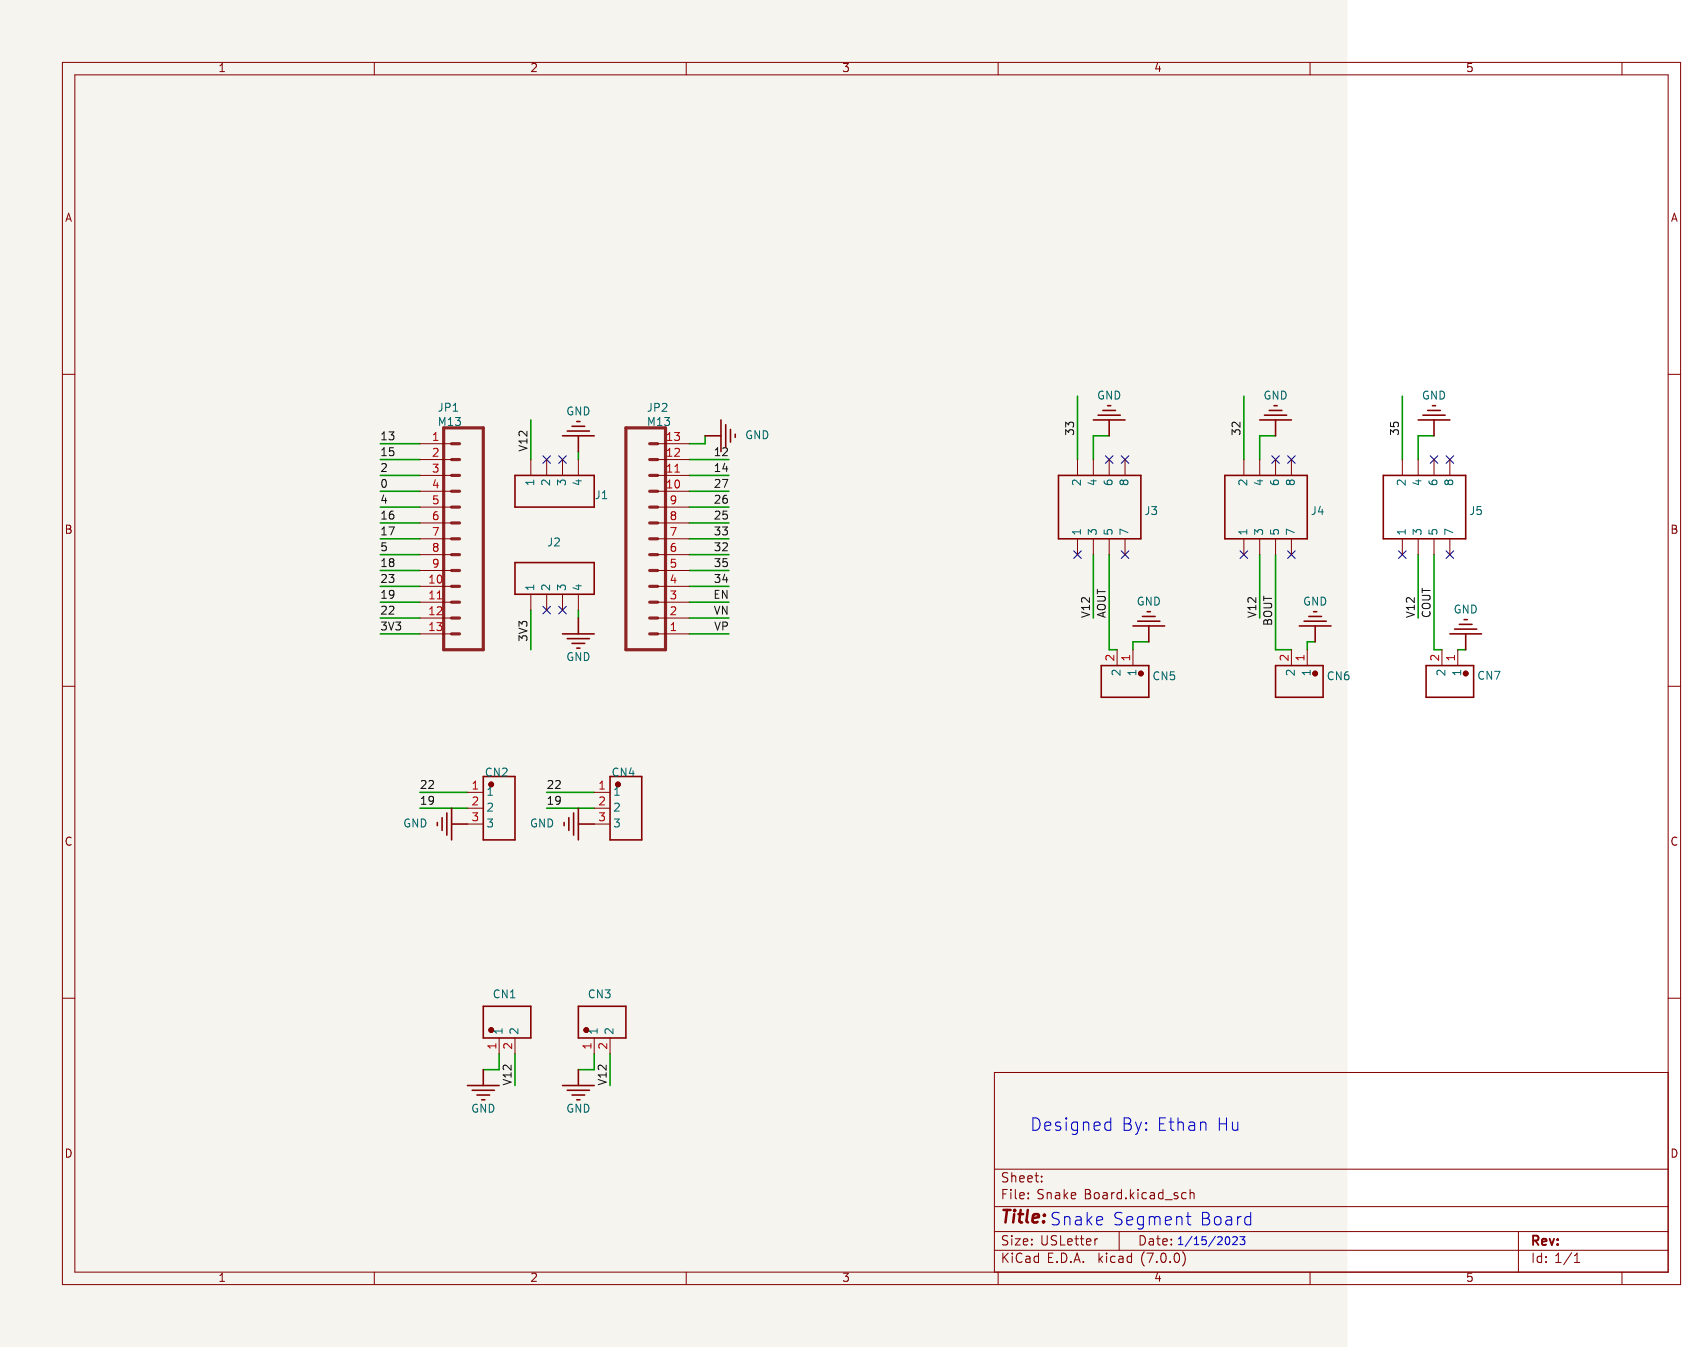
[picture p216: page 1]
