PythonOrC/ISEF/GO Paper/images/electric circuit diagram.pdf

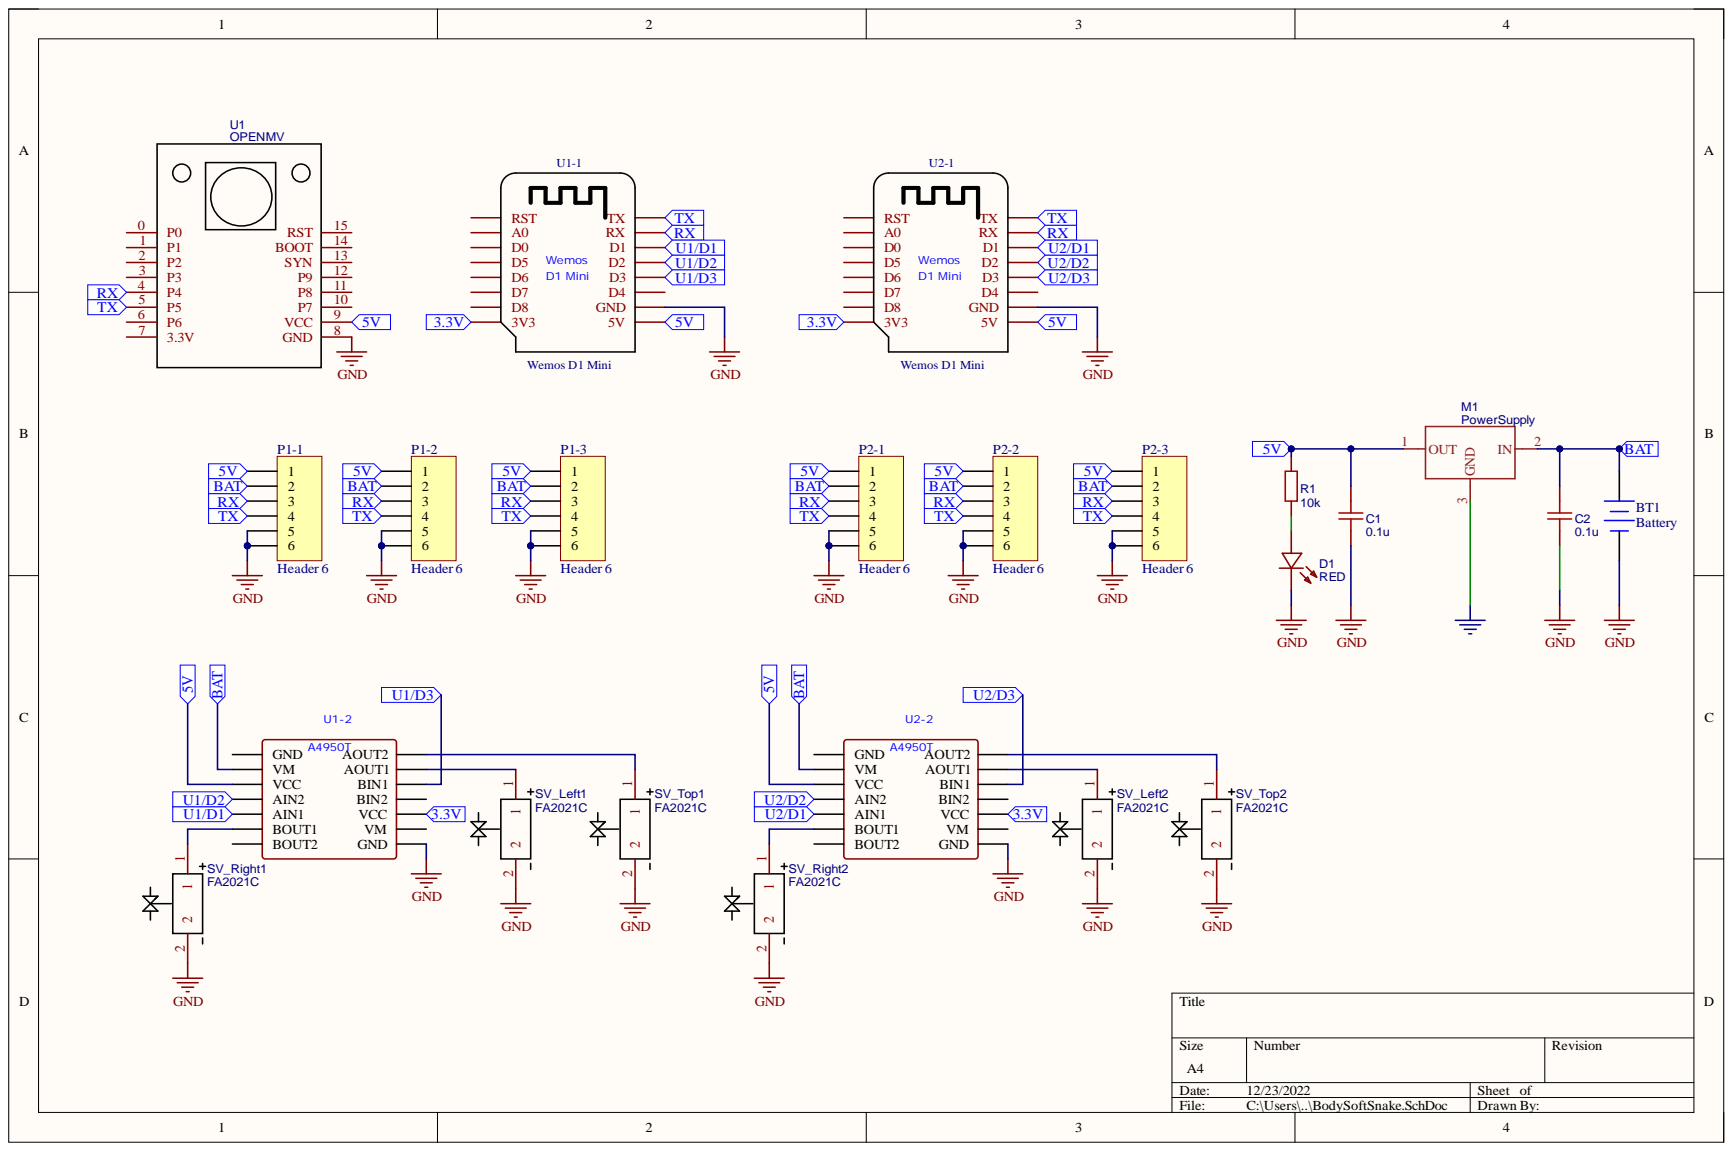
[picture p217: page 1]

Size A4 | Number | Revision

Date: 12/23/2022 | Sheet of
File: C:\Users\..\BodySoftSnake.SchDoc | Drawn By:
