PythonOrC/ISEF/(list of files, drawings)

Other design files:
Electronic/ESP8266_EV.schdoc
Electronic/ESP8266_EV_NPN.schdoc
GO Paper/wiring diagram.fzz
Research Paper/wiring diagram.fzz
