PythonOrC/ISEF/Snake Board/Snake Board.kicad_pcb

## KiCad design truck bed led pcb/Timer_Circuit.kicad_sch

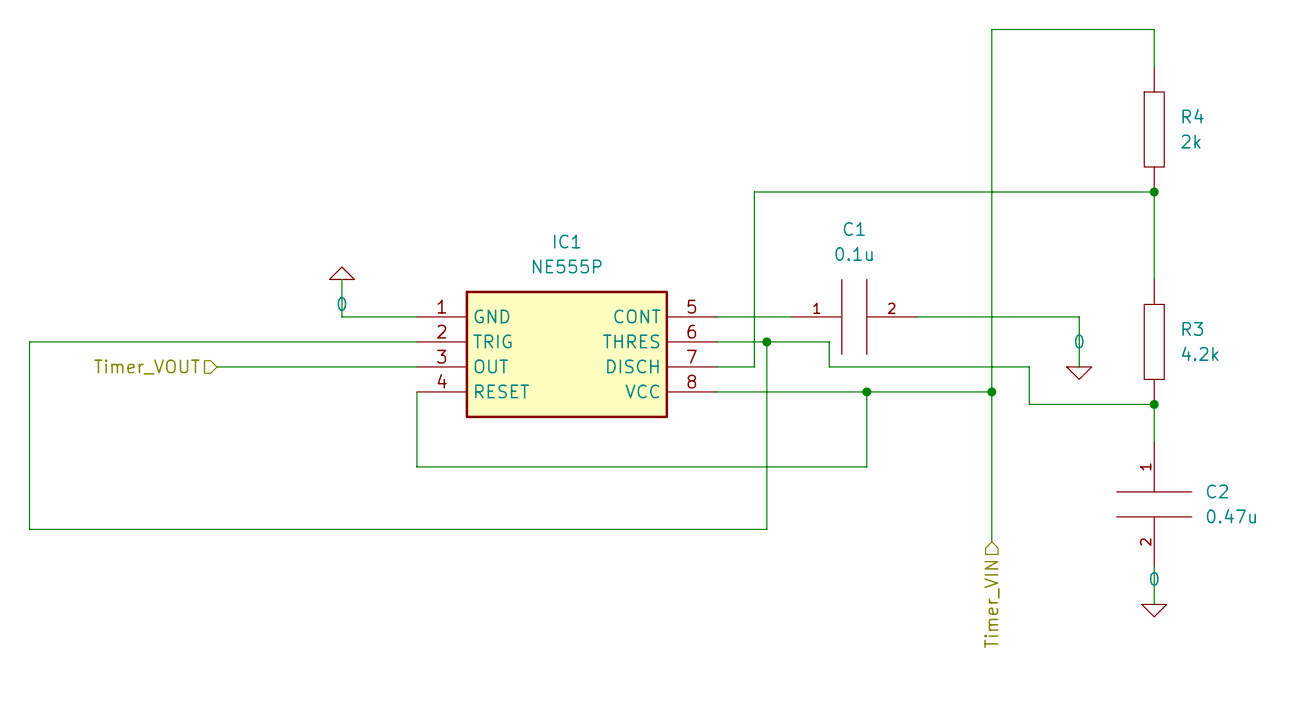
[picture p218: schematic Timer_Circuit.kicad_sch]

Parts:
C1: 0.1u
C2: 0.47u
IC1: NE555P; DIP794W53P254L959H508Q8N; Mouser Part Number 595-NE555P
R3: 4.2k
R4: 2k

Connections:
0: C1.2, C2.2, IC1.1 (GND)
unnamed: C1.1, IC1.5 (CONT)
unnamed: C2.1, IC1.2 (TRIG), IC1.6 (THRES), R3.2
unnamed: IC1.7 (DISCH), R3.1, R4.2
Timer_VIN: IC1.4 (RESET), IC1.8 (VCC), R4.1
Timer_VOUT: IC1.3 (OUT)
