PythonOrC/ISEF/Snake Board/Snake Board.kicad_pcb

## KiCad design truck bed led pcb/led_switching_circuit.kicad_sch

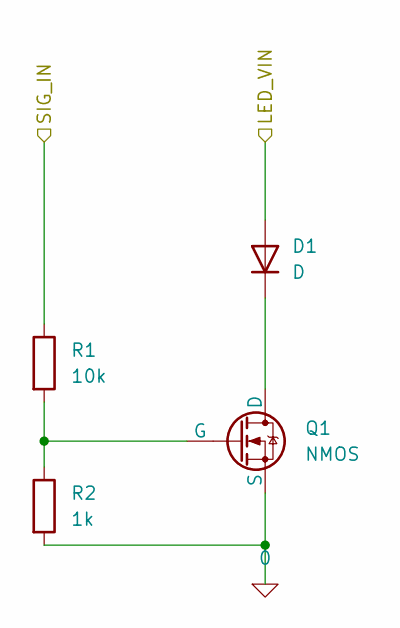
[picture p219: schematic led_switching_circuit.kicad_sch]

Parts:
D1: D
Q1: NMOS
R1: 10k
R2: 1k

Connections:
0: Q1.3 (S), R2.2
LED_VIN: D1.2 (A)
unnamed: D1.1 (K), Q1.1 (D)
unnamed: Q1.2 (G), R1.2, R2.1
SIG_IN: R1.1
