PythonOrC/ISEF/Electronic/openmv/arduino_uart_1.py

# Basic UART communications between OpenMV and Arduino Uno.

# 1) Wire up your OpenMV Cam to your Arduino Uno like this:
#
# OpenMV Cam Ground Pin   ----> Arduino Ground
# OpenMV Cam UART3_TX(P4) ----> Arduino Uno UART_RX(0)
# OpenMV Cam UART3_RX(P5) ----> Arduino Uno UART_TX(1)

# 2) Uncomment and upload the following sketch to Arduino:
#
# void setup() {
#   // put your setup code here, to run once:
#   Serial.begin(19200);
# }
#
# void loop() {
#   // put your main code here, to run repeatedly:
#   if (Serial.available()) {
#     // Read the most recent byte
#     byte byteRead = Serial.read();
#     // ECHO the value that was read
#     Serial.write(byteRead);
#   }
# }

# 3) Run the following script in OpenMV IDE:

import time
from pyb import UART

# UART 3, and baudrate.
uart = UART(3, 115200)
i=0
while True:
    i= i+1 if i != 9 else 0
    print(str(i))
    uart.write(str(i))
#while(True):
    #uart.write("B")
    #uart.write("L")
    #time.sleep(0.5)
    #uart.write("B")
    #uart.write("S")
    #if (uart.any()):
        #print(uart.read())
    #time.sleep_ms(1000)
