PythonOrC/ISEF/(commit log)

2022-12-01 added mechanic
    [ESP8266_EV.dwg, ESP8266_EV.schdoc, ESP8266_EV_NPN.schdoc]
2022-12-01 added some mechanical
    [Job-1.prt, Part1 v1.step, Part1 v1.stl, base v2.stl, bottom slice v2.stl, case bottom v7.stl, case top v3.stl, cover.dwg]
2022-12-01 added cad files
    [1cm standoff.SLDPRT, Assem.SLDASM, Assem.SLDPRT, Assem1.SLDASM, Part1.SLDPRT, Part13.SLDPRT, air.DWG, air.SLDDRW]
